ultrazohm/uz_d_voltage/Project Outputs for UZ_D_Voltage/Rev04/BOM/BOM_JLC-UZ_D_Voltage(3V3_to_RS422_output).xlsx

Quantity | Comment | Designator | Manufacturer | Value | Description | Footprint | Voltage | Dielectric | Manufacturer Part Number | LCSC Part Number
8 | 0.1 µF | C5A, C5B, C5C, C5D, C5E, C5F, C5G, C5H | KEMET | 0.1 µF | Capacitor 0603, 50 VDC, 0.1 µF, X7R | C_0603 |  |  | C0603X104K5RAC7411 | C14663
1 | #NAME? | D1 | Hubei KENTO Elec |  | LED RED 520~625NM 90~100MCD@20MA TOP VIEW 0603 ROHS | WL-SMCW_0603 |  |  | KT-0603R | C2286
61 | 0R | R1, R51, R52, R53, R54, R55, R56, R57, R58, R59, R60, R61, R62, R63, R64, R65, R66, R67, R68, R69, R70, R71, R72, R73, R74, R75, R76, R77, R78, R79, R80, R144, R145, R146, R147, R148, R149, R150, R151, R152, R153, R154, R155, R156, R157, R158, R159, R160, R161, R162, R163, R164, R165, R166, R167, R168, R169, R170, R171, R172, R173 | YAGEO | 0R | SMD resistor E24 series | RES 0603_1608 |  |  | RC0603JR-070RL | C21189
1 | 470R | R9 | KOA Speer | 470R | SMD resistor E24 series | RES 0603_1608 |  |  | RK73B1JTTD471J | C23179
60 | 47R | R81, R82, R83, R84, R85, R86, R87, R88, R89, R90, R91, R92, R93, R94, R95, R96, R97, R98, R99, R100, R101, R102, R103, R104, R105, R106, R107, R108, R109, R110, R111, R112, R113, R114, R115, R116, R117, R118, R119, R120, R121, R122, R123, R124, R125, R126, R127, R128, R129, R130, R131, R132, R133, R134, R135, R136, R137, R138, R139, R140 | KOA Speer | 47R | SMD resistor E24 series | RES 0603_1608 |  |  | RK73B1JTTDD470J | C23182
8 | DS26C31TMX/NOPB | U3A, U3B, U3C, U3D, U3E, U3F, U3G, U3H | Texas Instruments |  | CMOS Quad Tri-State Differential Line Drivers, 16-pin Narrow SOIC, Pb-Free | TI_D-R-PDSO-G16_N |  |  | DS26C31TMX/NOPB | C132085
1 | IPL1-115-01-L-D-RA-K | X2 | SAMTEC |  | Terminal Assembly, Double Row, Right Angle, Thru-Hole, 2.54 mm x 2.54 mm Pitch, 30 Pins | IPL1-115-01-XX-D-RA |  |  | IPL1-115-01-L-D-RA-K
1 | IPL1-120-01-L-D-RA-K | X3 | SAMTEC |  | Terminal Assembly, Double Row, Right Angle, Thru-Hole, 2.54 mm x 2.54 mm Pitch, 40 Pins | IPL1-120-01-XX-D-RA |  |  | IPL1-120-01-L-D-RA-K
