ultrazohm/uz_d_voltage/Project Outputs for UZ_D_Voltage/2v01/BOM/BOM_UltraZohm_DigitalVoltage_3V3_to_3V3_IO.xls

Sheet: Part List Report
 | Bill of Material |  |  | BOM_UltraZohm_Digital_Voltage_3V3_IO for Variant [3V3_to_3V3_IO] of BOM Document [UltraZohm_DigitalVoltage_ActiveBom.BomDoc]
 | Source Data From: |  | UltraZohm_DigitalVoltage_ActiveBom.BomDoc
 | Project: |  | ultrazohm_digital_voltage_3U_1vxx.PrjPCB
 | Variant: |  | 3V3_to_3V3_IO
 | Report Date: |  |  |  | 18.08.2020 | 18:56
 | Print Date: |  |  |  | 2020-08-18 | 18:56:55
# | Quantity | Name | Designator | MF | MPN | Value | Description | Footprint | Package | #Column Name Error:' Voltage | #Column Name Error:' Dielectric | Supplier 1 | Supplier Part Number 1 | #Column Name Error:' Supplier 2 | #Column Name Error:' Supplier Part Number 2 | Supplier 3 | #Column Name Error:' Supplier Part Number 3 | Fabrication Notes
1 | 1 | LED_Amber | D1 | Wuerth Elektronik | 150060AS75000 | 150060AS75000 | WL-SMCW SMD Mono-color Chip LED Waterclear, size 0603, Red, 2 V, 140° | WL-SMCW_0603 | 0603 |  |  | Digi-Key | 732-150060AS75000CT-ND |  |  | Farnell
2 | 90 | R_TF | R3A, R3B, R3C, R3D, R3E, R4A, R4B, R4C, R4D, R4E, R5A, R5B, R5C, R5D, R5E, R6A, R6B, R6C, R6D, R6E, R7A, R7B, R7C, R7D, R7E, R8A, R8B, R8C, R8D, R8E, R21, R22, R23, R24, R25, R26, R27, R28, R29, R30, R31, R32, R33, R34, R35, R36, R37, R38, R39, R40, R41, R42, R43, R44, R45, R46, R47, R48, R49, R50, R51, R52, R53, R54, R55, R56, R57, R58, R59, R60, R61, R62, R63, R64, R65, R66, R67, R68, R69, R70, R71, R72, R73, R74, R75, R76, R77, R78, R79, R80 | Panasonic | ERJU030R00V | 0 | Standard thick film resistor | RESC_0603 | CurrentFootprint |  |  | Mouser | 667-ERJ-U030R00V
3 | 2 | R_TF | R9, R10 | Panasonic | ERJU03F5601V | 5k6 | Standard thick film resistor | RESC_0603 | RESC_0603 |  |  | Mouser | 667-ERJ-U03F5601V
4 | 30 | R_TF | R82, R84, R85, R87, R90, R92, R93, R95, R98, R100, R101, R103, R106, R108, R109, R111, R114, R116, R117, R119, R122, R124, R125, R127, R130, R132, R133, R135, R138, R139 | Panasonic | ERJU03F91R0V | 91 | Standard thick film resistor | RESC_0603 | CurrentFootprint |  |  | RSComponents | 8739618
Total: | 123 |  |  |  |  | Notes

Sheet: Project Information
Project Full Path | C:\Users\Thilo Wendt\Documents\altium\ultrazohm_digital_voltage_3U_1vxx\ultrazohm_digital_voltage_3U_1vxx.PrjPCB
Project Filename | ultrazohm_digital_voltage_3U_1vxx.PrjPCB
Variant Name | 3V3_to_3V3_IO
Data-Source Filename | UltraZohm_DigitalVoltage_ActiveBom.BomDoc
Data-Source Full Path | C:\Users\Thilo Wendt\Documents\altium\ultrazohm_digital_voltage_3U_1vxx\UltraZohm_DigitalVoltage_ActiveBom.BomDoc
Title | BOM_UltraZohm_Digital_Voltage_3V3_IO for Variant [3V3_to_3V3_IO] of BOM Document [UltraZohm_DigitalVoltage_ActiveBom.BomDoc]
Total Quantity | 123
Report Time | 18:56
Report Date | 18.08.2020
Report Date & Tine | 18.08.2020 18:56
Output Name | BOM_UltraZohm_Digital_Voltage_3V3_IO
Output Type | BOM_PartType
Output Generator Name | BOM
Output Generator Description | Bill of Materials
