ultrazohm/uz_d_voltage/Project Outputs for UZ_D_Voltage/2v01/BOM/BOM_UltraZohm_DigitalVoltage_3V3_to_5V_IO.xls

Sheet: Part List Report
 | Bill of Material |  |  | BOM_UltraZohm_Digital_Voltage_5V_IO for Variant [3V3_to_5V_IO] of BOM Document [UltraZohm_DigitalVoltage_ActiveBom.BomDoc]
 | Source Data From: |  | UltraZohm_DigitalVoltage_ActiveBom.BomDoc
 | Project: |  | ultrazohm_digital_voltage_3U_1vxx.PrjPCB
 | Variant: |  | 3V3_to_5V_IO
 | Report Date: |  |  |  | 18.08.2020 | 18:56
 | Print Date: |  |  |  | 2020-08-18 | 18:57:01
# | Quantity | Name | Designator | MF | MPN | Value | Description | Footprint | Package | #Column Name Error:' Voltage | #Column Name Error:' Dielectric | Supplier 1 | Supplier Part Number 1 | Supplier 2 | Supplier Part Number 2 | #Column Name Error:' Supplier 3 | #Column Name Error:' Supplier Part Number 3 | Fabrication Notes
1 | 8 | C_X7R | C1A, C1B, C2A, C2B, C3A, C3B, C4A, C4B | KEMET | C0603C104J3REC7411 | 100n | Standard X7R SMD capacitor. This kind of dielectricum should be used for decoupling applications. Bigger capacity is available but not for the given voltage rating. | CAPC_0603 | CurrentFootprint |  |  | Mouser | 80-C0603C104J3RE7411 | Mouser | 80-C0603C104J3RE7411
2 | 1 | LED_Blue | D1 | Wuerth Elektronik | 150060BS75000 | 150060BS75000 | WL-SMCW SMD Mono-color Chip LED Waterclear, size 0603, Blue, 3.2 V, 140° | WL-SMCW_0603 | 0603 |  |  | Digi-Key | 732-4966-1-ND
3 | 2 | R_TF | R1, R20 | Panasonic | ERJU030R00V | 0 | Solder resistor/jumper between pads 1 and 2 for standard function. Solder resistor between pads 2 and 3 for alternative function | RESC_0603_CONFIG | CurrentFootprint, RESC_0603_CONFIG |  |  | Mouser | 667-ERJ-U030R00V
4 | 60 | R_TF | R3A, R3B, R3C, R3D, R3E, R4A, R4B, R4C, R4D, R4E, R5A, R5B, R5C, R5D, R5E, R6A, R6B, R6C, R6D, R6E, R7A, R7B, R7C, R7D, R7E, R8A, R8B, R8C, R8D, R8E, R21, R22, R23, R24, R25, R26, R27, R28, R29, R30, R31, R32, R33, R34, R35, R36, R37, R38, R39, R40, R41, R42, R43, R44, R45, R46, R47, R48, R49, R50 | Panasonic | ERJU030R00V | 0 | Standard thick film resistor | RESC_0603 | CurrentFootprint |  |  | Mouser | 667-ERJ-U030R00V
5 | 11 | R_TF | R9, R10, R11, R16A, R16B, R17A, R17B, R18A, R18B, R19A, R19B | Panasonic | ERJU03F5601V | 5k6 | Standard thick film resistor | RESC_0603 | RESC_0603, CurrentFootprint |  |  | Mouser | 667-ERJ-U03F5601V
6 | 30 | R_TF | R82, R84, R85, R87, R90, R92, R93, R95, R98, R100, R101, R103, R106, R108, R109, R111, R114, R116, R117, R119, R122, R124, R125, R127, R130, R132, R133, R135, R138, R139 | Panasonic | ERJU03F91R0V | 91 | Standard thick film resistor | RESC_0603 | CurrentFootprint |  |  | RSComponents | 8739618
7 | 1 | 74AHC1G14GW,125 | U1 |  |  | 74AHC1G14GW,125 | Inverting Schmitt trigger for 2 V to 5.5 V | NXP-SOT353-1_N |  |  |  | Mouser | 771-74AHC1G14GW-G
8 | 2 | SN74LVCH16T245DLR | U6A, U6B | Texas Instruments | SN74LVCH16T245DLR | SN74LVCH16T245DLR | Direction controlled 16 channel level shifter with active driver. Voltage range 1.8V to 5V. | TI_DL-R-PDSO-G48_N | CurrentFootprint |  |  | Mouser | 595-SN74LVCH16T245LR
Total: | 115 |  |  |  |  | Notes

Sheet: Project Information
Project Full Path | C:\Users\Thilo Wendt\Documents\altium\ultrazohm_digital_voltage_3U_1vxx\ultrazohm_digital_voltage_3U_1vxx.PrjPCB
Project Filename | ultrazohm_digital_voltage_3U_1vxx.PrjPCB
Variant Name | 3V3_to_5V_IO
Data-Source Filename | UltraZohm_DigitalVoltage_ActiveBom.BomDoc
Data-Source Full Path | C:\Users\Thilo Wendt\Documents\altium\ultrazohm_digital_voltage_3U_1vxx\UltraZohm_DigitalVoltage_ActiveBom.BomDoc
Title | BOM_UltraZohm_Digital_Voltage_5V_IO for Variant [3V3_to_5V_IO] of BOM Document [UltraZohm_DigitalVoltage_ActiveBom.BomDoc]
Total Quantity | 115
Report Time | 18:56
Report Date | 18.08.2020
Report Date & Tine | 18.08.2020 18:56
Output Name | BOM_UltraZohm_Digital_Voltage_5V_IO
Output Type | BOM_PartType
Output Generator Name | BOM
Output Generator Description | Bill of Materials
