ultrazohm/uz_d_voltage/Project Outputs for UZ_D_Voltage/2v01/BOM/BOM_UltraZohm_DigitalVoltage_3V3_to_RS422_output.xls

Sheet: Part List Report
 | Bill of Material |  |  | BOM_UltraZohm_Digital_Voltage_RS422_output for Variant [3V3_to_RS422_output] of BOM Document [UltraZohm_DigitalVoltage_ActiveBom.BomDoc]
 | Source Data From: |  | UltraZohm_DigitalVoltage_ActiveBom.BomDoc
 | Project: |  | ultrazohm_digital_voltage_3U_1vxx.PrjPCB
 | Variant: |  | 3V3_to_RS422_output
 | Report Date: |  |  |  | 18.08.2020 | 18:55
 | Print Date: |  |  |  | 2020-08-18 | 18:55:41
# | Quantity | Name | Designator | MF | MPN | Value | Description | Footprint | Package | #Column Name Error:' Voltage | #Column Name Error:' Dielectric | Supplier 1 | Supplier Part Number 1 | Supplier 2 | Supplier Part Number 2 | #Column Name Error:' Supplier 3 | #Column Name Error:' Supplier Part Number 3 | Fabrication Notes
1 | 8 | C_X7R | C5A, C5B, C5C, C5D, C5E, C5F, C5G, C5H | KEMET | C0603C104J3REC7411 | 100n | Standard X7R SMD capacitor. This kind of dielectricum should be used for decoupling applications. Bigger capacity is available but not for the given voltage rating. | CAPC_0603 | CurrentFootprint |  |  | Mouser | 80-C0603C104J3RE7411 | Mouser | 80-C0603C104J3RE7411
2 | 1 | LED_red | D1 | Wuerth Elektronik | 150060RS75000 | 150060RS75000 | WL-SMCW SMD Mono-color Chip LED Waterclear, size 0603, Red, 2 V, 140° | WL-SMCW_0603 | 0603 |  |  | Digi-Key | 732-4978-1-ND
3 | 2 | R_TF | R9, R10 | Panasonic | ERJU03F5601V | 5k6 | Standard thick film resistor | RESC_0603 | RESC_0603 |  |  | Mouser | 667-ERJ-U03F5601V
4 | 1 | R_TF | R20 | Panasonic | ERJU030R00V | 0 | Solder resistor/jumper between pads 1 and 2 for standard function. Solder resistor between pads 2 and 3 for alternative function | RESC_0603_CONFIG | RESC_0603_CONFIG |  |  | Mouser | 667-ERJ-U030R00V
5 | 30 | R_TF | R51, R52, R53, R54, R55, R56, R57, R58, R59, R60, R61, R62, R63, R64, R65, R66, R67, R68, R69, R70, R71, R72, R73, R74, R75, R76, R77, R78, R79, R80 | Panasonic | ERJU030R00V | 0 | Standard thick film resistor | RESC_0603 | CurrentFootprint |  |  | Mouser | 667-ERJ-U030R00V
6 | 60 | R_TF | R81, R82, R83, R84, R85, R86, R87, R88, R89, R90, R91, R92, R93, R94, R95, R96, R97, R98, R99, R100, R101, R102, R103, R104, R105, R106, R107, R108, R109, R110, R111, R112, R113, R114, R115, R116, R117, R118, R119, R120, R121, R122, R123, R124, R125, R126, R127, R128, R129, R130, R131, R132, R133, R134, R135, R136, R137, R138, R139, R140 | Panasonic | ERJU03F47R0V | 47 | Standard thick film resistor | RESC_0603 | CurrentFootprint |  |  | Mouser | 667-ERJ-U03F47R0V
7 | 8 | DS26C31T | U3A, U3B, U3C, U3D, U3E, U3F, U3G, U3H | Texas Instruments | DS26C31TMX/NOPB | DS26C31T | CMOS Quad Tri-State Differential Line Drivers, 16-pin Narrow SOIC, Pb-Free | TI_D-R-PDSO-G16_N | CurrentFootprint |  |  | Farnell | 3119096
Total: | 110 |  |  |  |  | Notes

Sheet: Project Information
Project Full Path | C:\Users\Thilo Wendt\Documents\altium\ultrazohm_digital_voltage_3U_1vxx\ultrazohm_digital_voltage_3U_1vxx.PrjPCB
Project Filename | ultrazohm_digital_voltage_3U_1vxx.PrjPCB
Variant Name | 3V3_to_RS422_output
Data-Source Filename | UltraZohm_DigitalVoltage_ActiveBom.BomDoc
Data-Source Full Path | C:\Users\Thilo Wendt\Documents\altium\ultrazohm_digital_voltage_3U_1vxx\UltraZohm_DigitalVoltage_ActiveBom.BomDoc
Title | BOM_UltraZohm_Digital_Voltage_RS422_output for Variant [3V3_to_RS422_output] of BOM Document [UltraZohm_DigitalVoltage_ActiveBom.BomDoc]
Total Quantity | 110
Report Time | 18:55
Report Date | 18.08.2020
Report Date & Tine | 18.08.2020 18:55
Output Name | BOM_UltraZohm_Digital_Voltage_RS422_output
Output Type | BOM_PartType
Output Generator Name | BOM
Output Generator Description | Bill of Materials
