ultrazohm/uz_d_voltage/Project Outputs for UZ_D_Voltage/1v00/BOM/3V3_to_15V.xls

Sheet: BOM Report
Bill of Materials |  |  | Bill of Materials for Variant [3V3_to_15V] of BOM Document [ultrazohm_digital_voltage_3U_1vxx.BomDoc]
Source Data From: |  | ultrazohm_digital_voltage_3U_1vxx.BomDoc
Project: |  | ultrazohm_digital_voltage_3U_1vxx.PrjPCB
Variant: |  | 3V3_to_15V
Creation Date: | 03.02.2020 | 12:07
Print Date: | 2020-02-03 | 12:08:52
Production Quantity: | 1
Currency | USD
Footprint | Name | LibRef | Designator | Description | Quantity | Supplier 1 | Supplier Part Number 1 | Supplier Unit Price 1 | Supplier Order Qty 1 | Supplier Subtotal 1 | Manufacturer 1 | Manufacturer Part Number 1 | Manufacturer Lifecycle 1
CAPC3216X180X50NL20T25 | C_X7R | C_X7R_MEDIUM | C1, C2, C3, C4, C5, C6, C7, C8, C9, C10, C11, C12, C13, C14, C15, C16 | Standard X7R SMD capacitor. This kind of dielectricum should be used for decoupling applications. Bigger capacity is available but not for the given voltage rating. | 16 | Mouser | 80-C1206C104J5R | 0.071 | 16 | 1.14 | KEMET | C1206C104J5RACTU | Volume Production
CAPAE9583X66L | C_ALEL | C_ALEL_47u | C17, C22 | Standard Aluminium electrolyt capacitor. | 2 | Mouser | 667-EEE-1VA470P | 0.48 | 2 | 0.96 | Panasonic | EEE-1VA470P | Volume Production
CAPC3216X180X50NL20T25 | C_X7R | C_X7R_SMALL | C18, C19, C20, C21 | Standard X7R SMD capacitor. This kind of dielectricum should be used for decoupling applications. Bigger capacity is available but not for the given voltage rating. | 4 | Mouser | 80-C1206C104J5R | 0.17 | 4 | 0.68 | KEMET | C1206C104J5RACTU | Volume Production
WL-SMCW_0603 | LED_Green | LED_Green | D3 | WL-SMCW SMD Mono-color Chip LED Waterclear, size 0603, Green, 3.2 V, 140° | 1 | Mouser | 710-150060GS75000 | 0.15 | 1 | 0.15 | Wurth Electronics | 150060GS75000 | Volume Production
IPL1-115-01-XX-D-RA | IPL1-115-01-XX-D-RA | IPL1-115-01-XX-D-RA | J1 | Terminal Assembly, Double Row, Right Angle, Thru-Hole, 0.100" x 0.100" Pitch, 30 Pins. | 1 | RSComponents | 1586159 | 2.51 | 1 | 2.51 | Samtec | IPL1-115-01-L-D-RA-K | Volume Production
IPL1-120-01-XX-D-RA | IPL1-120-01-XX-D-RA | IPL1-120-01-XX-D-RA | J2 | Terminal Assembly, Double Row, Right Angle, Thru-Hole, 0.100" x 0.100" Pitch, 40 Pins. | 1 | RSComponents | 1803537 | 5.74 | 1 | 5.74 | Samtec | IPL1-120-01-L-D-RA-K | Volume Production
RESC3216X70X50LL20T25_CONFIG | R_TF | R_0.5W_SMD_config | R2 | Solder resistor/jumper between pads 1 and 2 for standard function. Solder resistor between pads 2 and 3 for alternative function | 1 | Mouser | 667-ERJ-U080R00V | 0.16 | 1 | 0.16 | Panasonic | ERJU080R00V | Volume Production
RESC1608X55X30NL15T15 | R_TF | R_0.1W_SMD | R11 | Standard thick film resistor | 1 | Mouser | 667-ERJ-U03F2701V | 0.13 | 1 | 0.13 | Panasonic | ERJU03F2701V | Volume Production
RESCAXE-50P380X160X45-16N | R_ARRAY | 8xR-Array_1_part | R15, R16, R17, R18 | Standard thick film resistor array with 8 resistors | 4 | Mouser | 667-EXB-2HVR000V | 0.29 | 4 | 1.16 | Panasonic | EXB-2HVR000V | Volume Production
RESCAXE-50P380X160X45-16N | R_ARRAY | 8xR-Array | R22 | Standard thick film resistor array with 8 resistors | 1 | Mouser | 667-EXB-2HVR000V | 0.29 | 1 | 0.29 | Panasonic | EXB-2HVR000V | Volume Production
RESCAXE-50P380X160X45-16N | R_ARRAY | 8xR-Array_1_part | R23, R24, R25, R26, R27, R28, R29 | Standard thick film resistor array with 8 resistors | 7 | Mouser | 667-EXB-2HV750JV | 0.18 | 10 | 1.80 | Panasonic | EXB-2HV750JV | Volume Production
RESCAXE-50P380X160X45-16N | R_ARRAY | 8xR-Array | R30 | Standard thick film resistor array with 8 resistors | 1 | Mouser | 667-EXB-2HV750JV | 0.45 | 1 | 0.45 | Panasonic | EXB-2HV750JV | Volume Production
RESC1608X55X30NL15T15 | R_TF | R_0.1W_SMD | R31, R32 | Standard thick film resistor | 2 | Mouser | 667-ERJ-U030R00V | 0.1 | 2 | 0.20 | Panasonic | ERJ-U030R00V | Volume Production
RESC1608X55X30NL15T15 | R_TF | R_0.1W_SMD | R33A, R33B, R34A, R34B, R35A, R35B, R36A, R36B | Standard thick film resistor | 8 | Mouser | 667-ERJ-U03F1002V | 0.087 | 10 | 0.87 | Panasonic | ERJU03F1002V | Volume Production
RESC3216X70X50LL20T25_CONFIG | ENABLE | R_0.5W_SMD_config | R37 | Solder resistor/jumper between pads 1 and 2 for standard function. Solder resistor between pads 2 and 3 for alternative function | 1 | Mouser | 667-ERJ-U080R00V | 0.16 | 1 | 0.16 | Panasonic | ERJU080R00V | Volume Production
NXP-SOT353-1_N | 74AHC1G14GW,125 | 74AHCX1G14-5 | U1 | Inverting Schmitt trigger for 2 V to 5.5 V | 1 | Mouser | 771-74AHC1G14GW-G | 0.22 | 1 | 0.22 | Nexperia | 74AHC1G14GW,125 | Unknown
SOIC127P600X175-16N | MC14504BDR2G | MC14504BDR2G | U2A, U2B, U2C, U2D, U2E | 6 Channel 5V to 15V level shifter | 5 | Mouser | 863-MC14504BDR2G | 0.87 | 5 | 4.35 | ON Semiconductor | MC14504BDR2G | Volume Production
R78C1510 | R-78C15-1.0 | R-78C15-1.0 | U5 | Swichting Regulator Power Supply with integrated inductor. | 1 | Mouser | 919-R-78C15-1.0 | 10.56 | 1 | 10.56 | Recom | R-78C15-1.0 | Volume Production
TI_DL-R-PDSO-G48_N | SN74LVCH16T245DLR | SN74LVCH16T245DLR | U6A, U6B | Direction controlled 16 channel level shifter with active driver. Voltage range 1.8V to 5V. | 2 | Mouser | 595-SN74LVCH16T245LR | 2.53 | 2 | 5.06 | Texas Instruments | SN74LVCH16T245DLR | Volume Production
 |  |  |  |  | 60 |  |  |  |  | $36.59
Approved |  | Notes

Sheet: Project Information
Project Full Path | D:\altium\ultrazohm_digital_voltage_3U_1vxx\ultrazohm_digital_voltage_3U_1vxx.PrjPCB
Project Filename | ultrazohm_digital_voltage_3U_1vxx.PrjPCB
Variant Name | 3V3_to_15V
Data-Source Filename | ultrazohm_digital_voltage_3U_1vxx.BomDoc
Data-Source Full Path | D:\altium\ultrazohm_digital_voltage_3U_1vxx\ultrazohm_digital_voltage_3U_1vxx.BomDoc
Title | Bill of Materials for Variant [3V3_to_15V] of BOM Document [ultrazohm_digital_voltage_3U_1vxx.BomDoc]
Total Quantity | 60
Report Time | 12:07
Report Date | 03.02.2020
Report Date & Tine | 03.02.2020 12:07
Output Name | Bill of Materials
Output Type | BOM_PartType
Output Generator Name | BOM
Output Generator Description | Bill of Materials
