ultrazohm/uz_d_voltage/Project Outputs for UZ_D_Voltage/1v00/BOM/3V3_to_diff.xls

Sheet: BOM Report
Bill of Materials |  |  | Bill of Materials for Variant [3V3_to_RS422] of BOM Document [ultrazohm_digital_voltage_3U_1vxx.BomDoc]
Source Data From: |  | ultrazohm_digital_voltage_3U_1vxx.BomDoc
Project: |  | ultrazohm_digital_voltage_3U_1vxx.PrjPCB
Variant: |  | 3V3_to_RS422
Creation Date: | 03.02.2020 | 12:21
Print Date: | 2020-02-03 | 12:22:31
Production Quantity: | 2
Currency | USD
Footprint | Name | LibRef | Designator | Description | Quantity | Supplier 1 | Supplier Part Number 1 | Supplier Unit Price 1 | Supplier Order Qty 1 | Supplier Subtotal 1 | Manufacturer 1 | Manufacturer Part Number 1 | Manufacturer Lifecycle 1
CAPC3216X180X50NL20T25 | C_X7R | C_X7R_MEDIUM | C1, C2, C3, C4, C5, C6, C7, C8, C9, C10, C11, C12, C13, C14, C15, C16 | Standard X7R SMD capacitor. This kind of dielectricum should be used for decoupling applications. Bigger capacity is available but not for the given voltage rating. | 16 | Mouser | 80-C1206C104J5R | 0.071 | 32 | 2.27 | KEMET | C1206C104J5RACTU | Volume Production
WL-SMCW_0603 | LED_red | LED_Red | D4 | WL-SMCW SMD Mono-color Chip LED Waterclear, size 0603, Red, 2 V, 140° | 1 | Mouser | 710-150060RS75000 | 0.14 | 2 | 0.28 | Wurth Electronics | 150060RS75000 | Volume Production
IPL1-115-01-XX-D-RA | IPL1-115-01-XX-D-RA | IPL1-115-01-XX-D-RA | J1 | Terminal Assembly, Double Row, Right Angle, Thru-Hole, 0.100" x 0.100" Pitch, 30 Pins. | 1 | RSComponents | 1586159 | 2.51 | 2 | 5.02 | Samtec | IPL1-115-01-L-D-RA-K | Volume Production
IPL1-120-01-XX-D-RA | IPL1-120-01-XX-D-RA | IPL1-120-01-XX-D-RA | J2 | Terminal Assembly, Double Row, Right Angle, Thru-Hole, 0.100" x 0.100" Pitch, 40 Pins. | 1 | RSComponents | 1803537 | 5.74 | 2 | 11.48 | Samtec | IPL1-120-01-L-D-RA-K | Volume Production
RESC1608X55X30NL15T15 | R_TF | R_0.1W_SMD | R12 | Standard thick film resistor | 1 | Mouser | 667-ERJ-U03F1501V | 0.13 | 2 | 0.26 | Panasonic | ERJU03F1501V | Volume Production
RESCAXE-50P380X160X45-16N | R_ARRAY | 8xR-Array_1_part | R14, R15, R16, R17, R18 | Standard thick film resistor array with 8 resistors | 5 | Mouser | 667-EXB-2HVR000V | 0.13 | 10 | 1.30 | Panasonic | EXB-2HVR000V | Volume Production
RESCAXE-50P380X160X45-16N | R_ARRAY | 8xR-Array | R19, R20, R21, R22 | Standard thick film resistor array with 8 resistors | 4 | Mouser | 667-EXB-2HVR000V | 0.13 | 10 | 1.30 | Panasonic | EXB-2HVR000V | Volume Production
RESCAXE-50P380X160X45-16N | R_ARRAY | 8xR-Array_1_part | R23, R24, R25, R26, R27, R28, R29 | Standard thick film resistor array with 8 resistors | 7 | Mouser | 667-EXB-2HV750JV | 0.18 | 14 | 2.52 | Panasonic | EXB-2HV750JV | Volume Production
RESCAXE-50P380X160X45-16N | R_ARRAY | 8xR-Array | R30 | Standard thick film resistor array with 8 resistors | 1 | Mouser | 667-EXB-2HV750JV | 0.45 | 2 | 0.90 | Panasonic | EXB-2HV750JV | Volume Production
RESC1608X55X30NL15T15 | R_TF | R_0.1W_SMD | R31, R32 | Standard thick film resistor | 2 | Mouser | 667-ERJ-U030R00V | 0.1 | 4 | 0.40 | Panasonic | ERJ-U030R00V | Volume Production
RESC3216X70X50LL20T25_CONFIG | ENABLE | R_0.5W_SMD_config | R37 | Solder resistor/jumper between pads 1 and 2 for standard function. Solder resistor between pads 2 and 3 for alternative function | 1 | Mouser | 667-ERJ-U080R00V | 0.16 | 2 | 0.32 | Panasonic | ERJU080R00V | Volume Production
TI_D-R-PDSO-G16_L | DS26C31T | DS26C31TMX | U3A, U3B, U3C, U3D, U3E, U3F, U3G, U3H | CMOS Quad Tri-State Differential Line Drivers, 16-pin Narrow SOIC, Pb-Free | 8 | Mouser | 926-DS26C31TMX/NOPB | 1.39 | 16 | 22.24 | TI National Semiconductor | DS26C31TMX/NOPB | Volume Production
 |  |  |  |  | 48 |  |  |  |  | $48.29
Approved |  | Notes

Sheet: Project Information
Project Full Path | D:\altium\ultrazohm_digital_voltage_3U_1vxx\ultrazohm_digital_voltage_3U_1vxx.PrjPCB
Project Filename | ultrazohm_digital_voltage_3U_1vxx.PrjPCB
Variant Name | 3V3_to_RS422
Data-Source Filename | ultrazohm_digital_voltage_3U_1vxx.BomDoc
Data-Source Full Path | D:\altium\ultrazohm_digital_voltage_3U_1vxx\ultrazohm_digital_voltage_3U_1vxx.BomDoc
Title | Bill of Materials for Variant [3V3_to_RS422] of BOM Document [ultrazohm_digital_voltage_3U_1vxx.BomDoc]
Total Quantity | 48
Report Time | 12:21
Report Date | 03.02.2020
Report Date & Tine | 03.02.2020 12:21
Output Name | Bill of Materials
Output Type | BOM_PartType
Output Generator Name | BOM
Output Generator Description | Bill of Materials
