ultrazohm/uz_d_voltage/Project Outputs for UZ_D_Voltage/1v00/Order/invoice_jlc.pdf

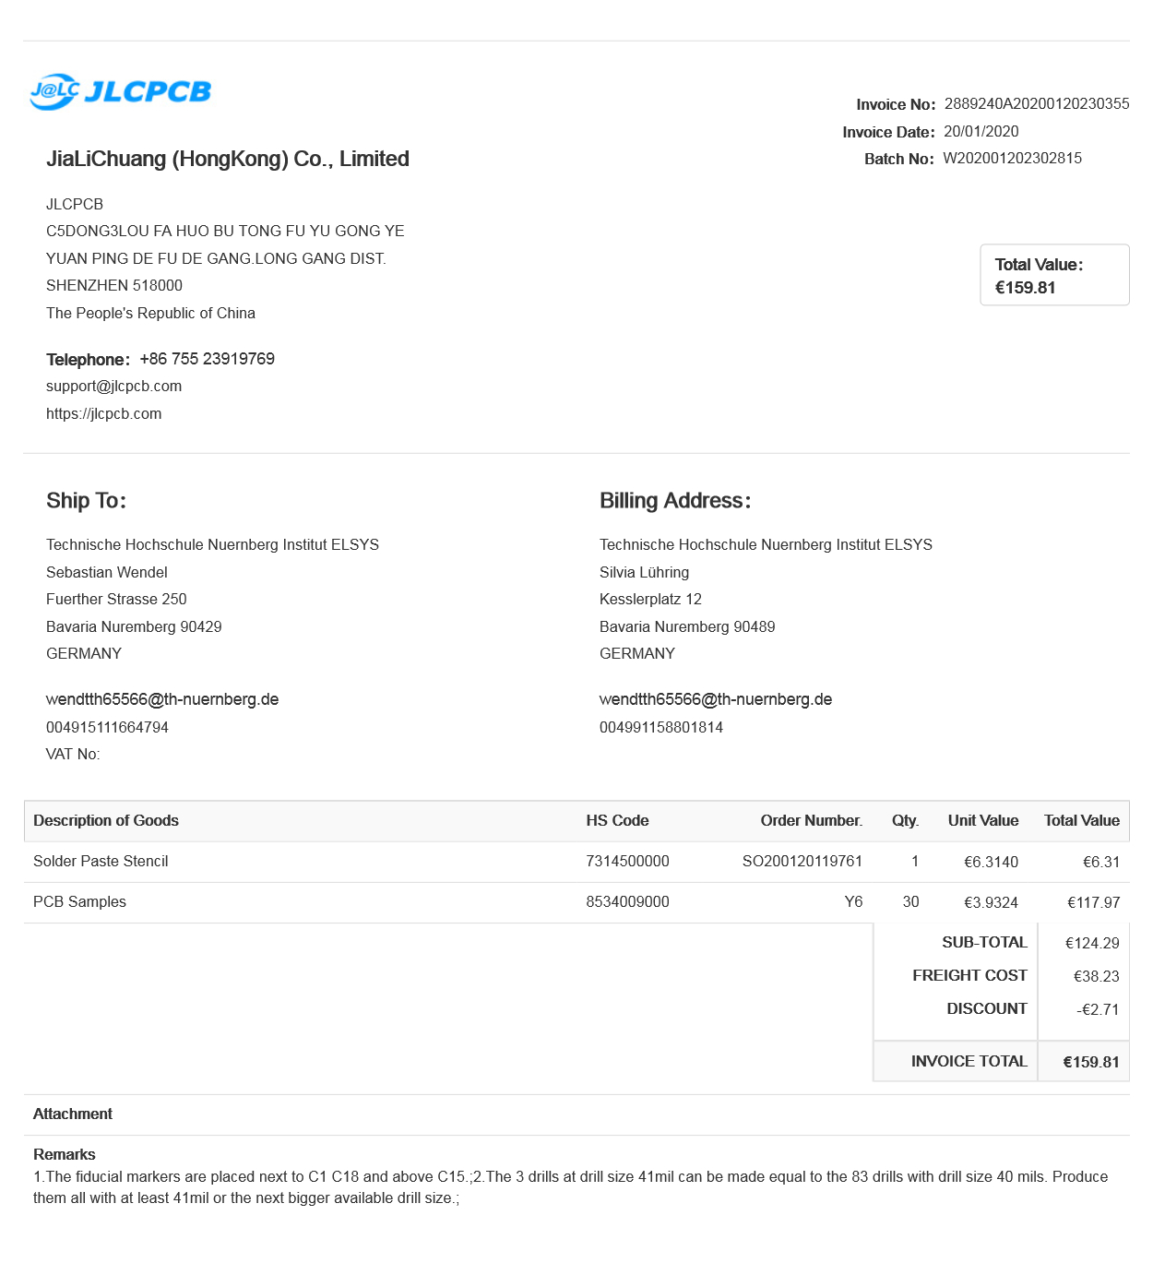
[picture p1: page 1]
