ultrazohm/uz_d_voltage/Project Outputs for UZ_D_Voltage/Rev04/BOM/BOM_UZ_D_Voltage_3V3_to_15V_output.xlsx

Comment | Designator | Footprint | LCSC Part #
0.1 µF | C1A, C1B, C2A, C2B, C3A, C3B, C4A, C4B, C18, C19, C20, C21, C23A, C23B, C23C, C23D, C23E, C24A, C24B, C24C, C24D, C24E | C_0603 | C14663
47 µF | C17, C22 | CAPAE830X650N | C336247
#NAME? | D1 | WL-SMCW_0603 | C72043
0R | R1, R12, R21, R22, R23, R24, R25, R26, R27, R28, R29, R30, R31, R32, R33, R34, R35, R36, R37, R38, R39, R40, R41, R42, R43, R44, R45, R46, R47, R48, R49, R50 | RES 0603_1608 | C21189
470R | R9, R10 | RES 0603_1608 | C23179
5k6 | R16A, R16B, R17A, R17B, R18A, R18B, R19A, R19B | RES 0603_1608 | C23189
47R | R82, R84, R85, R87, R90, R92, R93, R95, R98, R100, R101, R103, R106, R108, R109, R111, R114, R116, R117, R119, R122, R124, R125, R127, R130, R132, R133, R135, R138, R139 | RES 0603_1608 | C23182
39R | R144, R145, R146, R147, R148, R149, R150, R151, R152, R153, R154, R155, R156, R157, R158, R159, R160, R161, R162, R163, R164, R165, R166, R167, R168, R169, R170, R171, R172, R173 | RES 0603_1608 | C23154
74AHC1G14GW,125 | U1 | SOT353-1_N | C282410
MC14504BDR2G | U2A, U2B, U2C, U2D, U2E | SOIC127P600X175-16N | C7291
R-78C15-1.0 | U5 | R78C1510
SN74LVCH16T245DGGR | U6A, U6B | TI_DGG-R-PDSO-G48N | C352975
IPL1-115-01-L-D-RA-K | X2 | IPL1-115-01-XX-D-RA
IPL1-120-01-L-D-RA-K | X3 | IPL1-120-01-XX-D-RA
