ultrazohm/uz_d_voltage/Project Outputs for UZ_D_Voltage/3v00/DOC/DFT_UltraZohm_Digital_Voltage_Draftsman.PDF

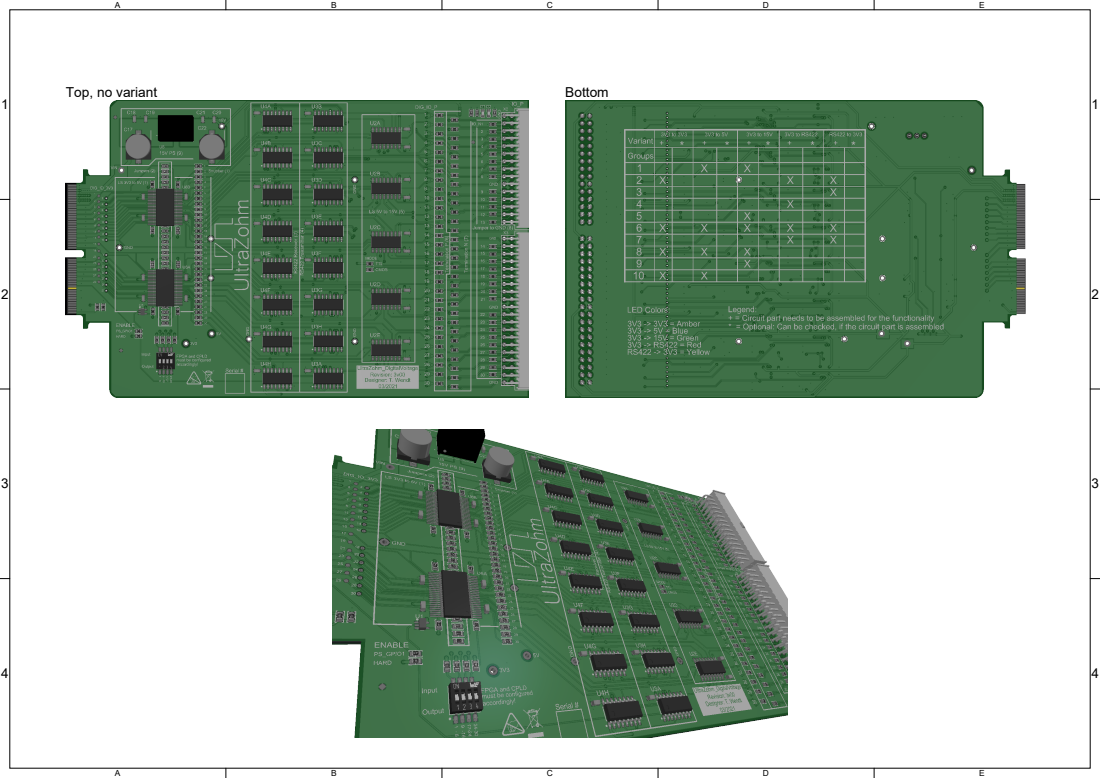
[picture p6: page 1]

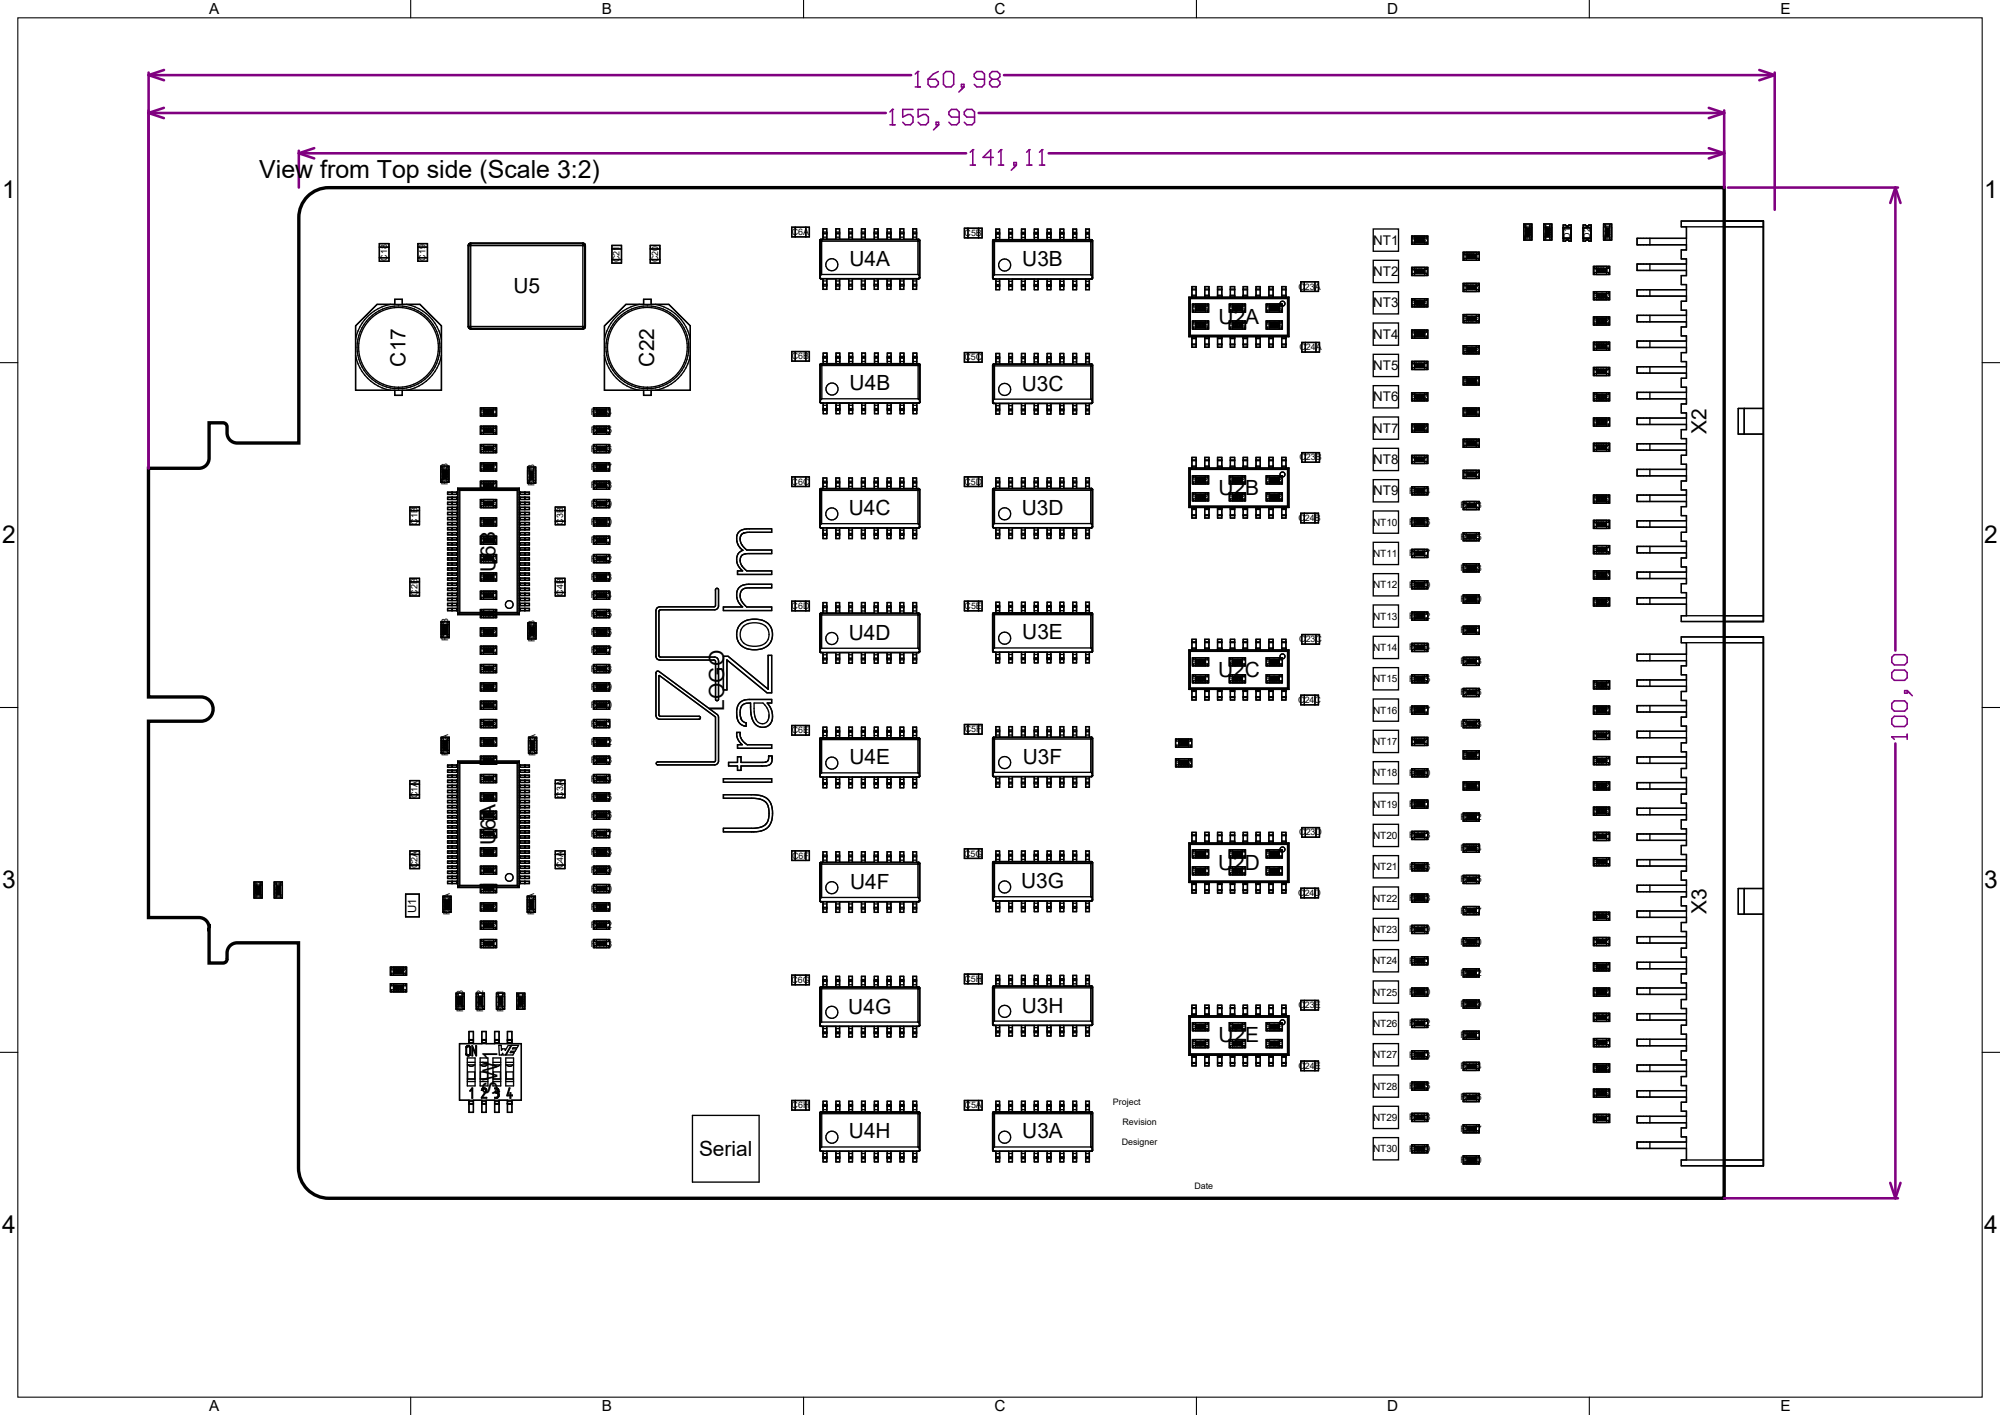
[picture p7: page 2]

View from Top side (Scale 3:2)

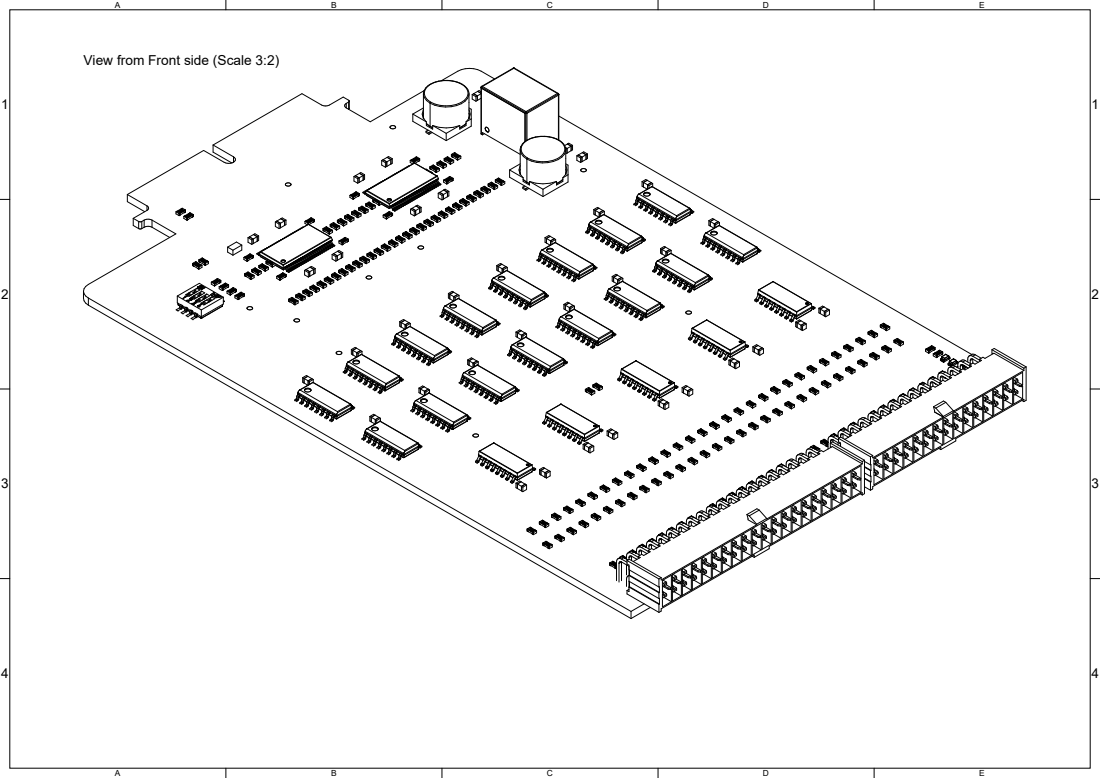
[picture p8: page 3]

View from Front side (Scale 3:2)


Symbol | Count | Hole Size | Plated | Hole Tolerance

618 | 0.30mm | Plated
80 | 1.02mm | Plated
3 | 1.05mm | Plated
701 Total
