ultrazohm/uz_d_voltage/Project Outputs for UZ_D_Voltage/2v01/DOC/DFT_UltraZohm_Digital_Voltage_Draftsman.PDF

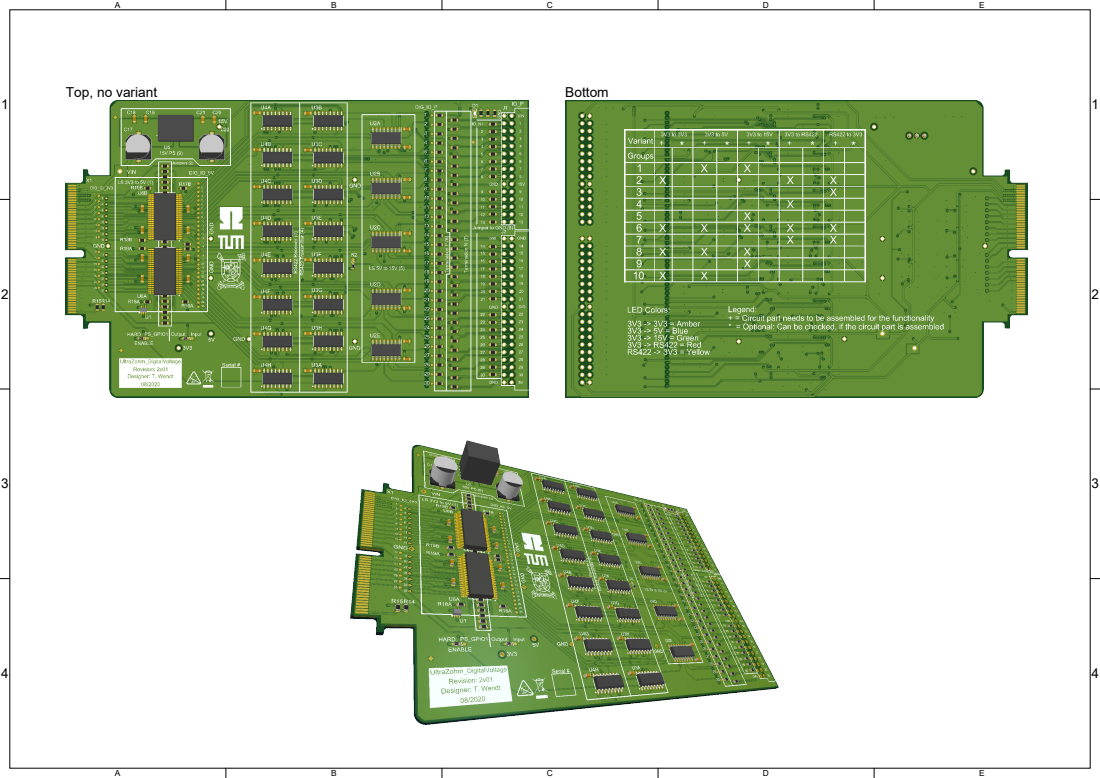
[picture p9: page 1]

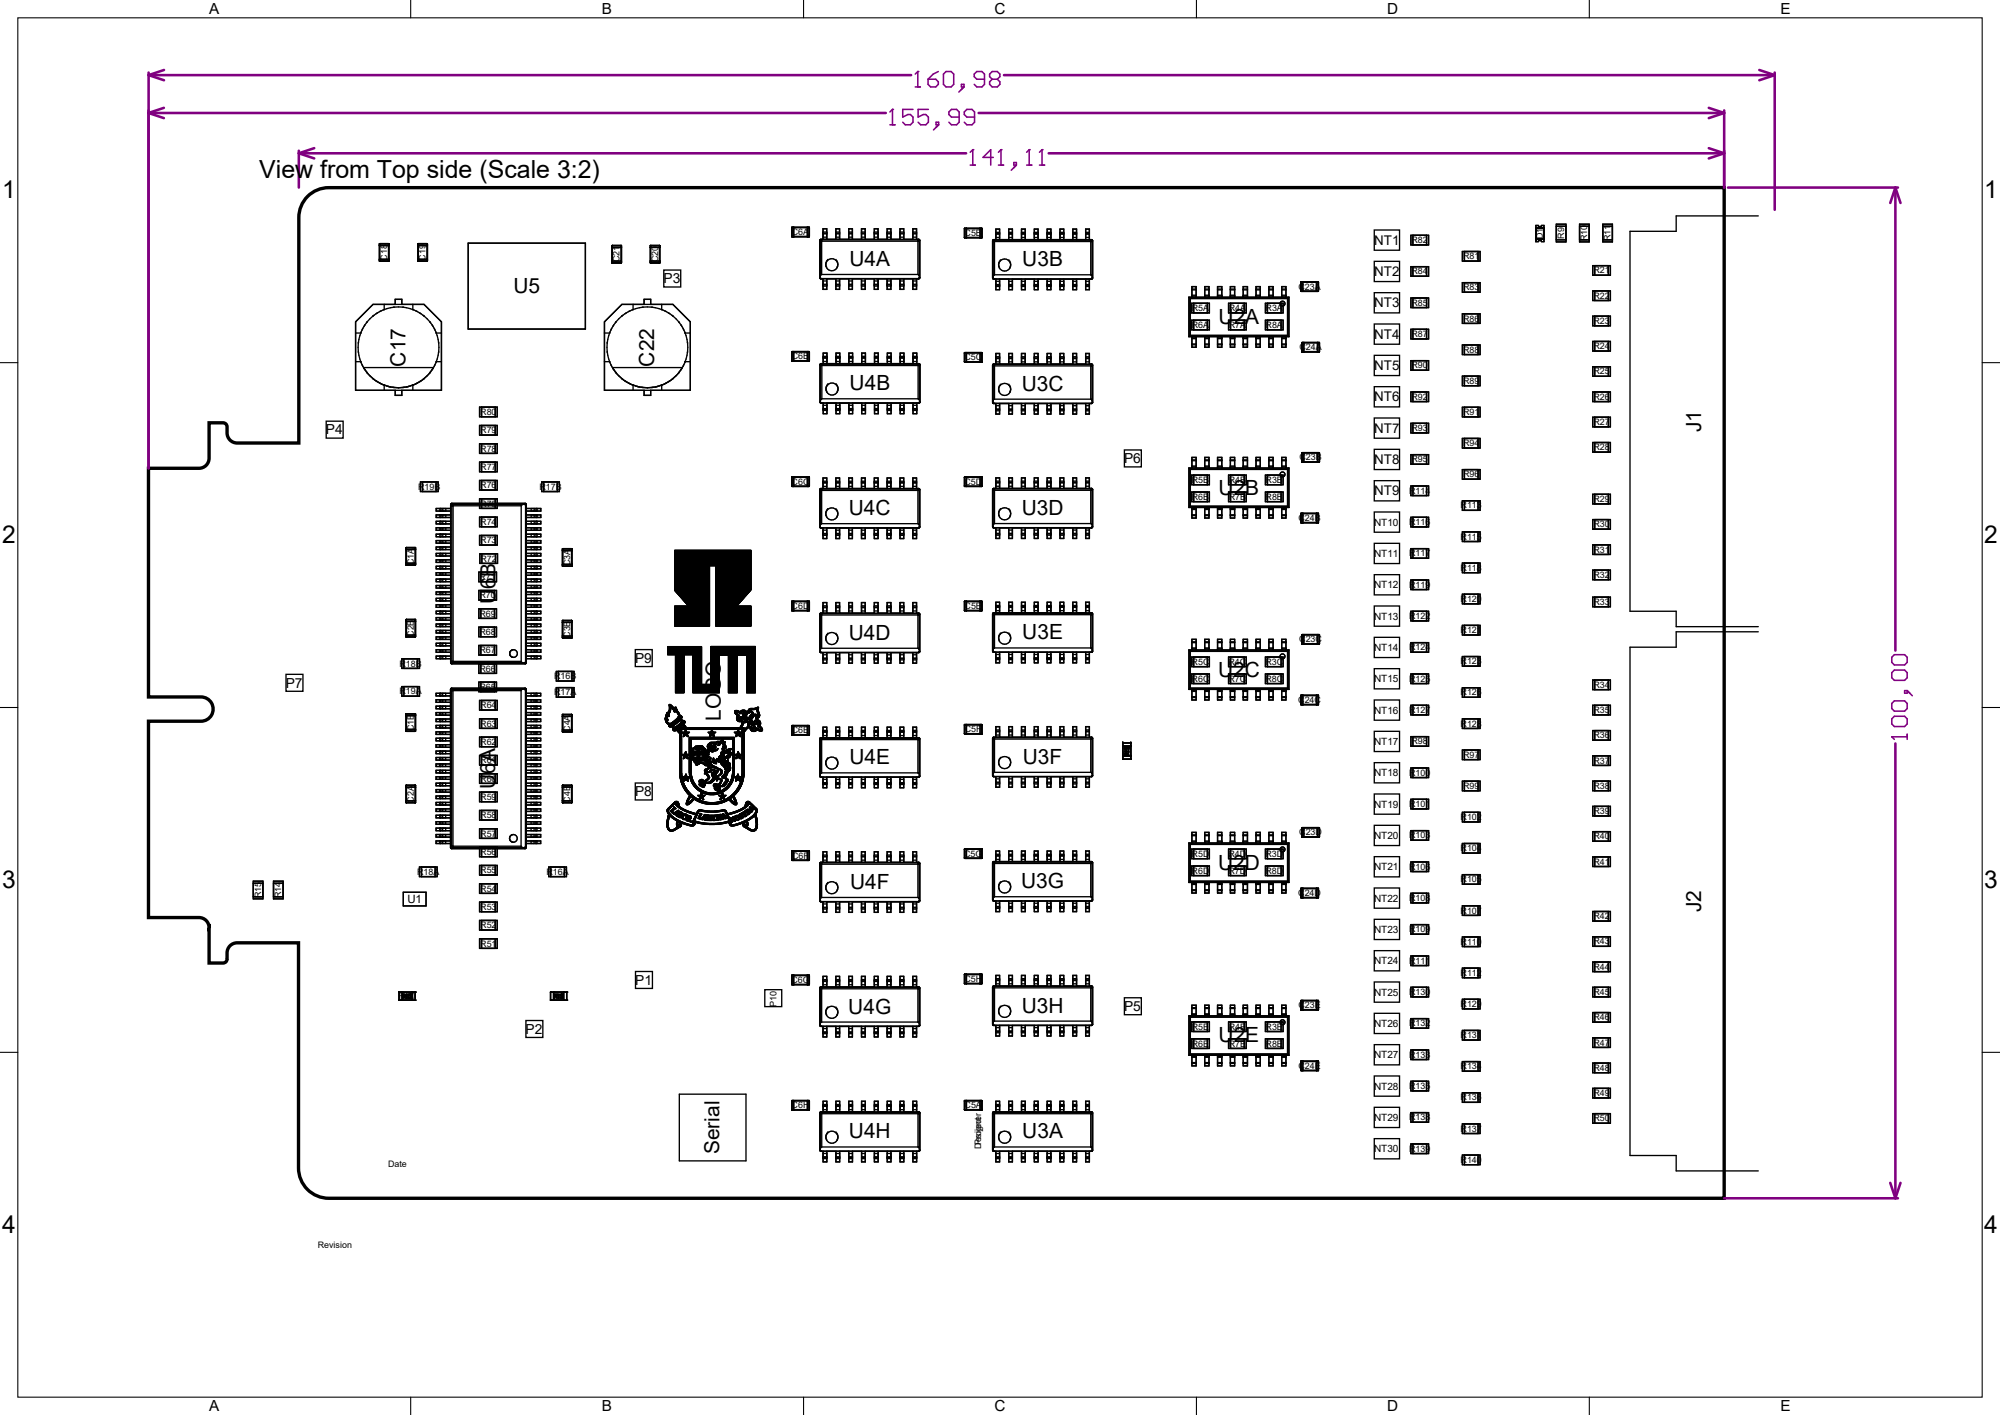
[picture p10: page 2]

View from Top side (Scale 3:2)

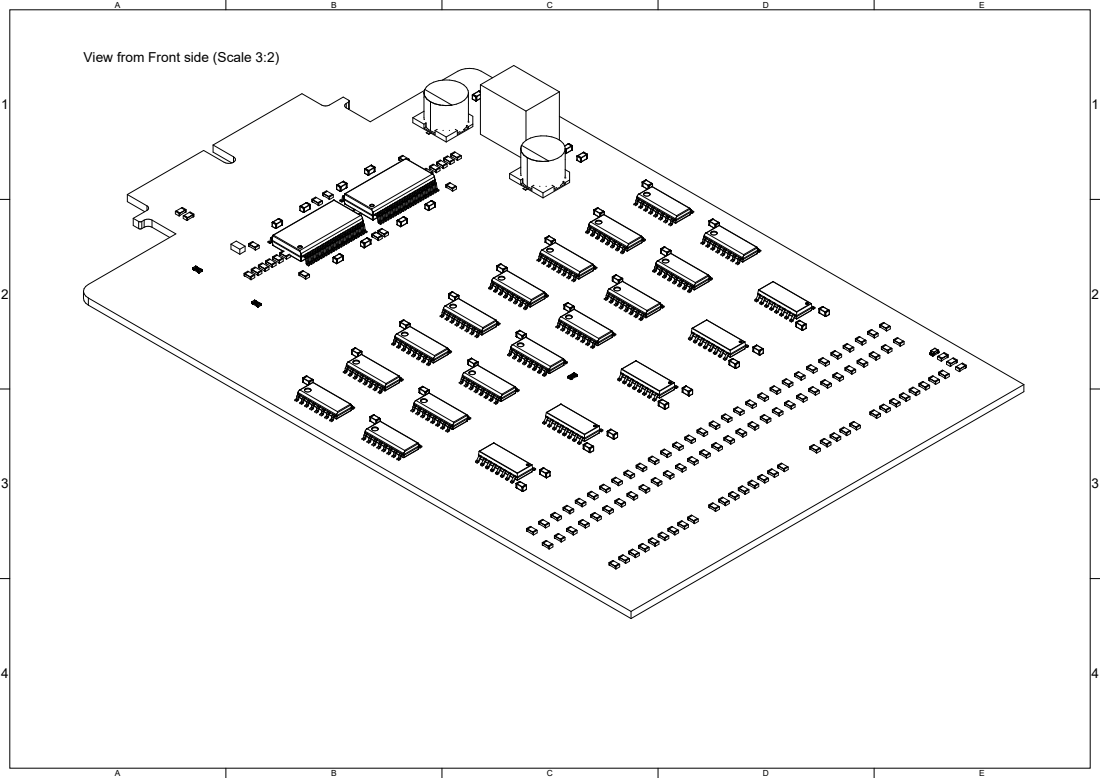
[picture p11: page 3]

View from Front side (Scale 3:2)

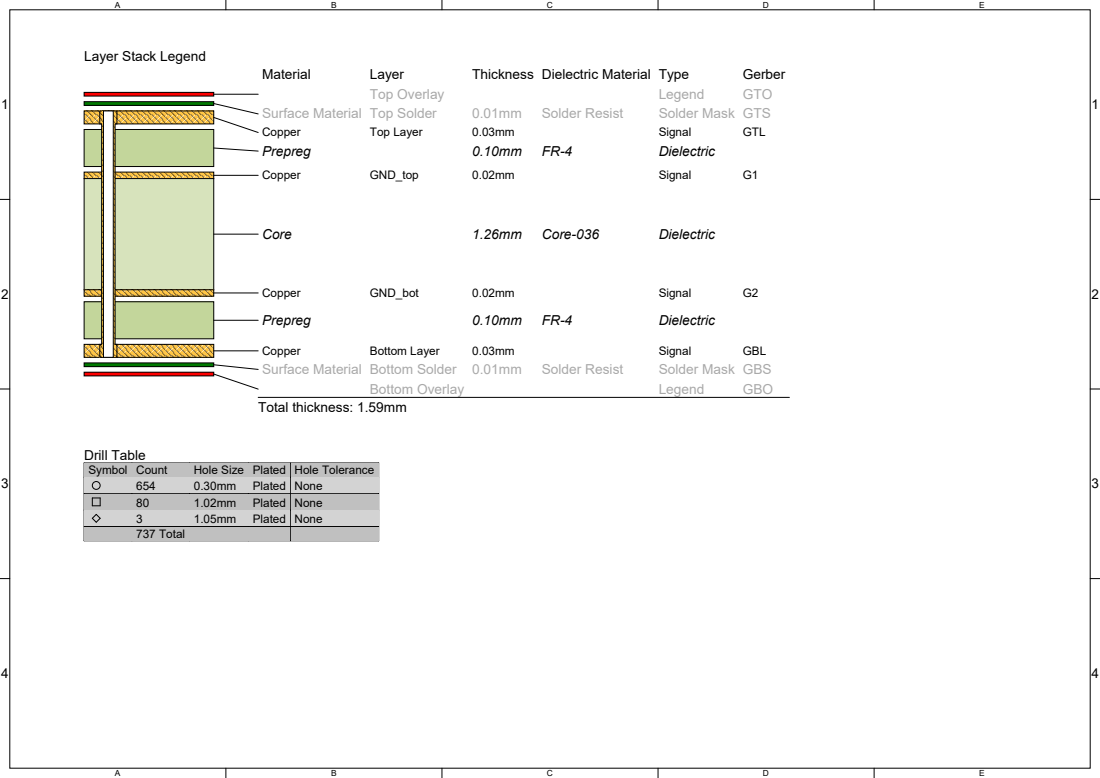
[picture p12: page 4]

Symbol | Count | Hole Size | Plated | Hole Tolerance

654 | 0.30mm | Plated | None
80 | 1.02mm | Plated | None
3 | 1.05mm | Plated | None
737 Total
