ultrazohm/uz_d_voltage/Project Outputs for ultrazohm_digital_voltage_3U_1vxx/2v01/DOC/SCH_UltraZohm_Digital_Voltage_complete.PDF

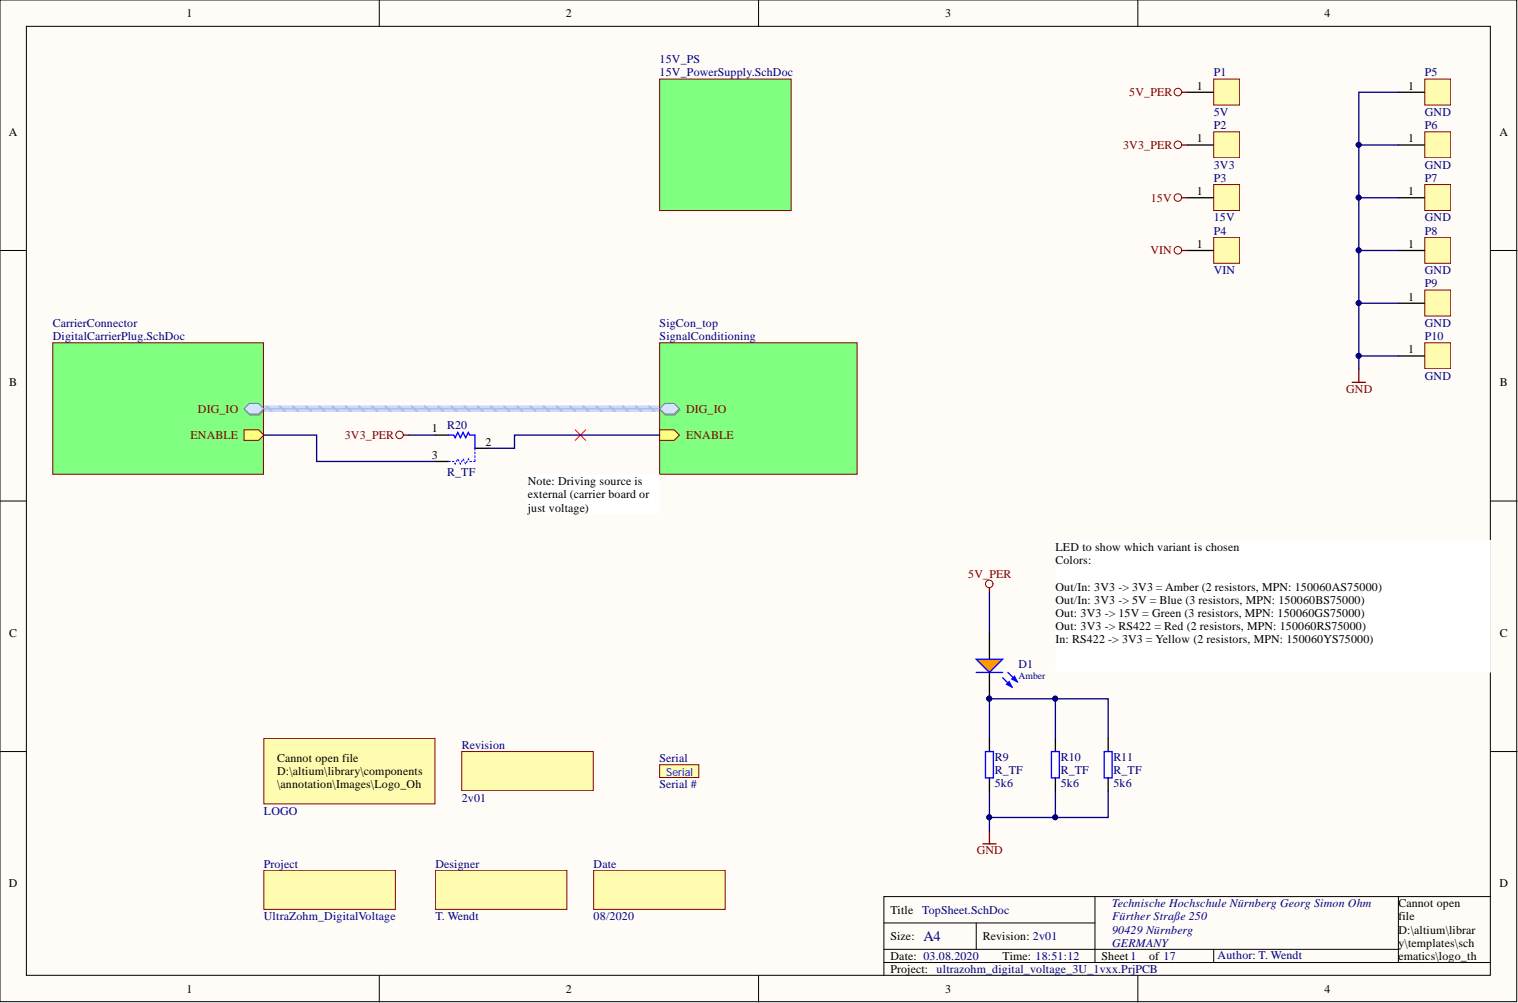
[picture p13: page 1]

Note: Driving source is
external (carrier board or
just voltage)

LED to show which variant is chosen
Colors:

Out/In: 3V3 -> 3V3 = Amber (2 resistors, MPN: 150060AS75000)
Out/In: 3V3 -> 5V = Blue (3 resistors, MPN: 150060BS75000)
Out: 3V3 -> 15V = Green (3 resistors, MPN: 150060GS75000)
Out: 3V3 -> RS422 = Red (2 resistors, MPN: 150060RS75000)
In: RS422 -> 3V3 = Yellow (2 resistors, MPN: 150060YS75000)

Title TopSheet.SchDoc | Technische Hochschule Nürnberg Georg Simon Ohm Fürther Straße 250 90429 Nürnberg GERMANY | Cannot open file D:\altium\librar y\templates\sch ematics\logo_th

Size: A4 | Revision: 2v01
Date: 03.08.2020 Time: 18:51:12 | Sheet of 17 | Author: T. Wendt

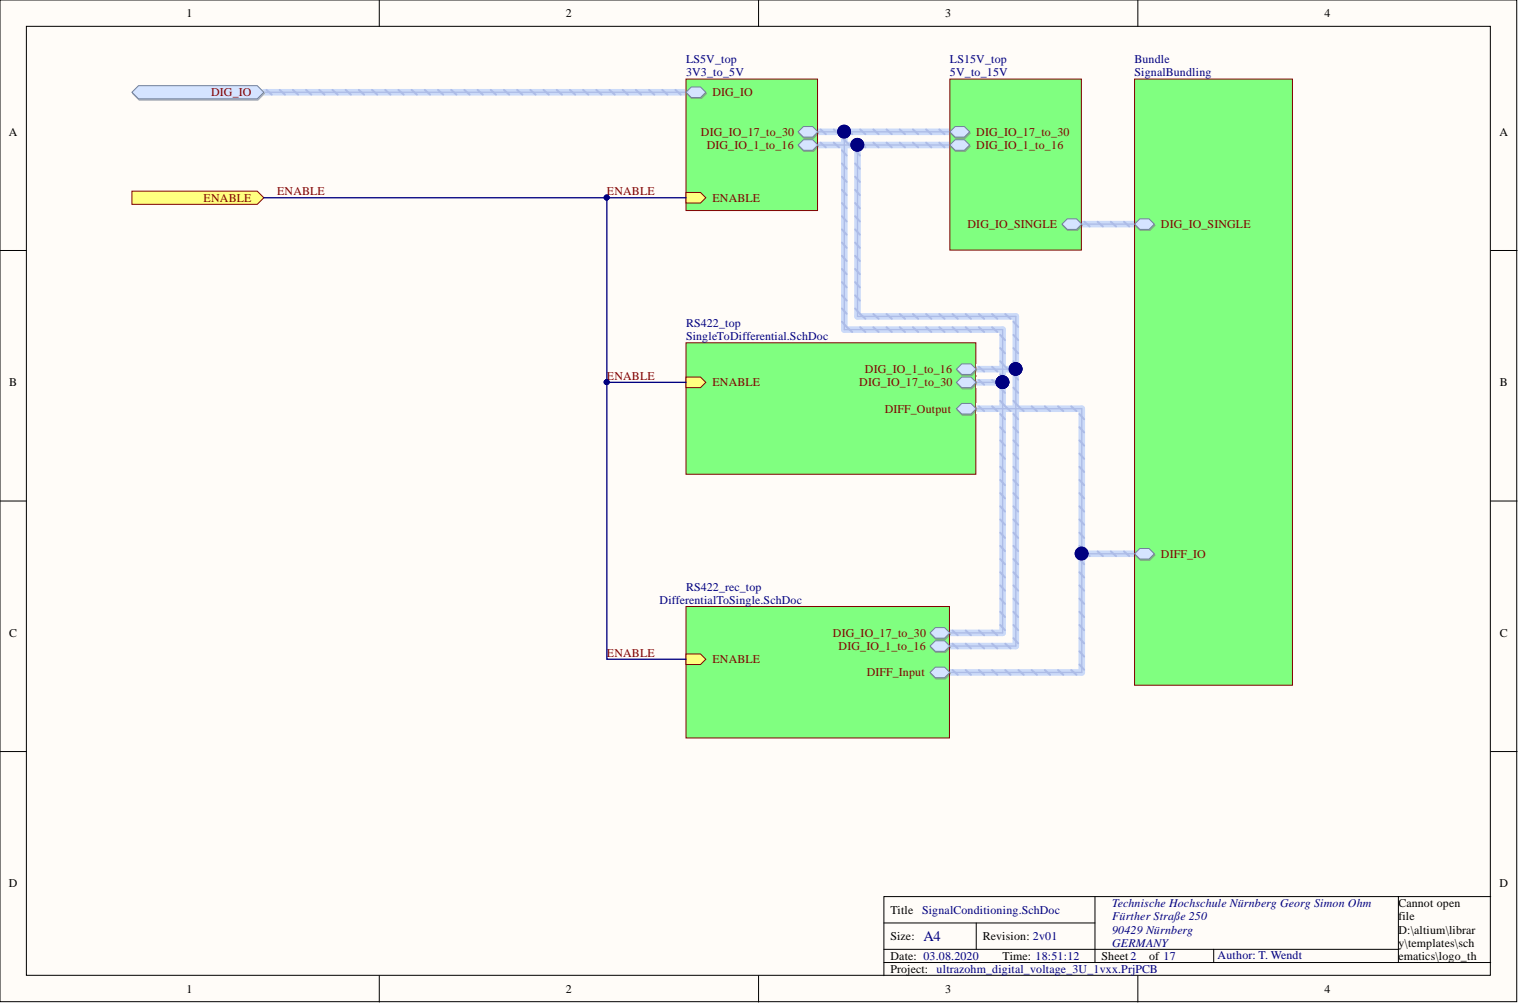
[picture p14: page 2]

Technische Hochschule Nürnberg Georg Simon Ohm
Fürther Straße 250

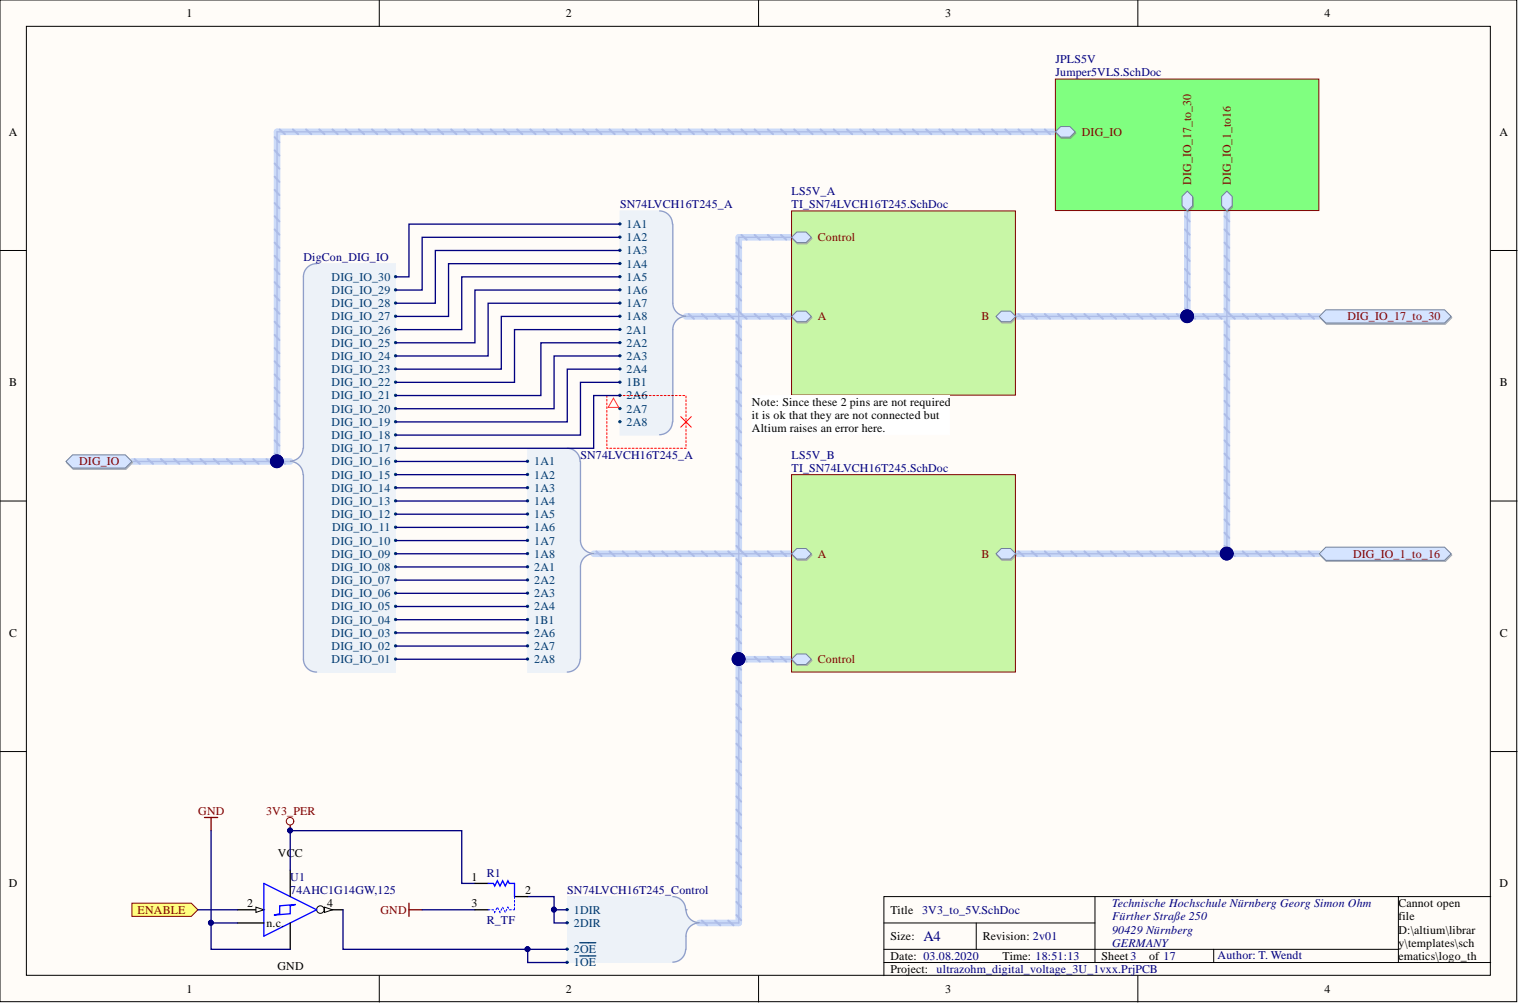
[picture p15: page 3]

Note: Since these 2 pins are not required
it is ok that they are not connected but
Altium raises an error here.

Technische Hochschule Nürnberg Georg Simon Ohm
Fürther Straße 250

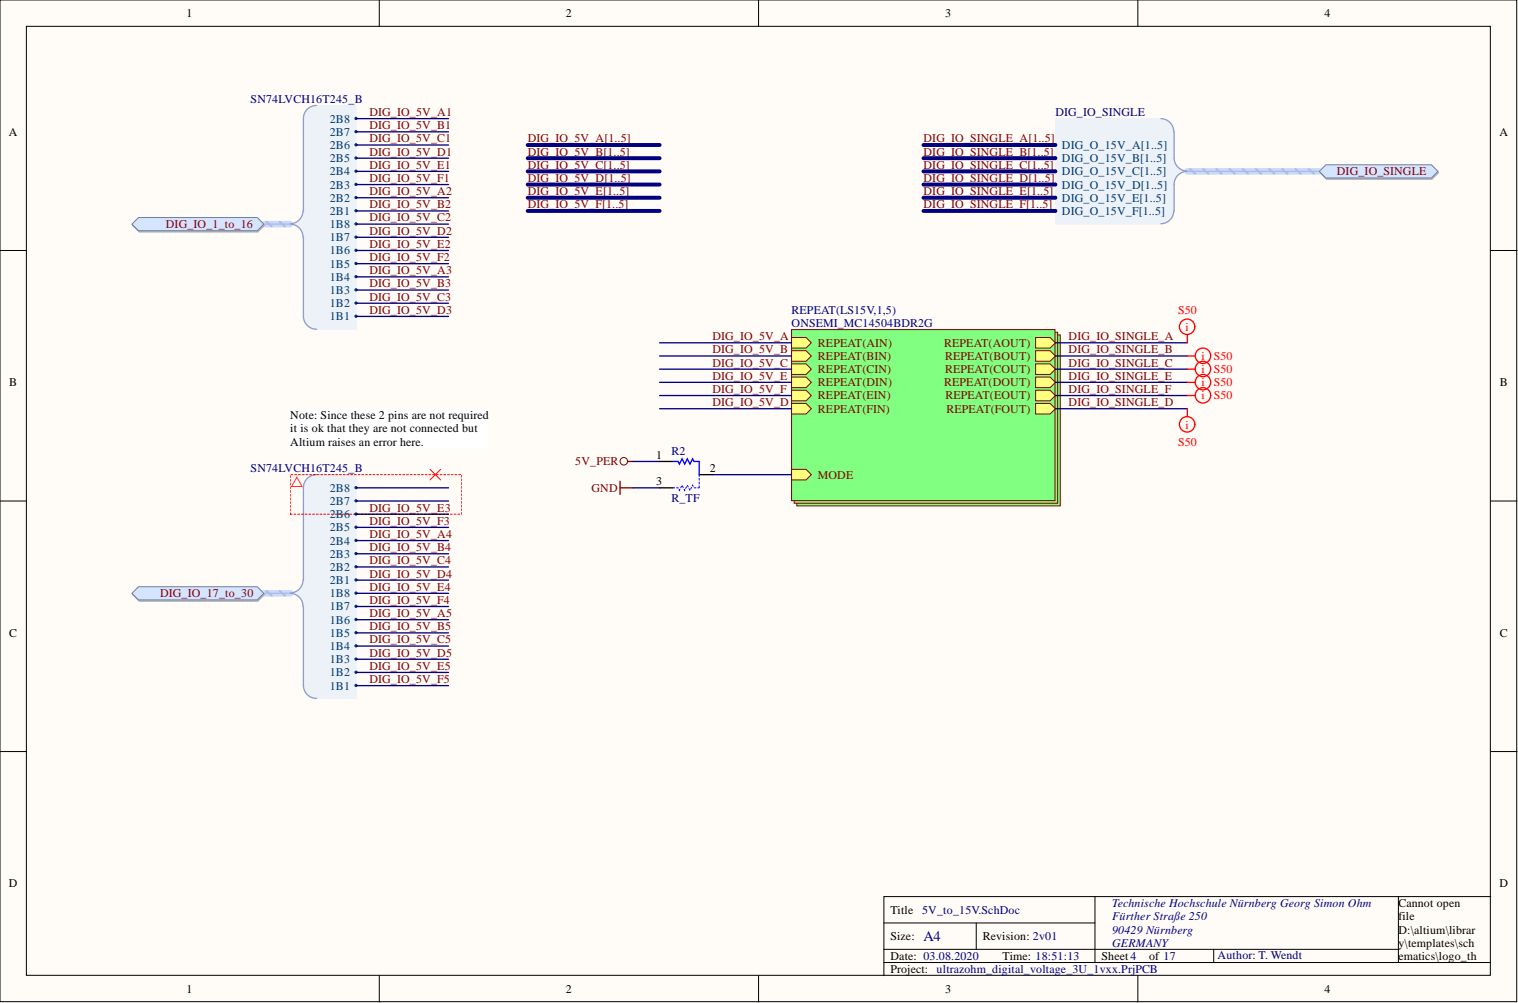
[picture p16: page 4]
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

Technische Hochschule Nürnberg Georg Simon Ohm
Fürther Straße 250

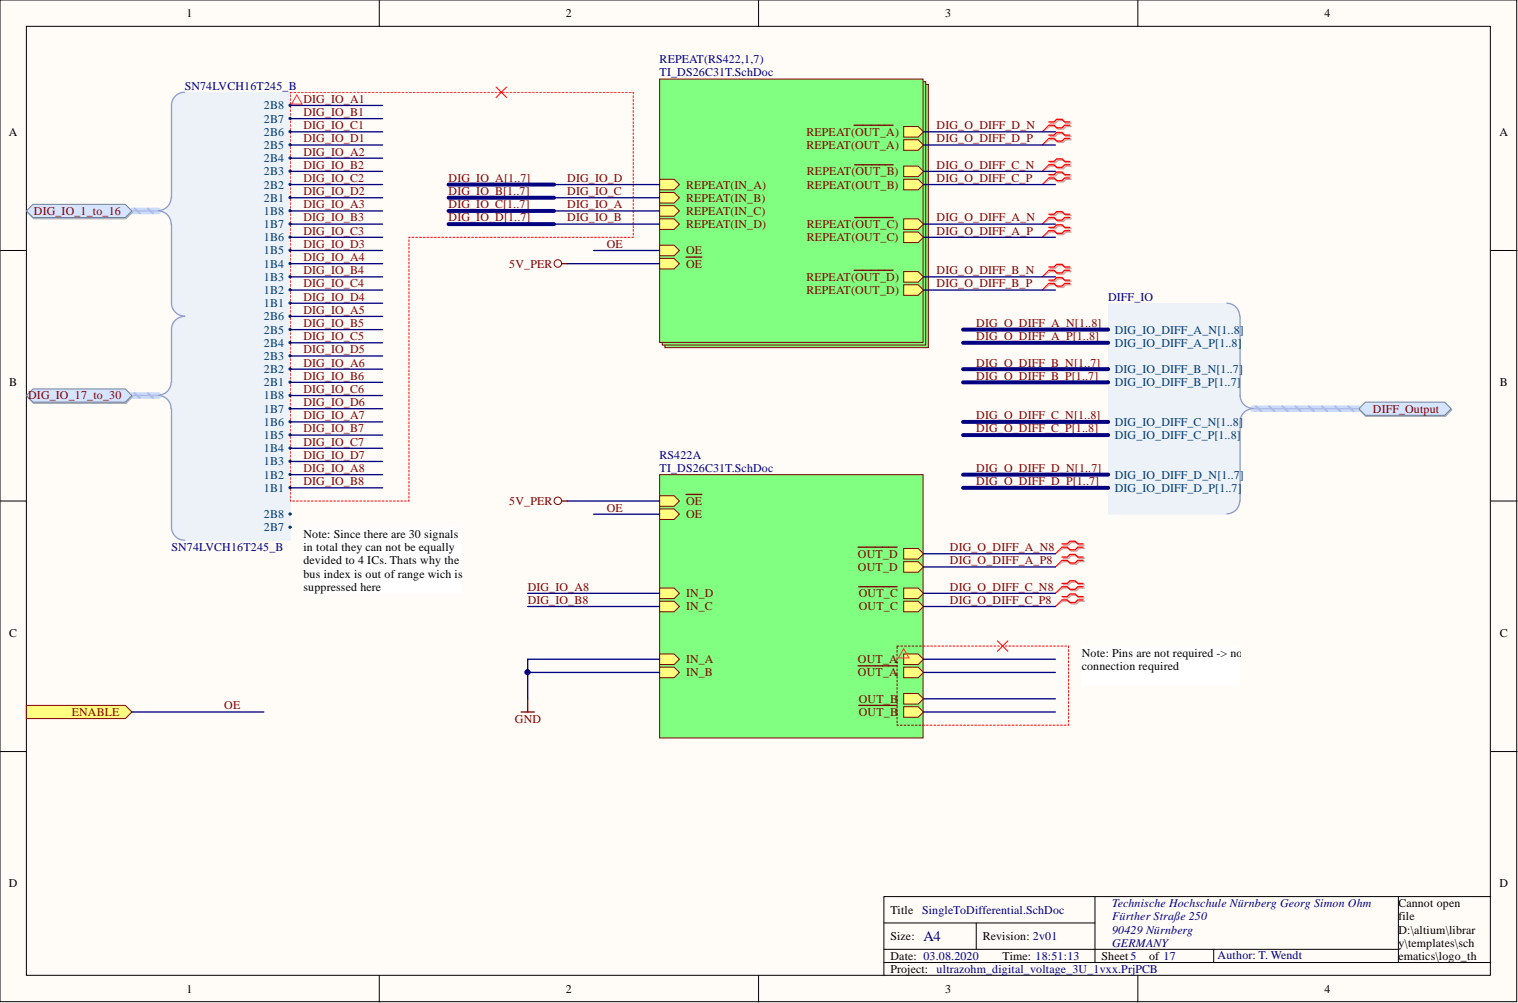
[picture p17: page 5]

T i t l e Si n g leT o D ifferen t ial.Sch D o c | Tech n i sche Hoch sch u le Nü r n berg Geo rg S i m o n O h m F ü r t her S t r aße 2 5 0 9 Nü r n berg G ER MANY | Can n o t o pen fi le D:\al t i um\ l i brar y \ temp lates \ sch emat ics \ l o g o _ t h

A | Rev i s i o n : v
3.0 8.2 T ime: : : | Sheet o f | A u t h or: T. Wen d t

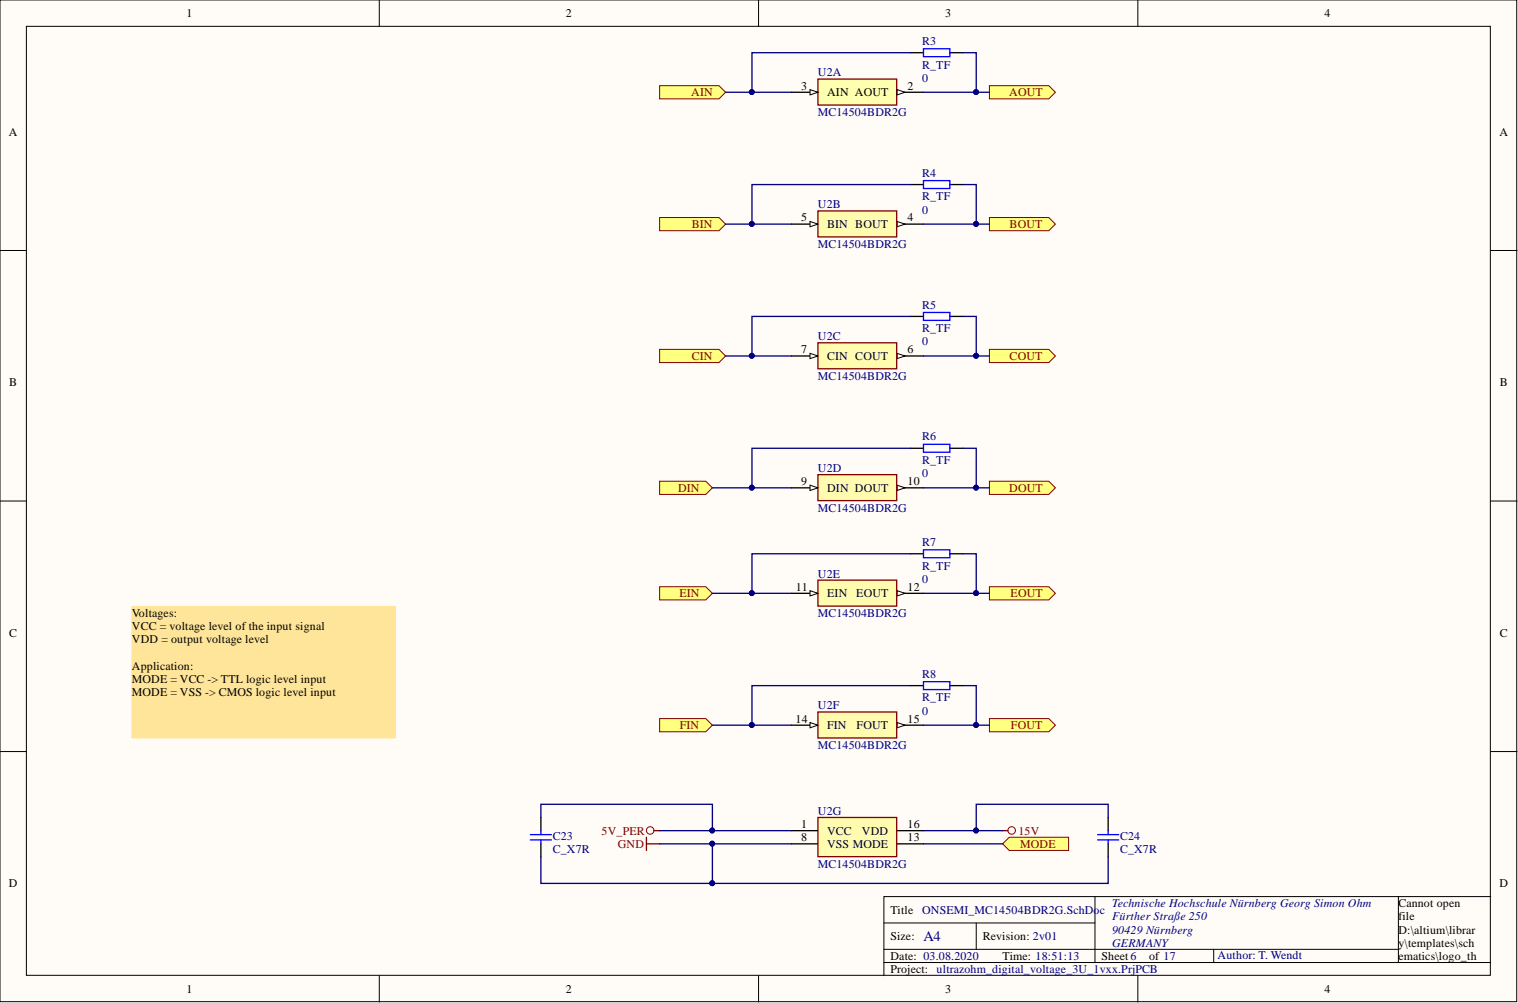
[picture p18: page 6]

Voltages:
VCC = voltage level of the input signal
VDD = output voltage level

Application:
MODE = VCC -> TTL logic level input
MODE = VSS -> CMOS logic level input

Technische Hochschule Nürnberg Georg Simon Ohm
Fürther Straße 250

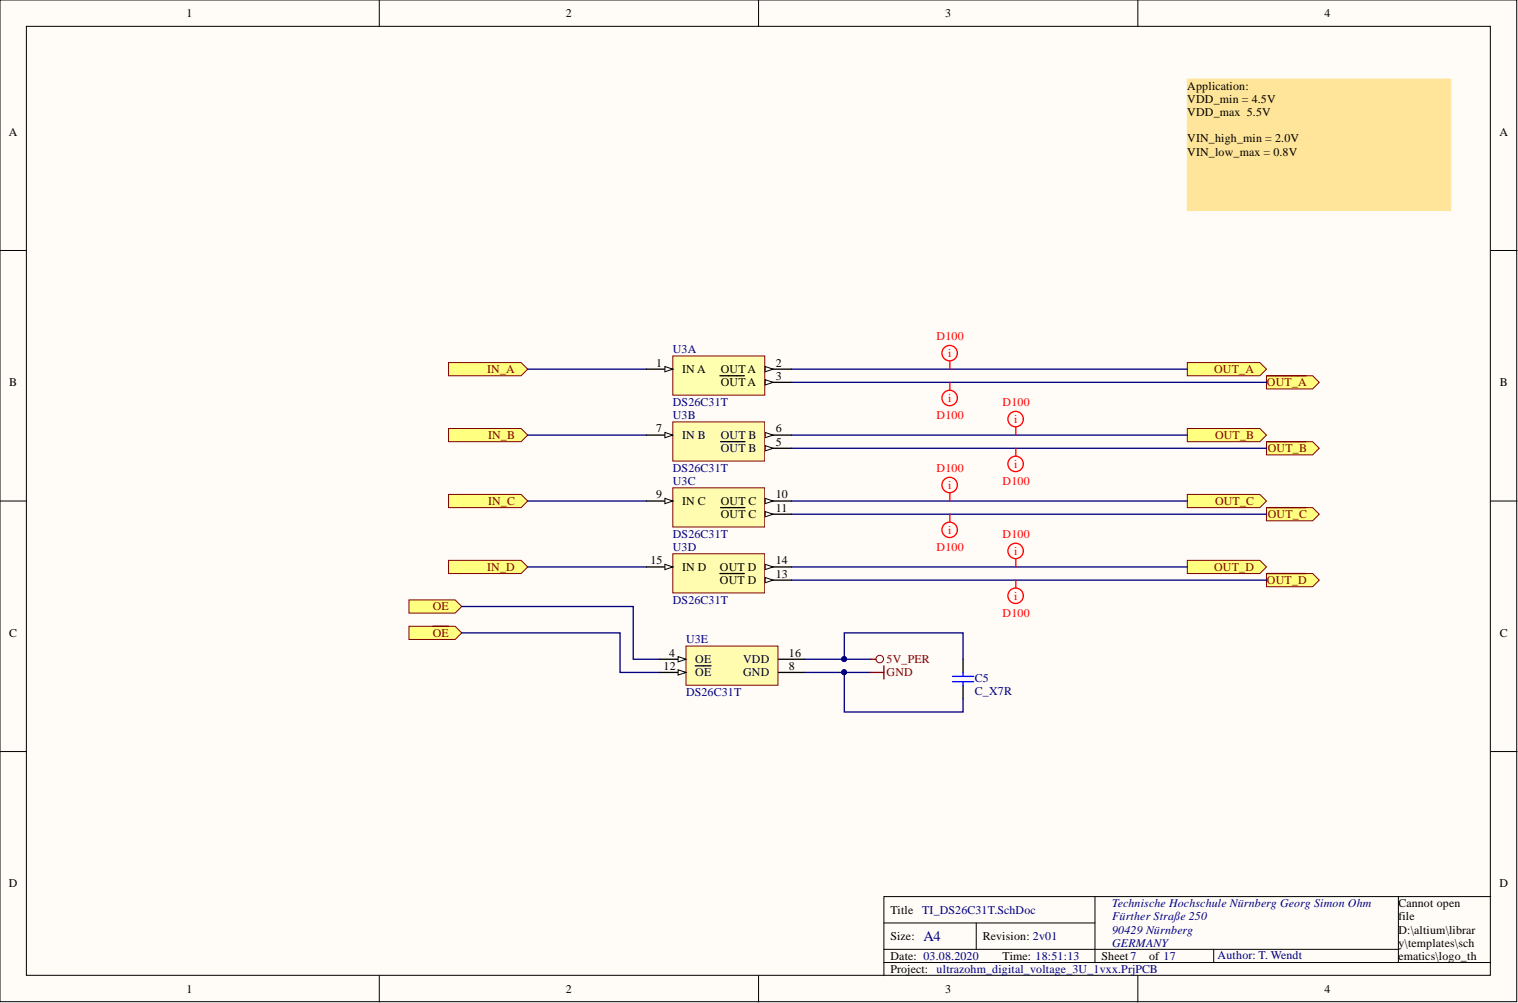
[picture p19: page 7]

Technische Hochschule Nürnberg Georg Simon Ohm
Fürther Straße 250

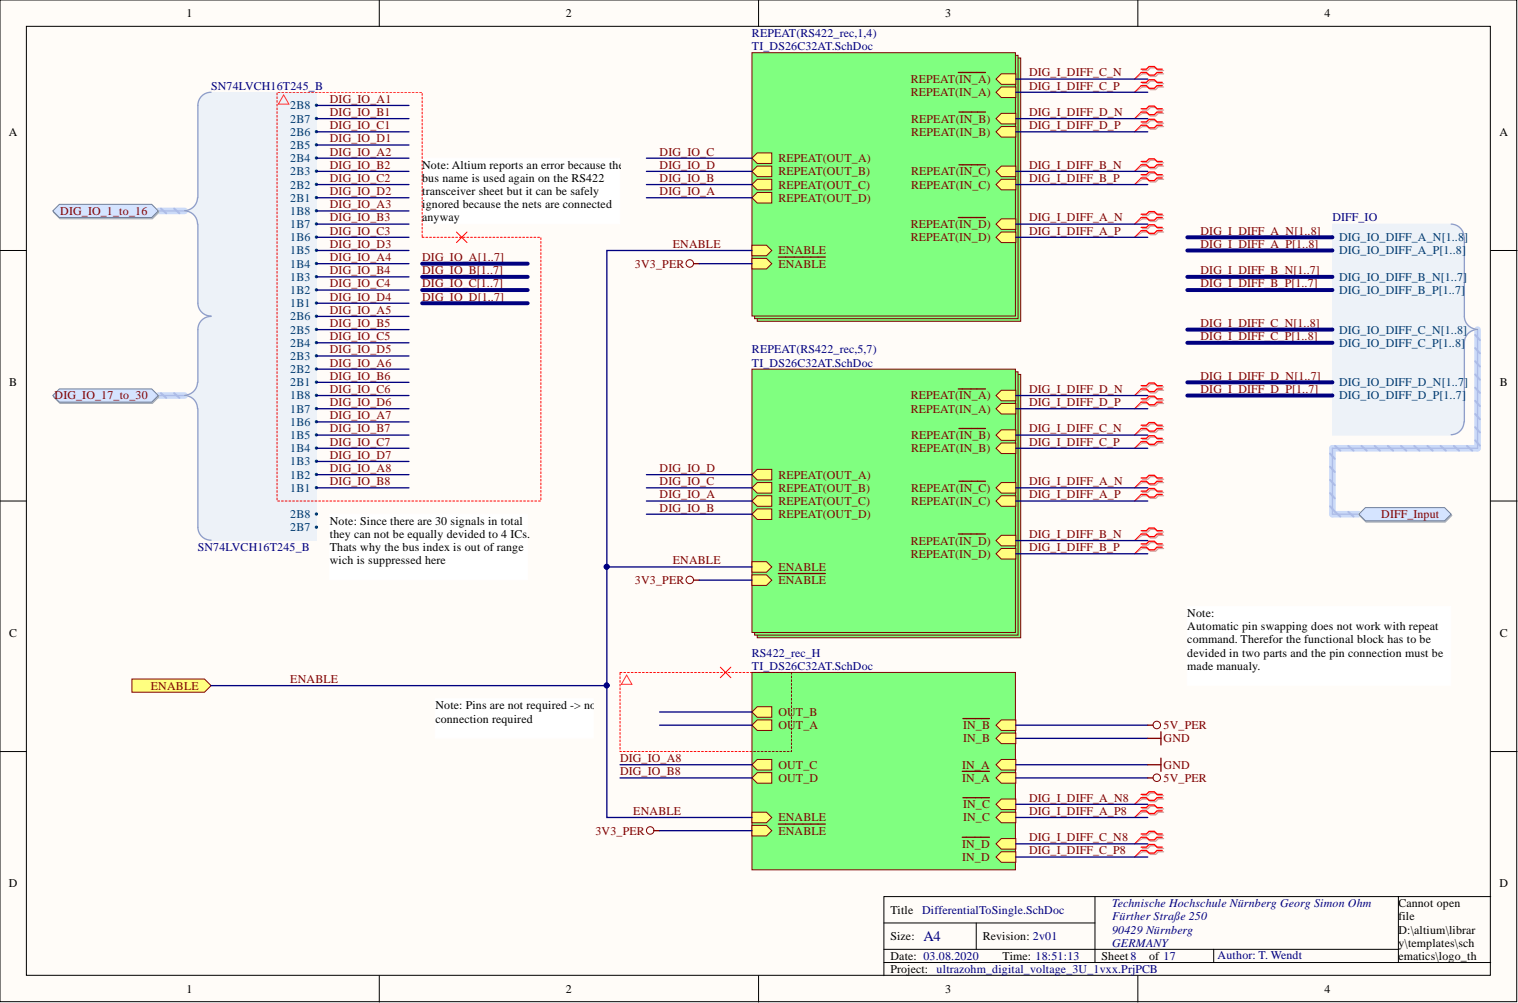
[picture p20: page 8]

Note: Altium reports an error because the
bus name is used again on the RS422
transceiver sheet but it can be safely
ignored because the nets are connected
anyway

Note: Since there are 30 signals in total
they can not be equally devided to 4 ICs.
Thats why the bus index is out of range
wich is suppressed here

Note:
Automatic pin swapping does not work with repeat
command. Therefor the functional block has to be
devided in two parts and the pin connection must be
made manualy.

Note: Pins are not required -> no
connection required

Technische Hochschule Nürnberg Georg Simon Ohm
Fürther Straße 250

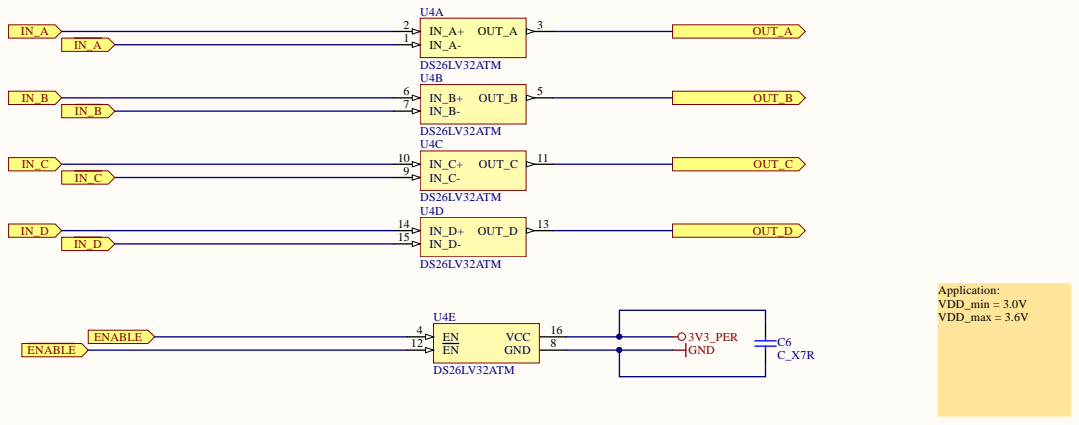
[picture p21: page 9]

Technische Hochschule Nürnberg Georg Simon Ohm
Fürther Straße 250

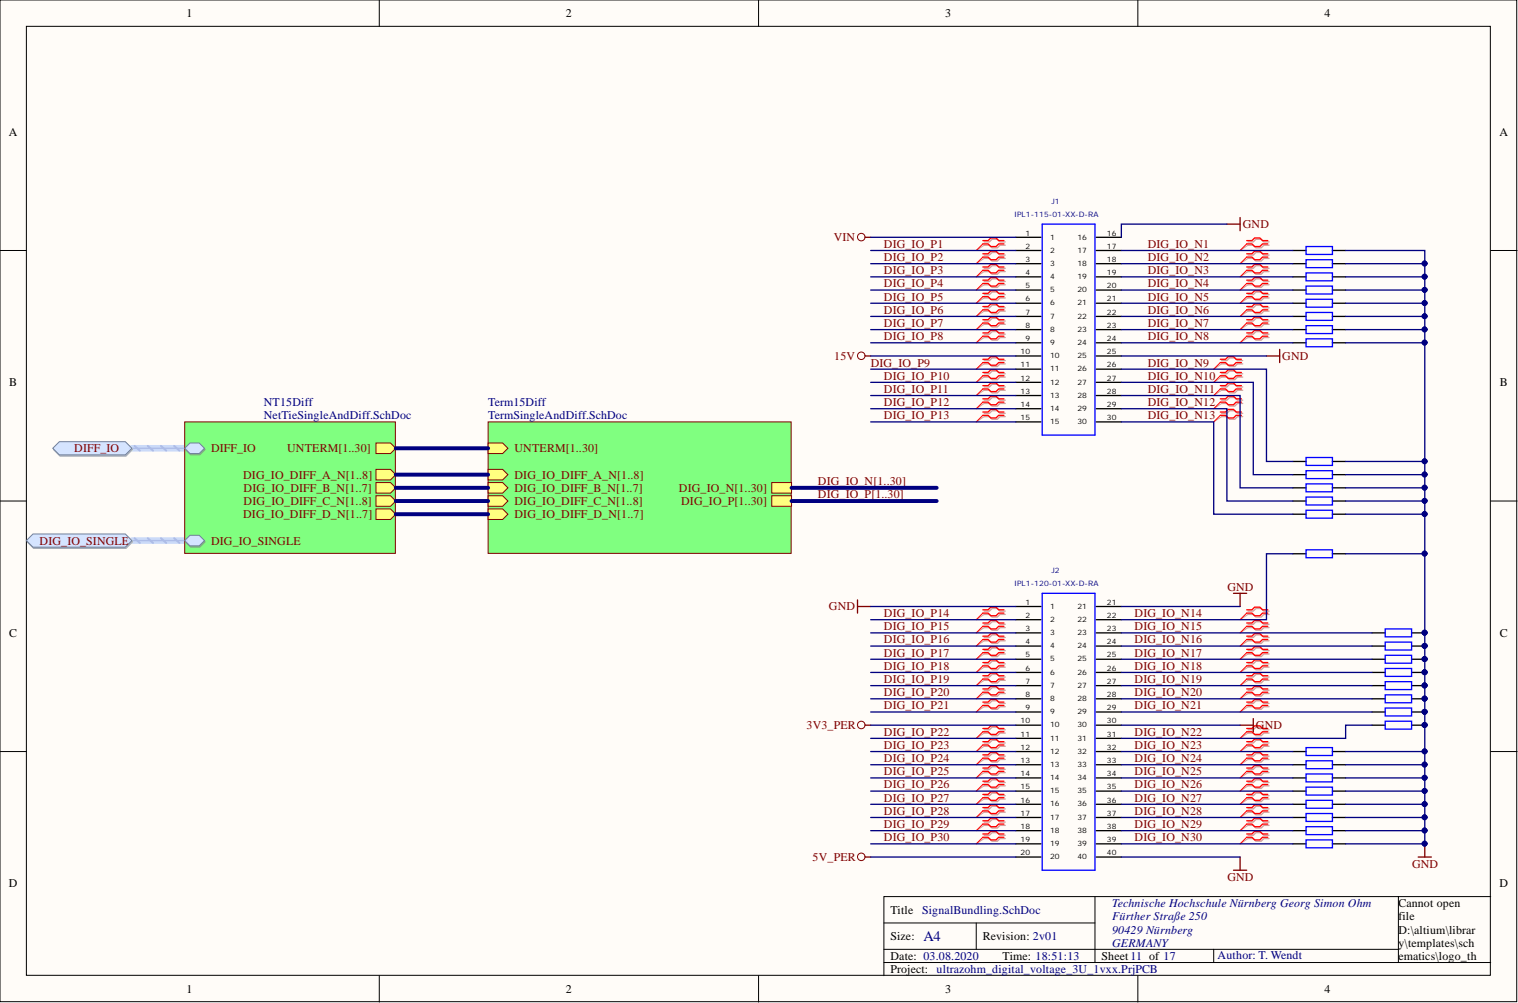
[picture p22: page 10]

2 7 | DIG _IO _ N 1 0
2 8 | DIG _IO _ N 1 1
2 9 | DIG _IO _ N 1 2

3 0 | DIG _IO _ N 1 3

T i t l e Si g nalBu n d l i n g.Sch D o c | Tech n i sche Hoch sch u le Nü r n berg Geo rg S i m o n O h m F ü r t her S t r aße 2 5 0 9 Nü r n berg G ER MANY | Can n o t o pen fi le D:\al t i um\ l i brar y \ temp lates \ sch emat ics \ l o g o _ t h

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

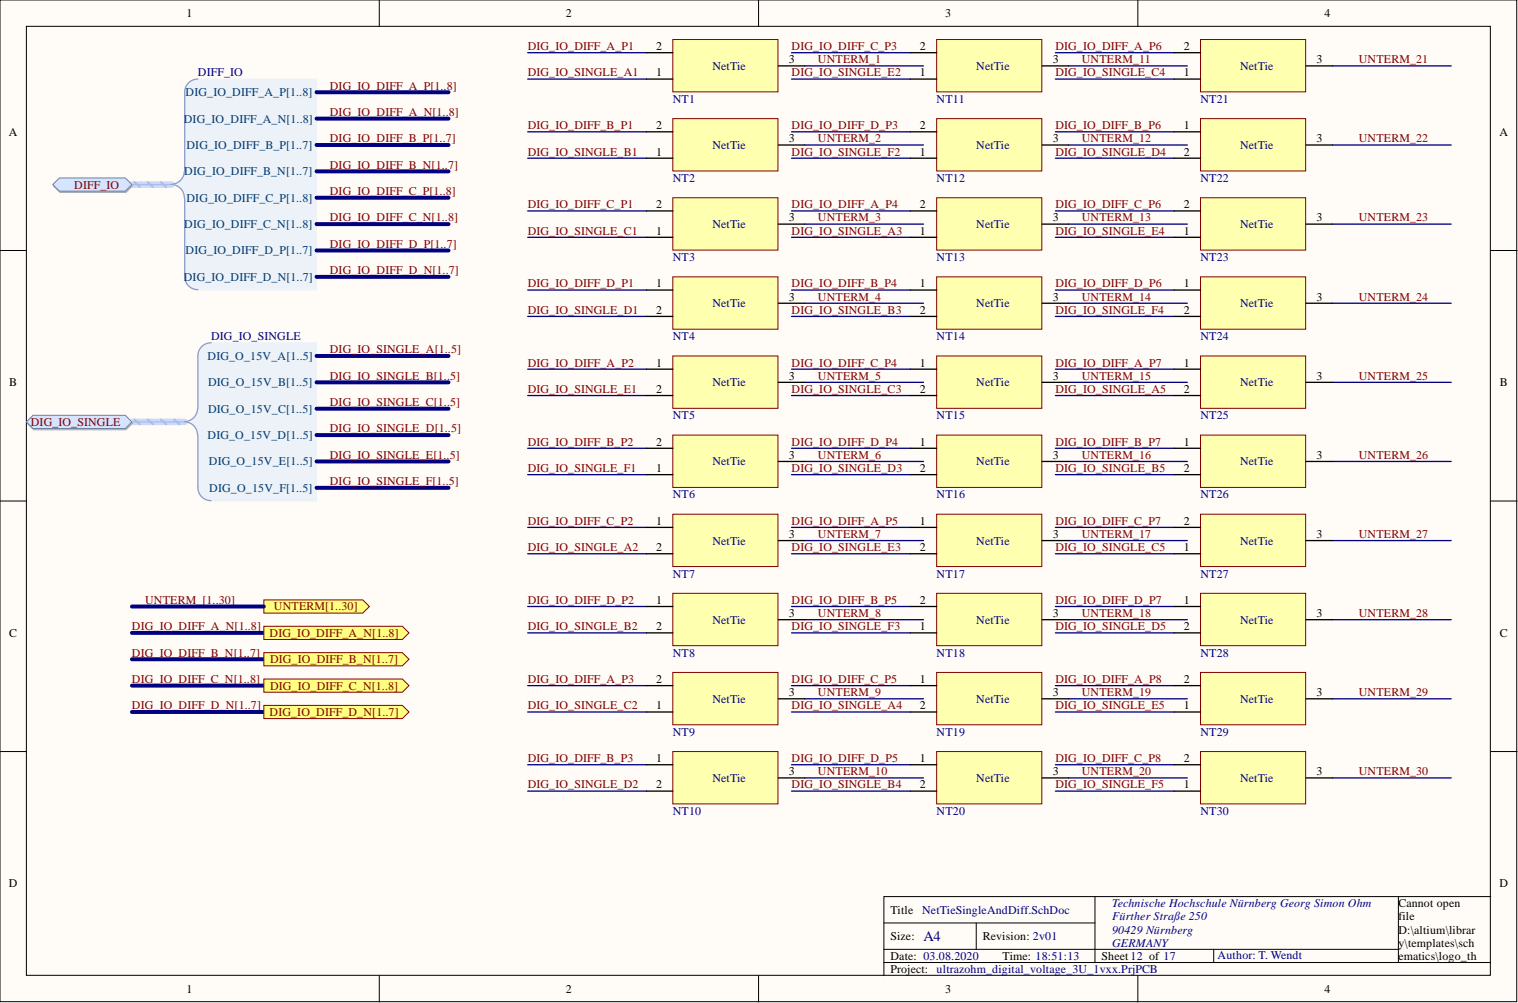
[picture p23: page 11]

Technische Hochschule Nürnberg Georg Simon Ohm
Fürther Straße 250

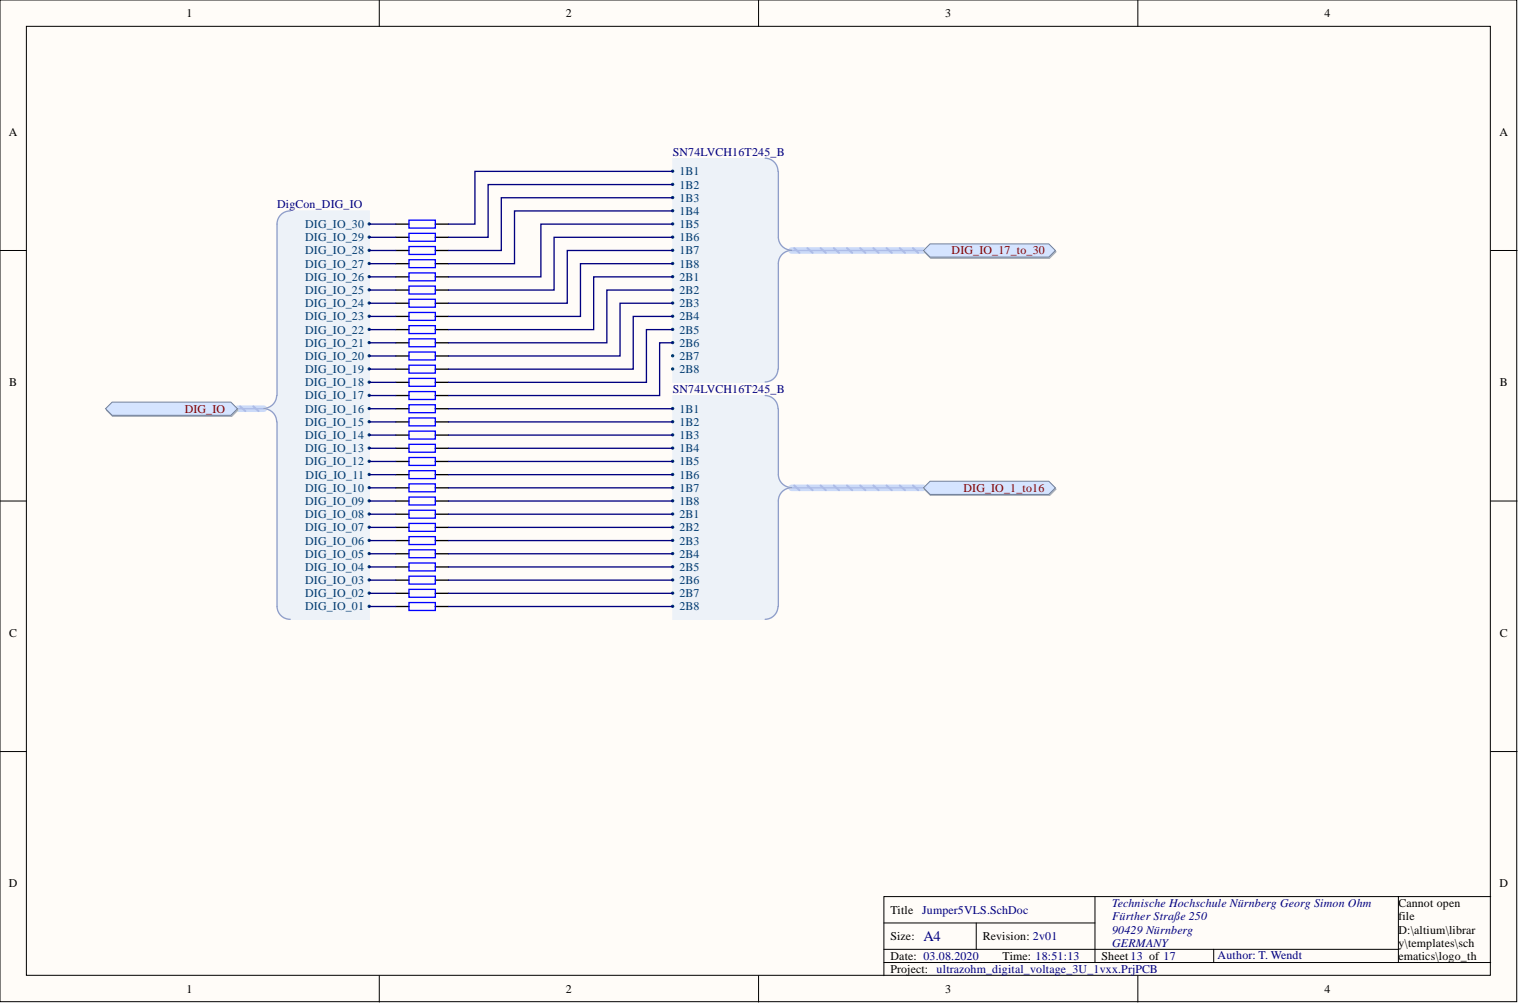
[picture p24: page 12]

T i t l e J umper5 V LS.Sch D o c | Tech n i sche Hoch sch u le Nü r n berg Geo rg S i m o n O h m F ü r t her S t r aße 2 5 0 9 Nü r n berg G ER MANY | Can n o t o pen fi le D:\al t i um\ l i brar y \ temp lates \ sch emat ics \ l o g o _ t h

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

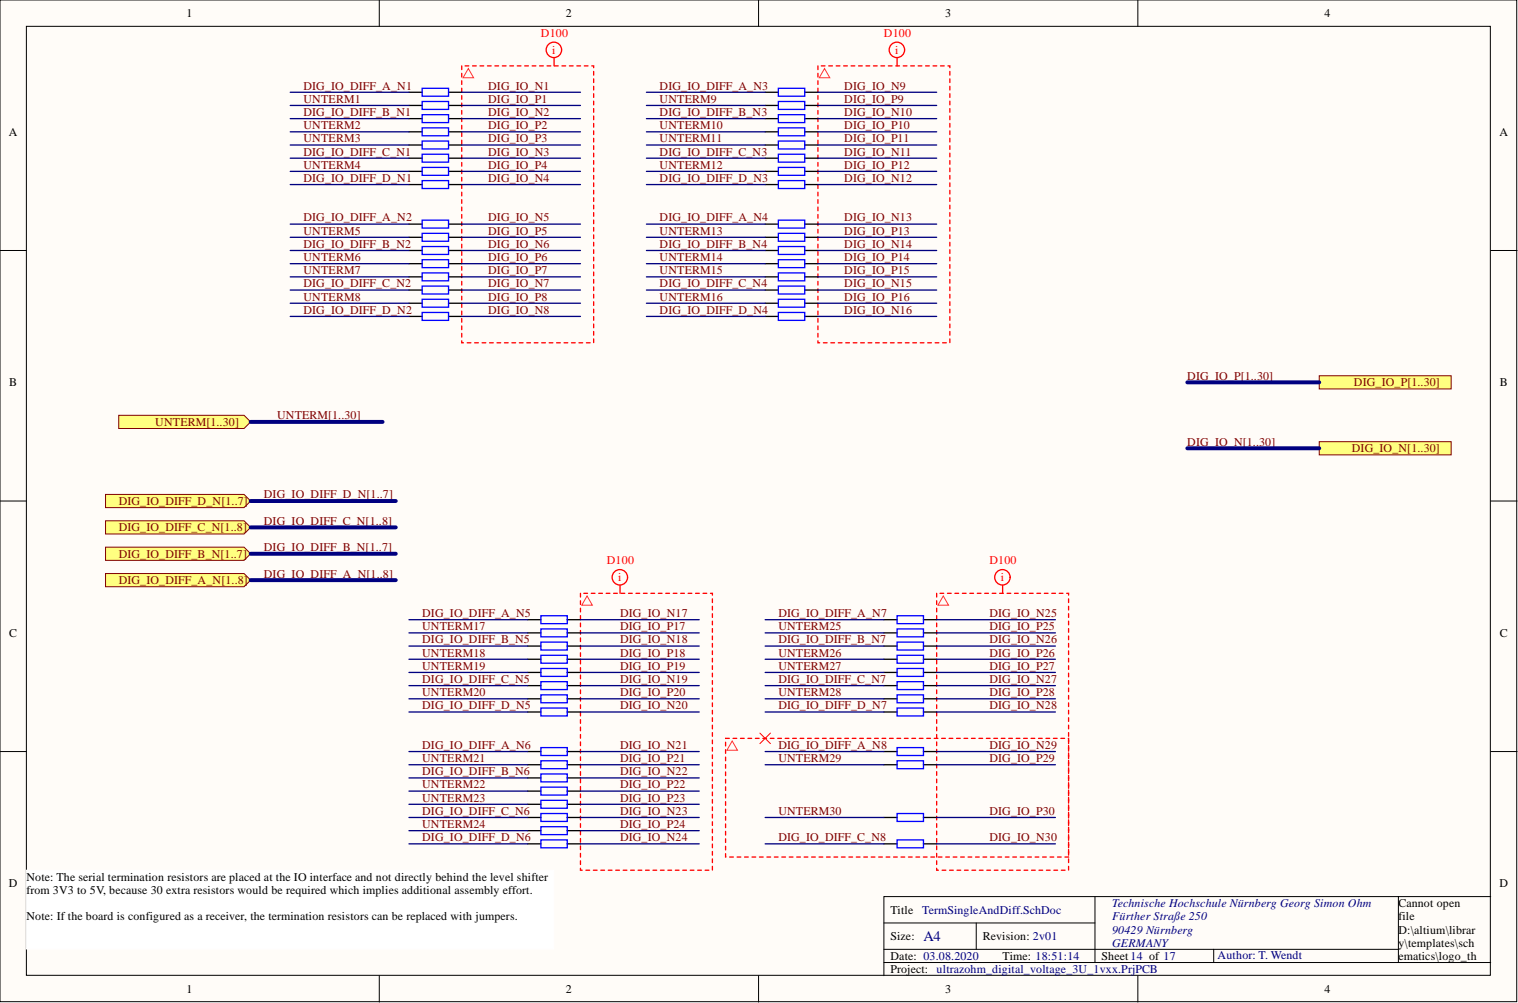
[picture p25: page 13]

Note: The serial termination resistors are placed at the IO interface and not directly behind the level shifter
from 3V3 to 5V, because 30 extra resistors would be required which implies additional assembly effort.

Technische Hochschule Nürnberg Georg Simon Ohm
Fürther Straße 250

Note: If the board is configured as a receiver, the termination resistors can be replaced with jumpers.

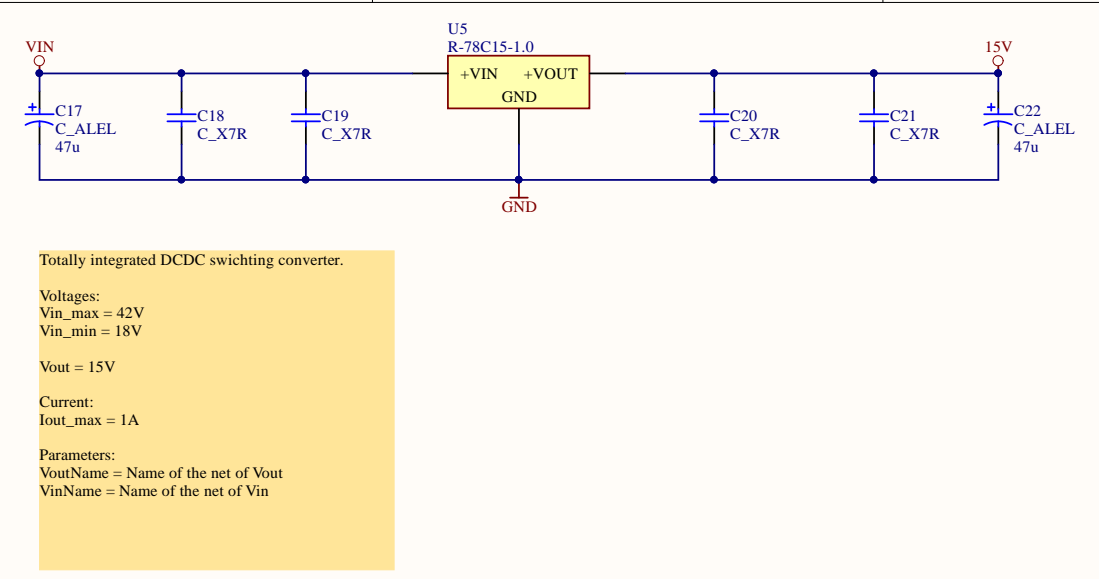
[picture p26: page 14]

T i t l e 1 5 V _Po werSu p p l y.Sch D o c | Tech n i sche Hoch sch u le Nü r n berg Geo rg S i m o n O h m F ü r t her S t r aße 2 5 0 9 Nü r n berg G ER MANY | Can n o t o pen fi le D:\al t i um\ l i brar y \ temp lates \ sch emat ics \ l o g o _ t h

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

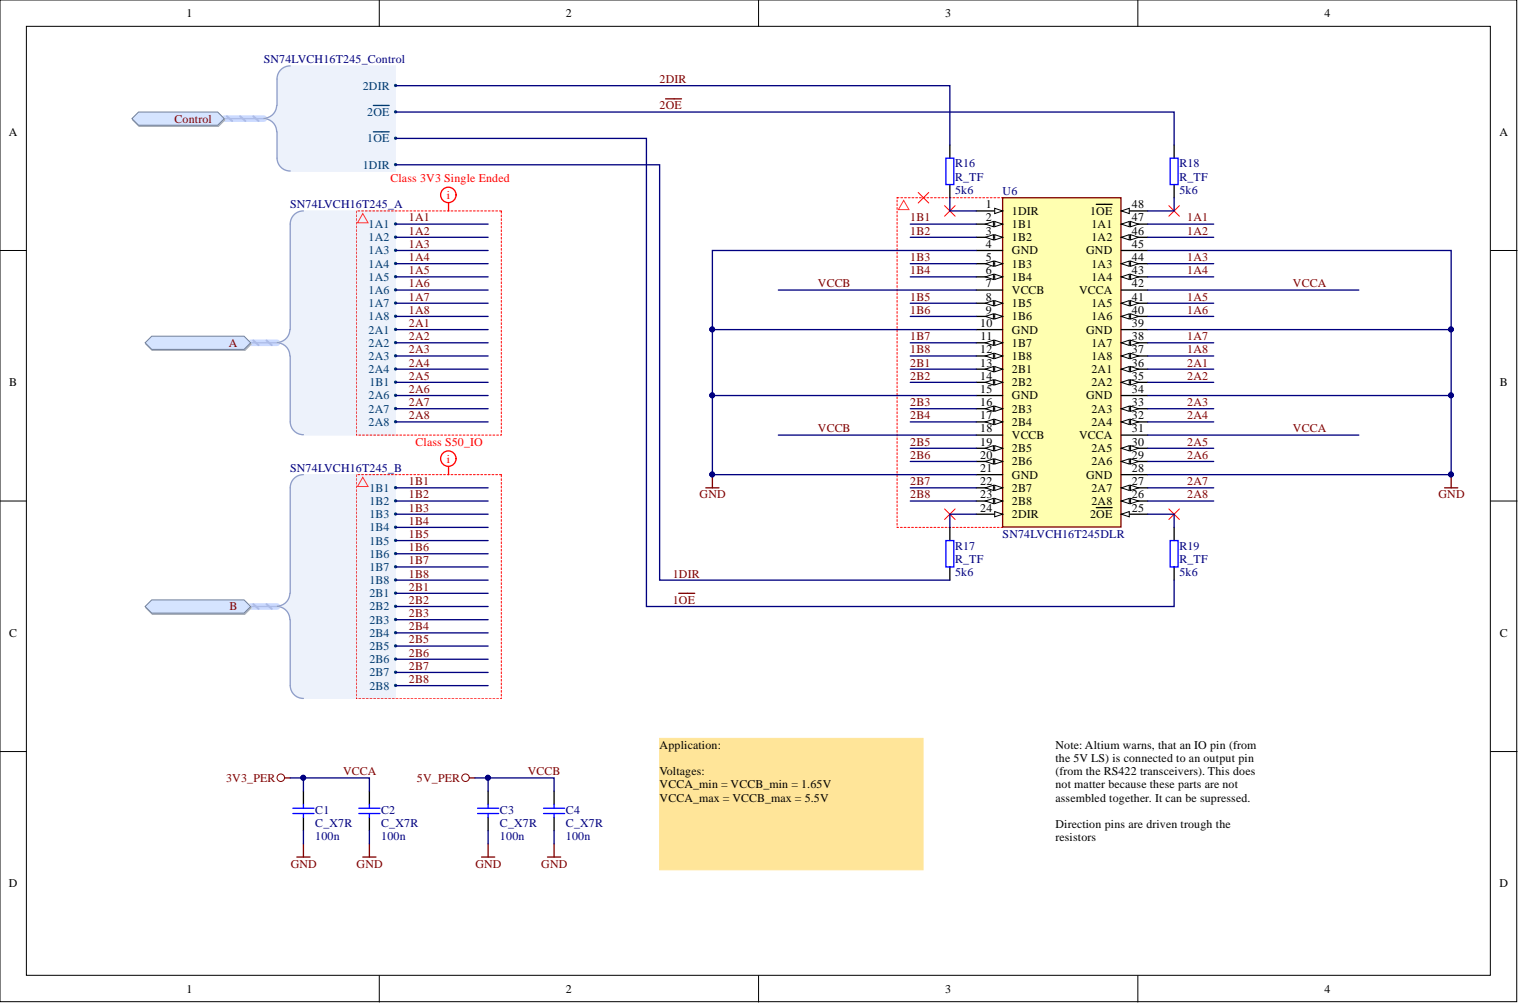
[picture p27: page 15]

hese part
her. It can be s

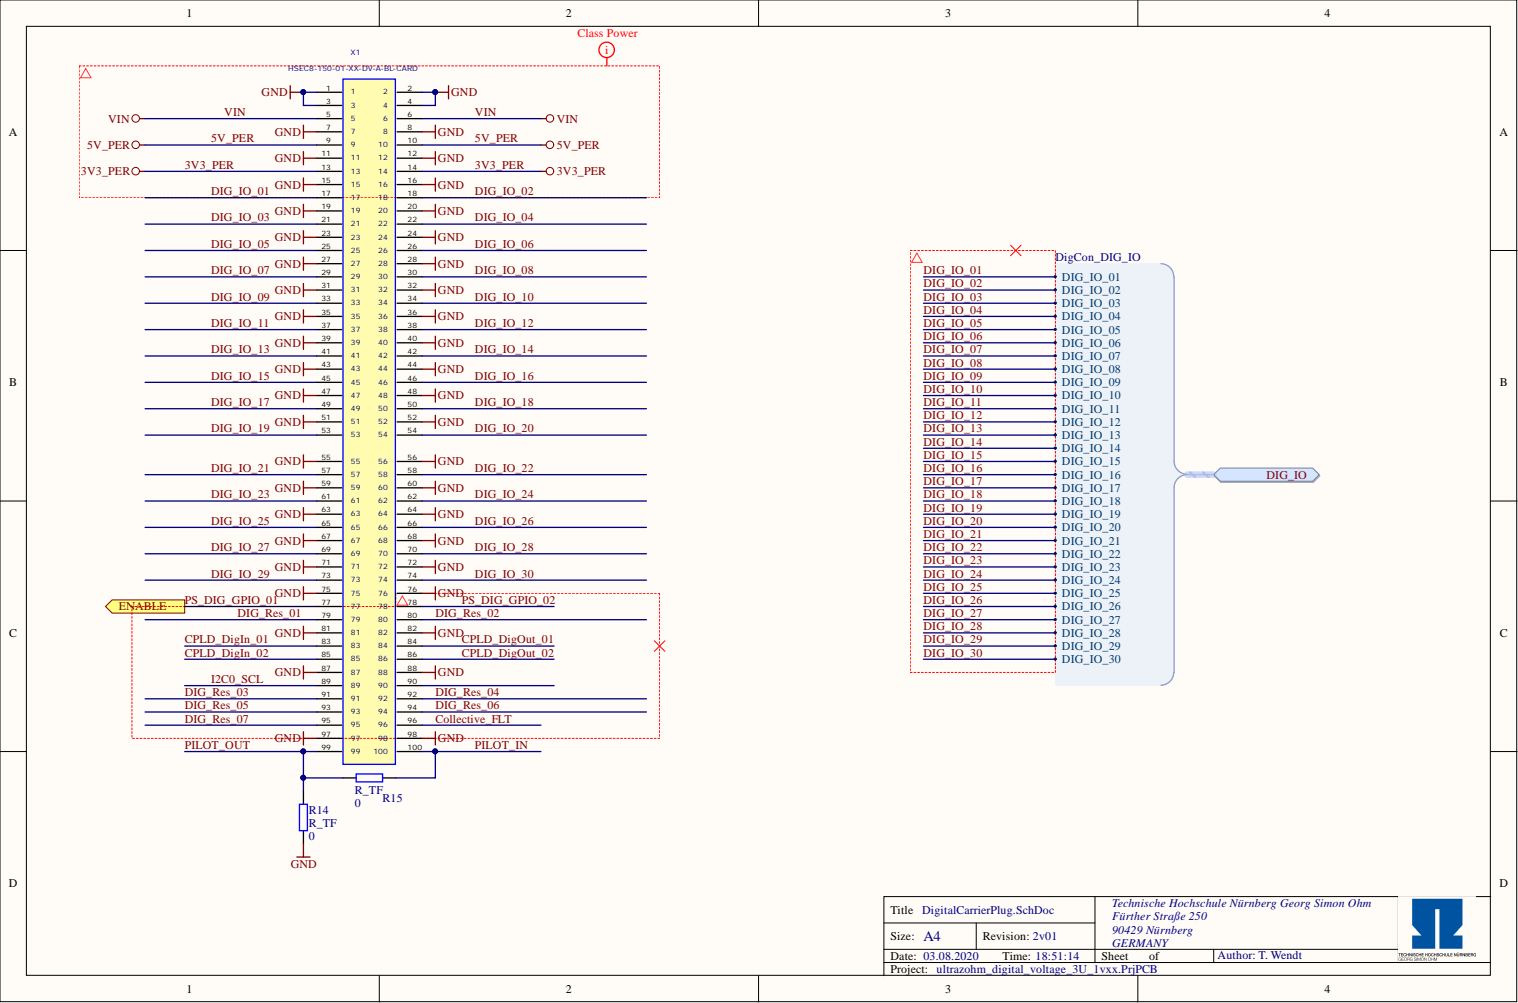
[picture p28: page 16]

T i t l e D i g i talCarrierPl u g.Sch D o c | Tech n i sche Hoch sch u le Nü r n berg Geo rg S i m o n O h m F ü r t her S t r aße 2 5 0 9 Nü r n berg G ER MANY

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
