ultrazohm/uz_d_voltage/Project Outputs for UZ_D_Voltage/Rev04/ASM/ASM_UZ_D_Voltage_3V3_to_15V_output.PDF

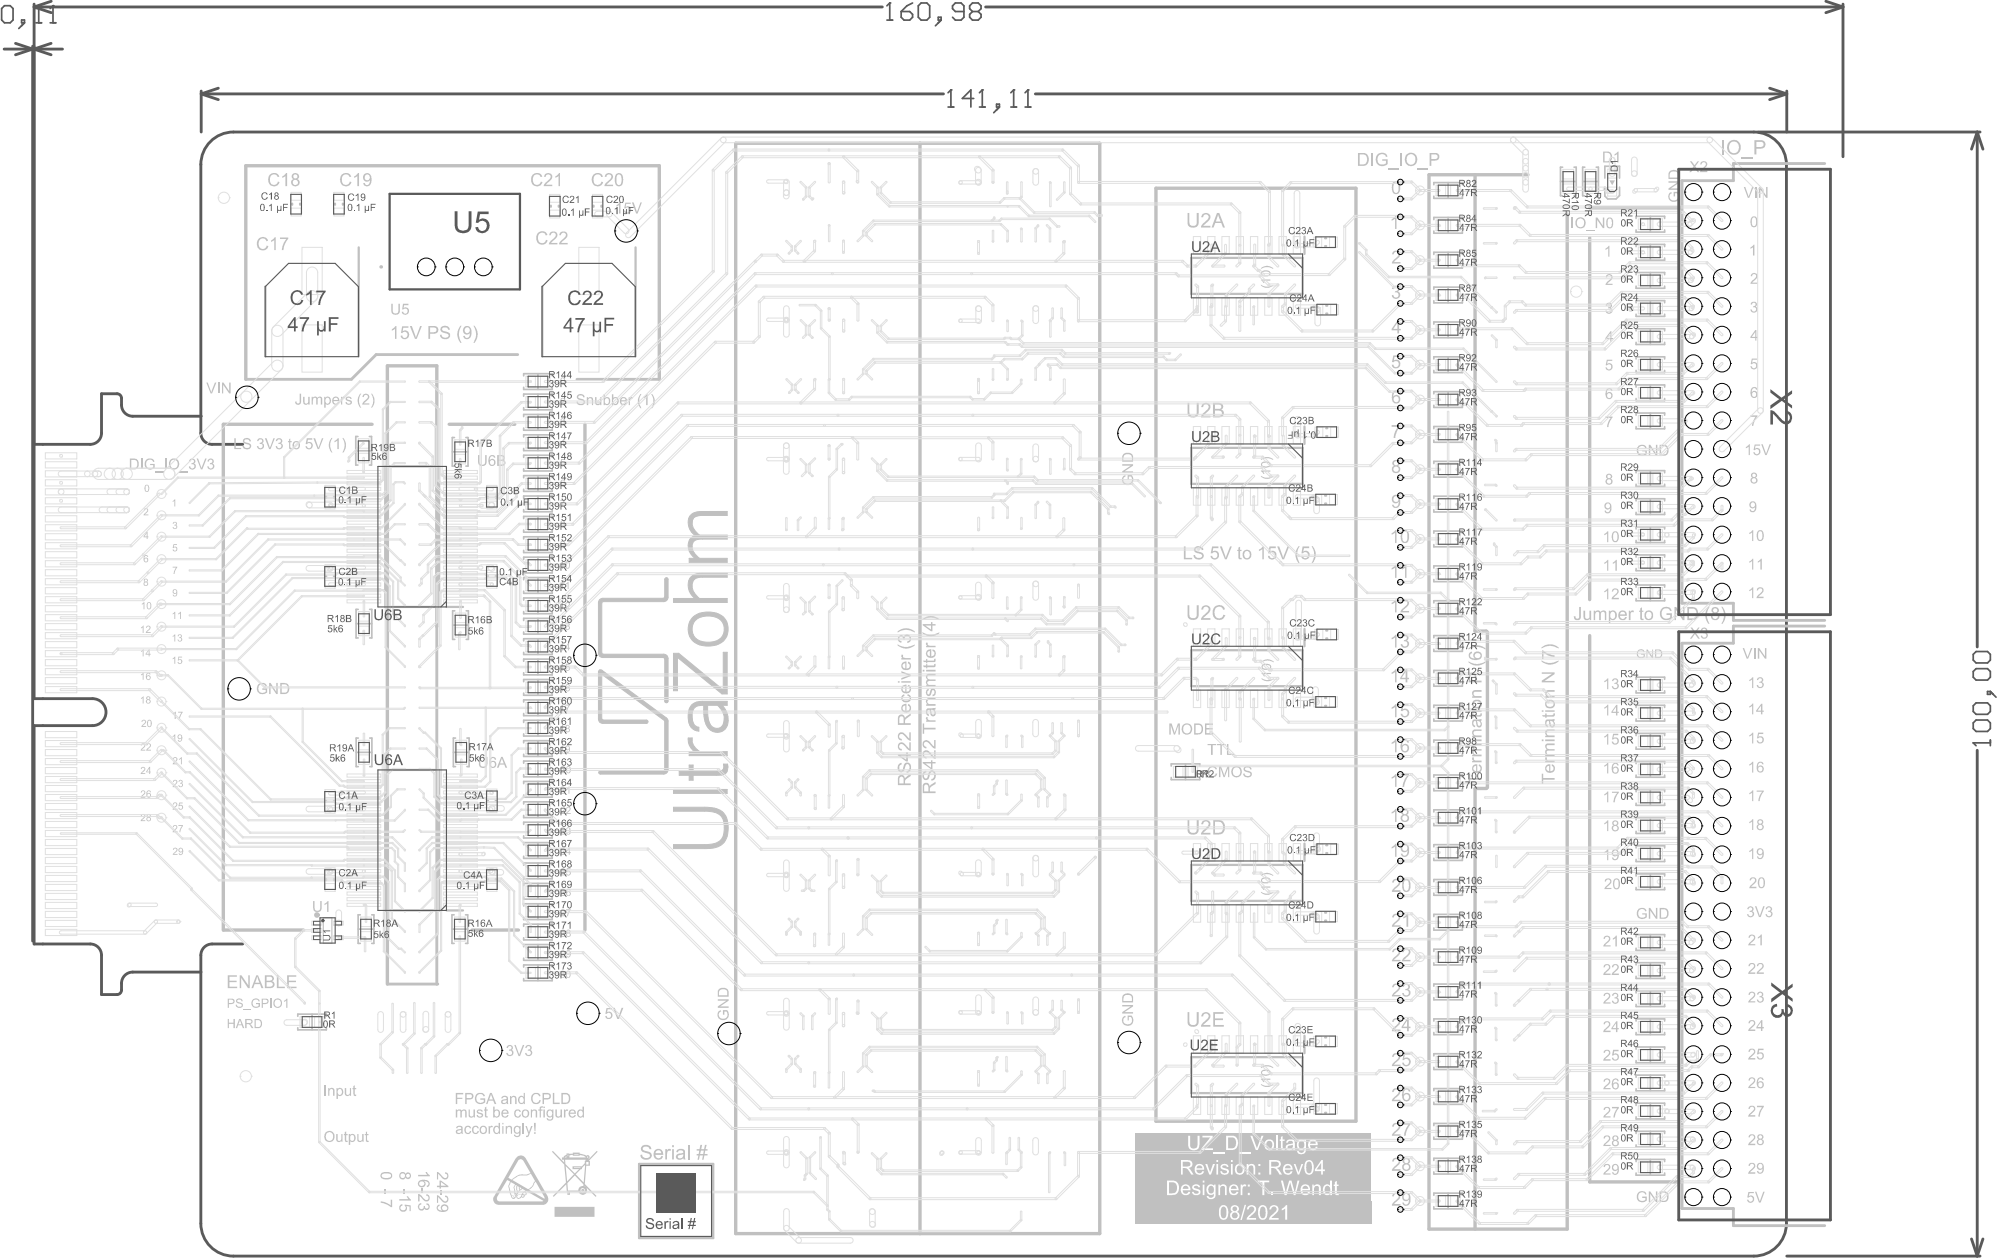
[picture p29: page 1]
