ultrazohm/uz_d_voltage/Project Outputs for UZ_D_Voltage/Rev04/ASM/ASM_UZ_D_Voltage_3V3_to_3V3_IO.PDF

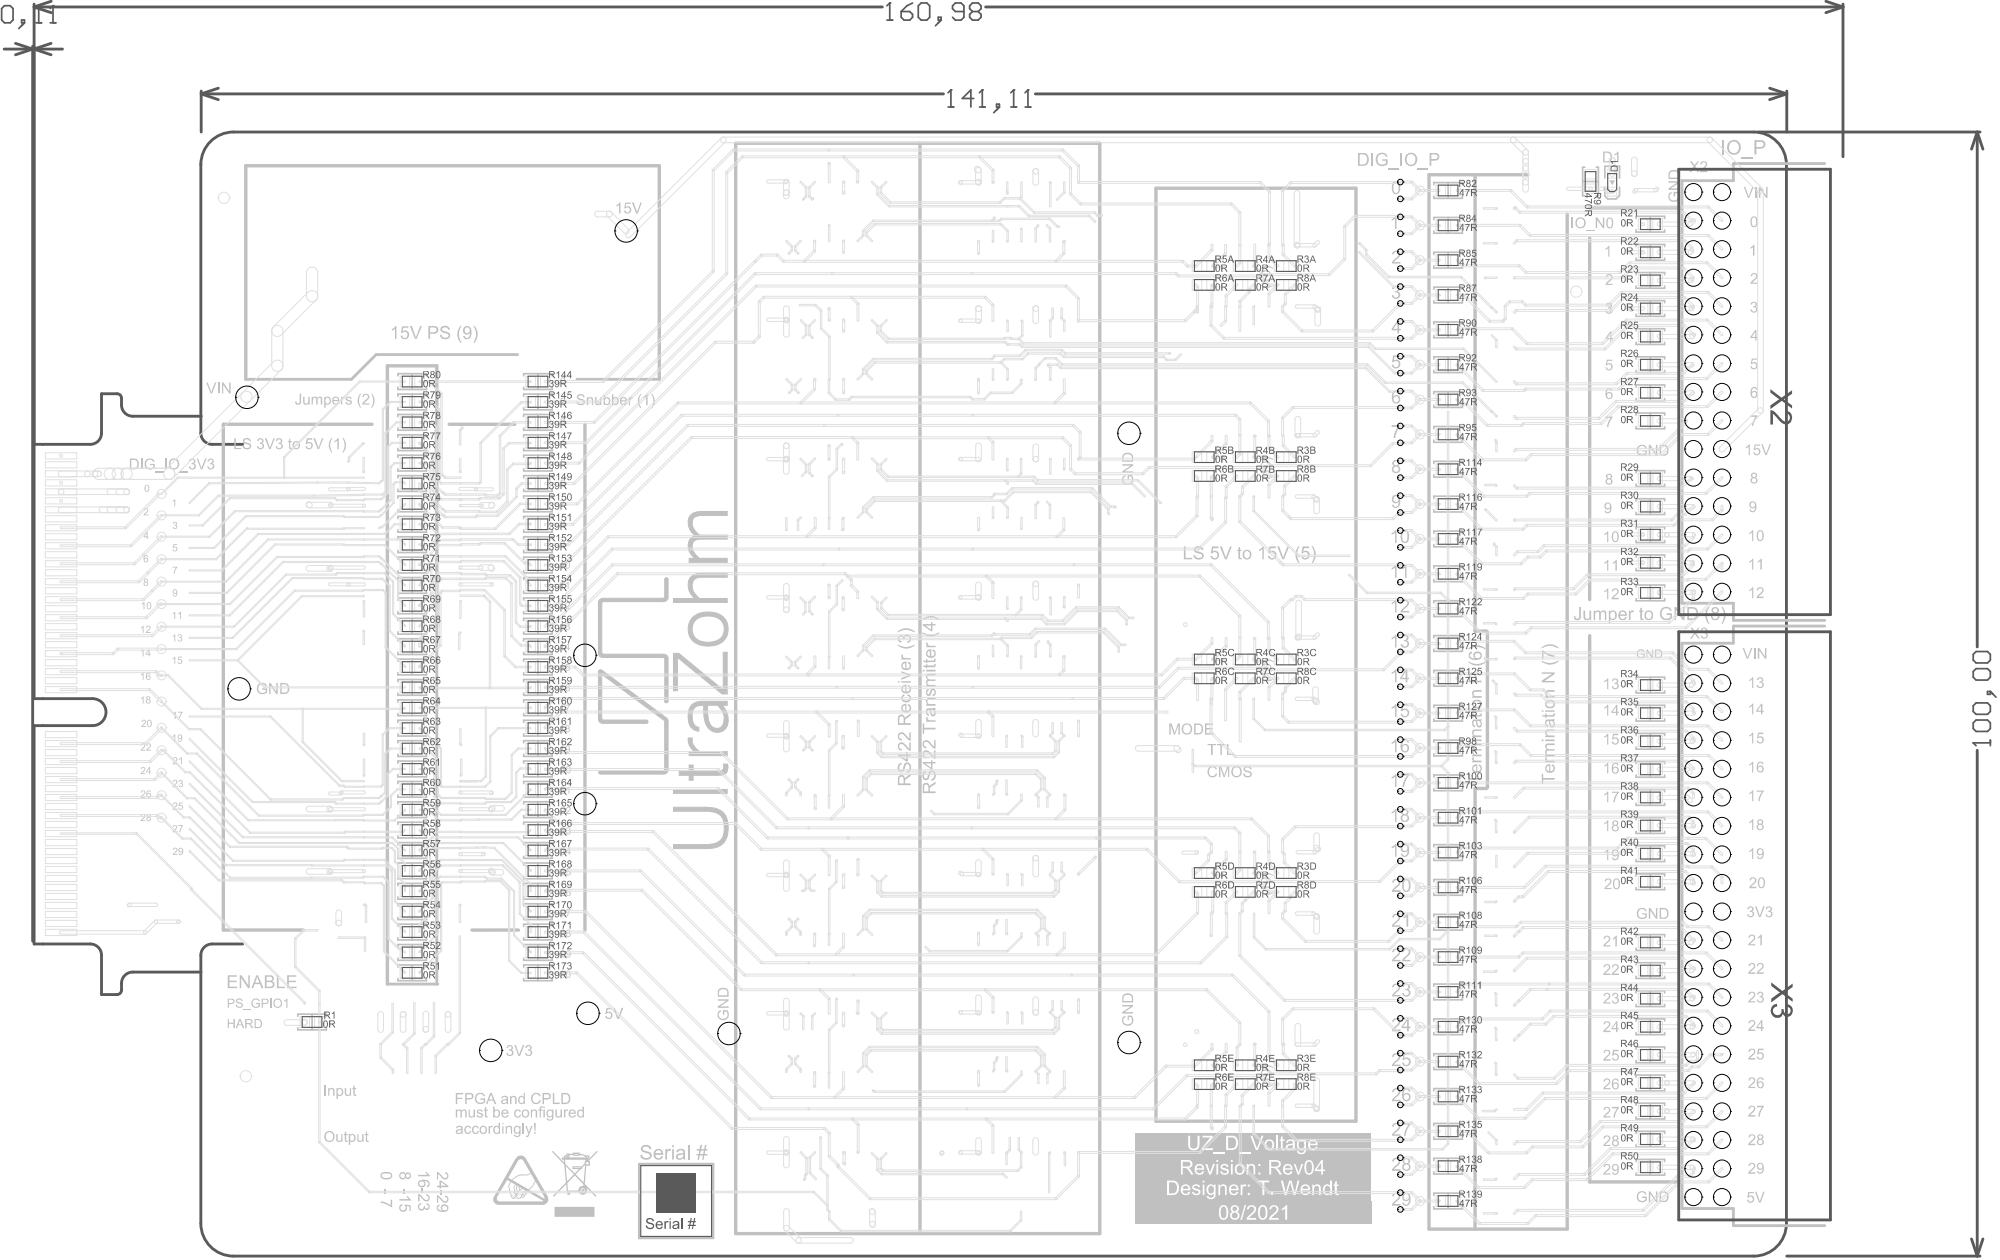
[picture p30: page 1]
