ultrazohm/uz_d_voltage/Project Outputs for UZ_D_Voltage/Rev04/ASM/ASM_UZ_D_Voltage_3V3_to_RS422_output.PDF

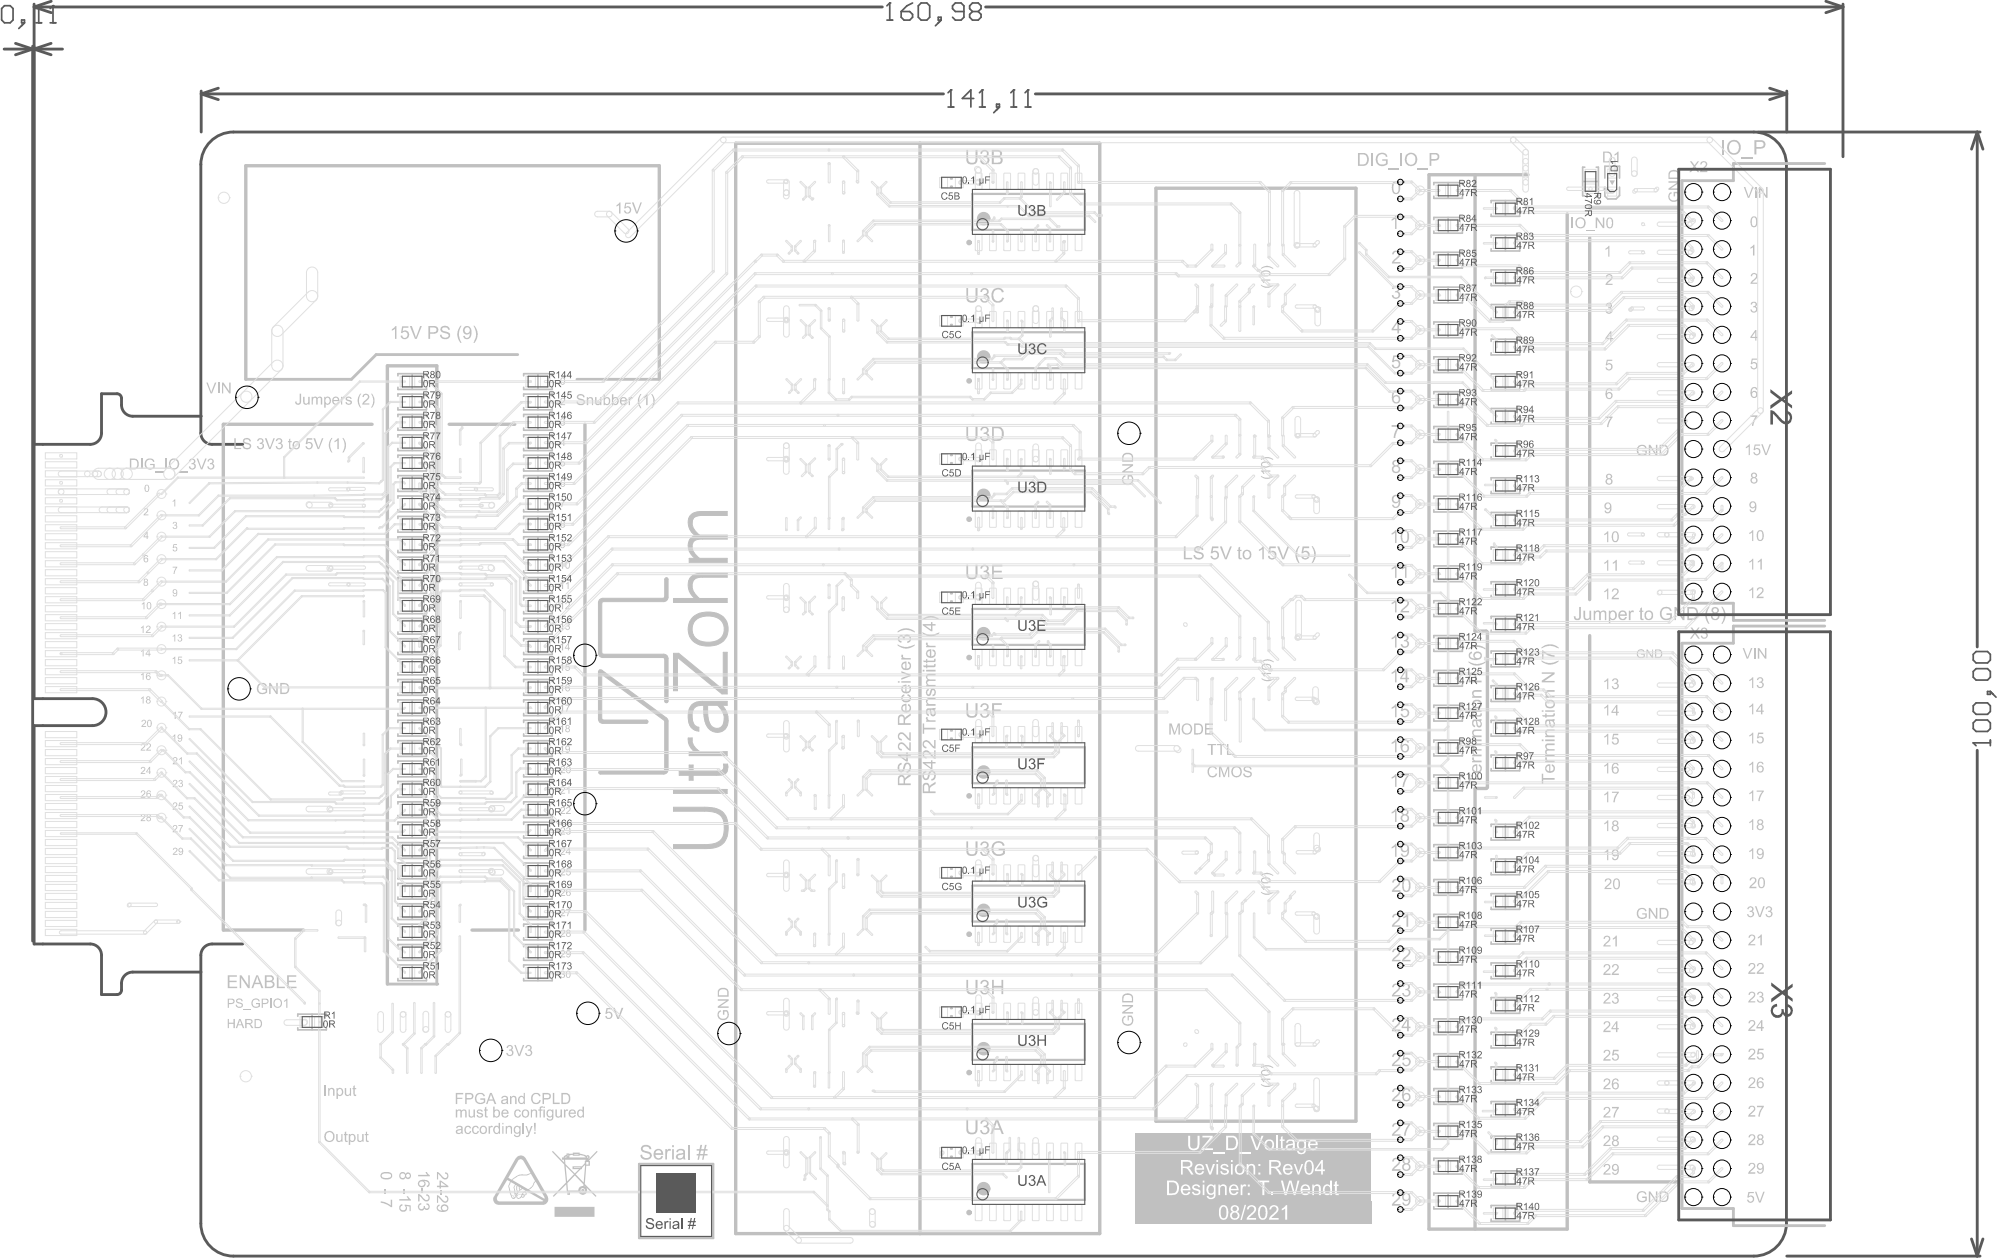
[picture p32: page 1]
