ultrazohm/uz_d_voltage/Project Outputs for UZ_D_Voltage/Rev04/ASM/ASM_UZ_D_Voltage_No Variations.PDF

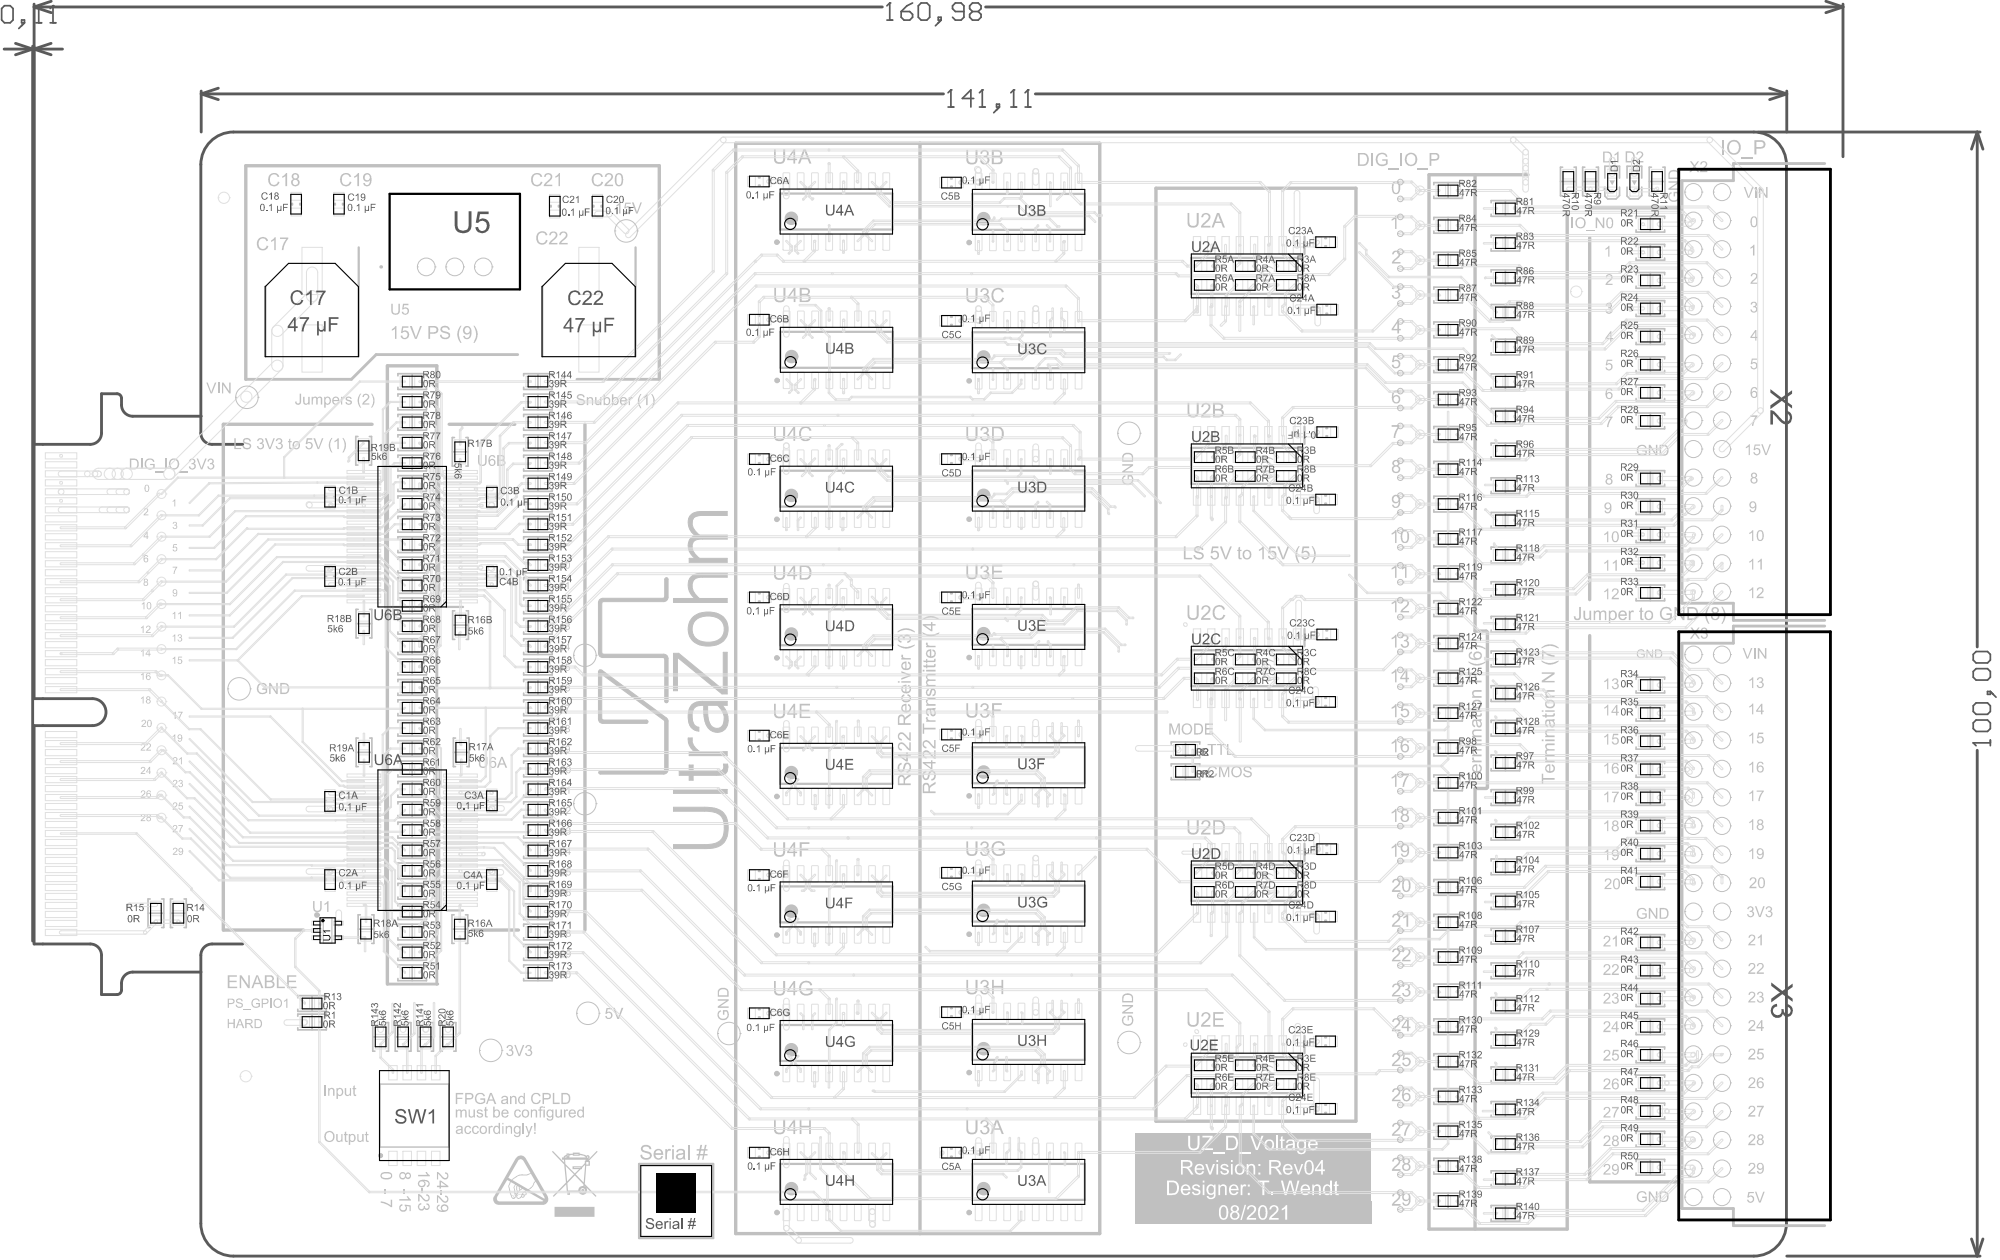
[picture p33: page 1]
