ultrazohm/uz_d_voltage/Project Outputs for UZ_D_Voltage/Rev04/ASM/ASM_UZ_D_Voltage_RS422_to_3V3_input.PDF

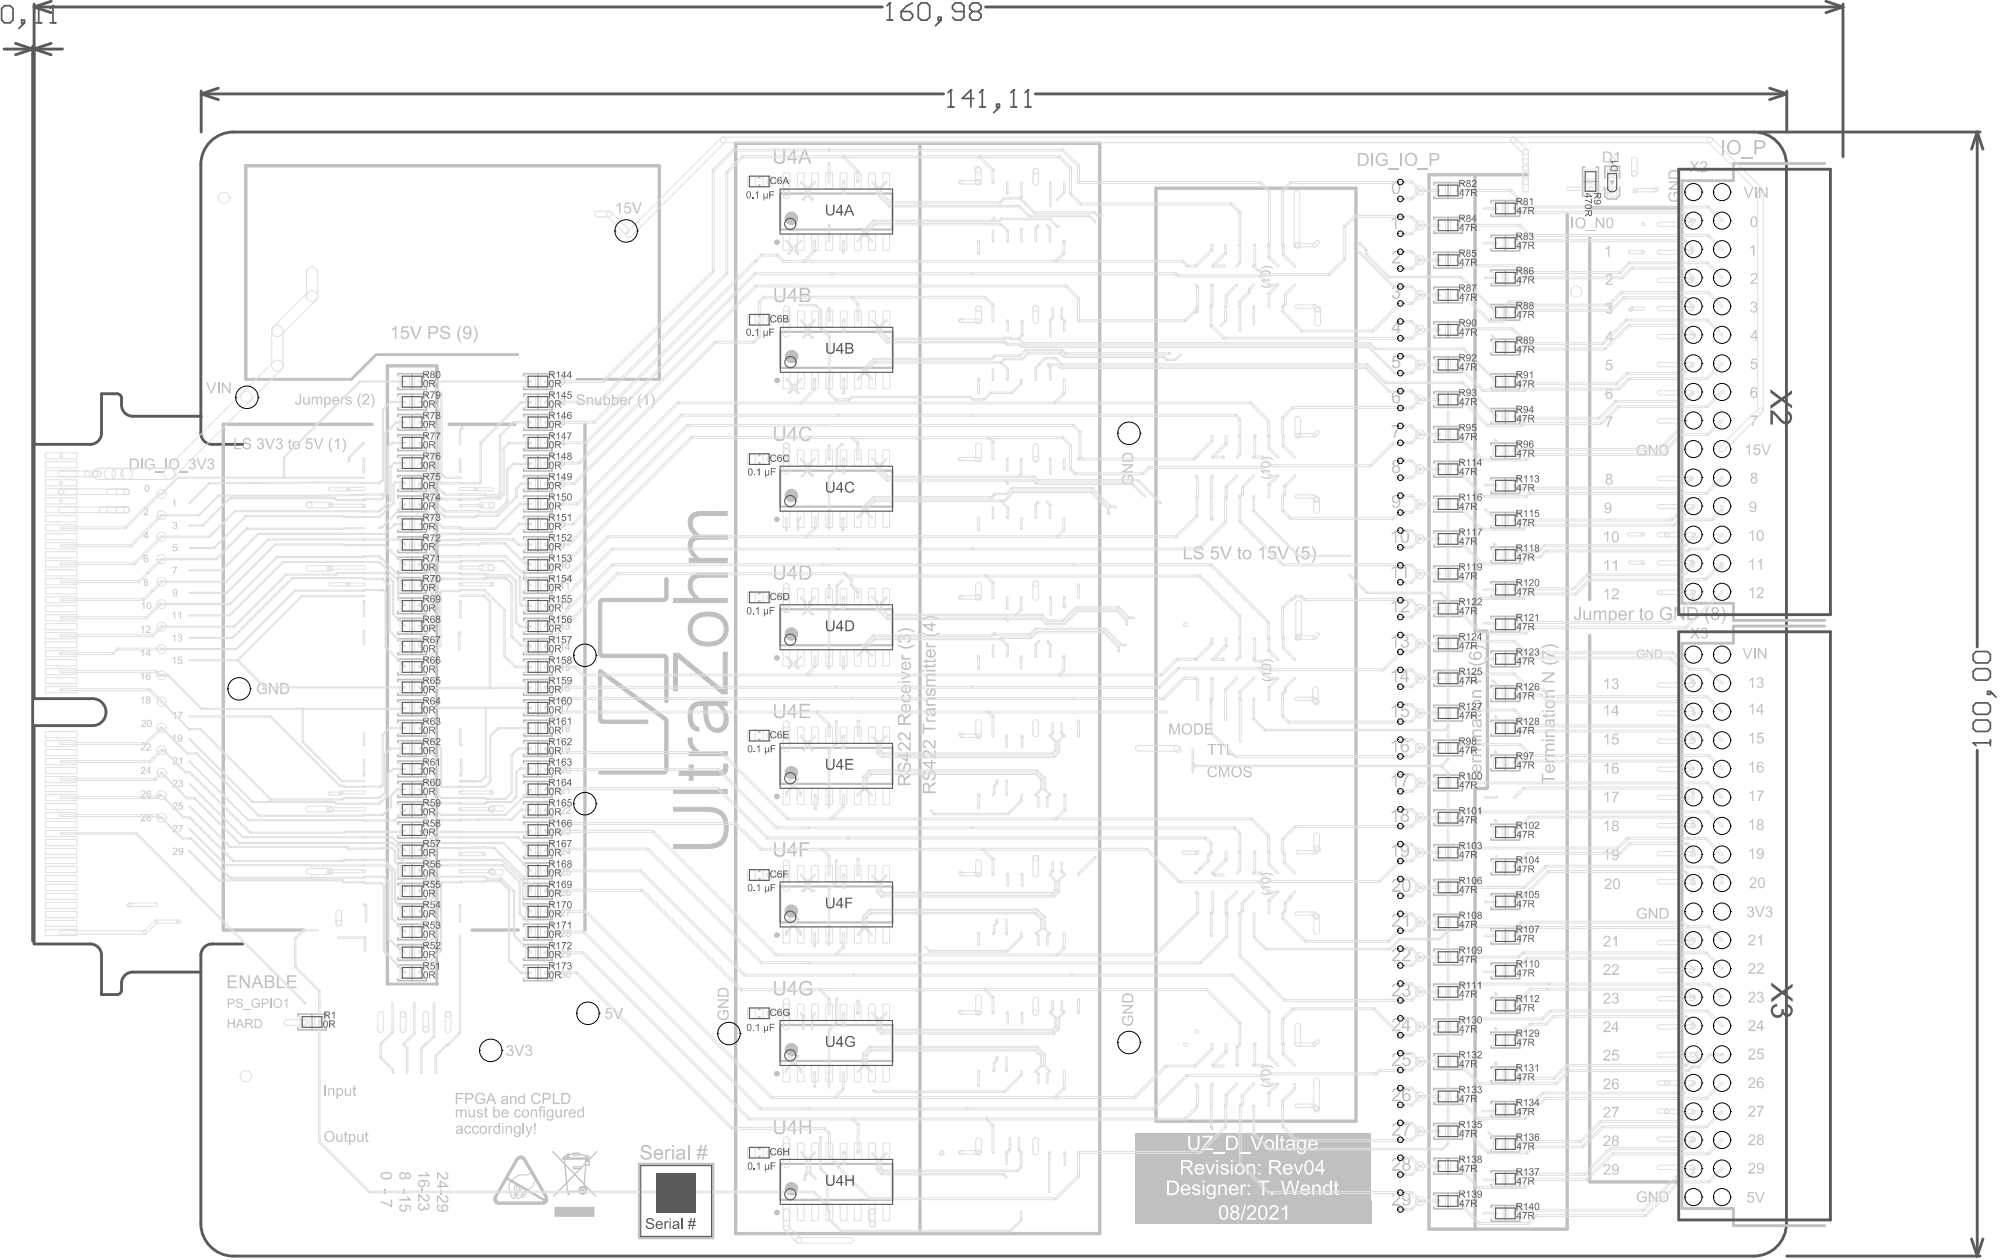
[picture p35: page 1]
