ultrazohm/uz_d_voltage/Project Outputs for UZ_D_Voltage/Rev04/DOC/3D_View_Top_UltraZohm_Digital_Voltage.PDF

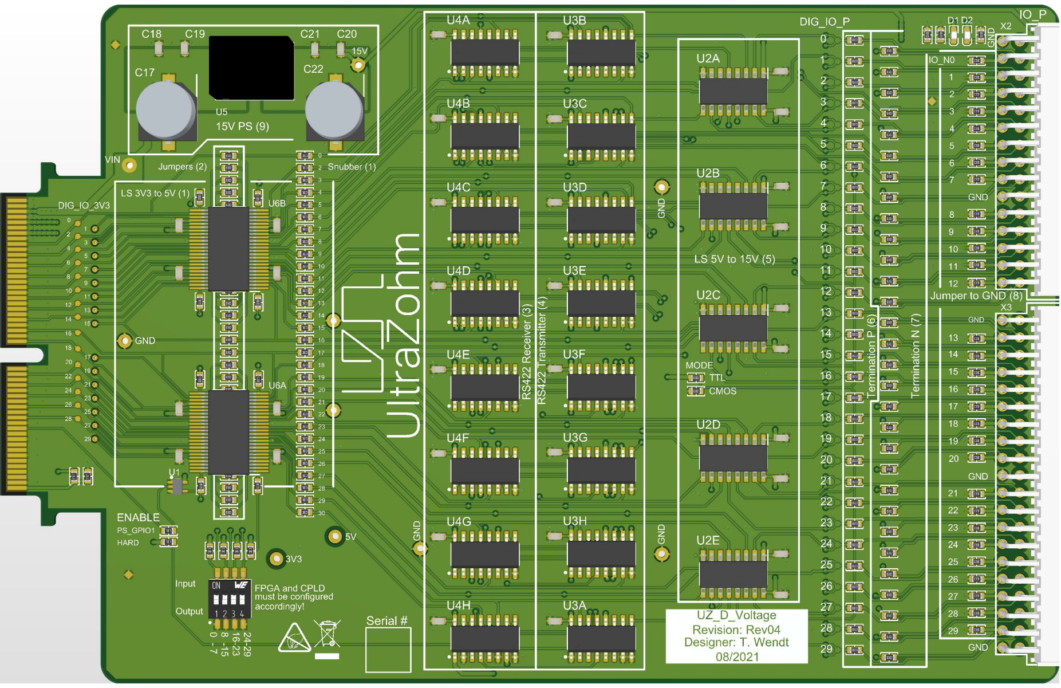
[picture p36: page 1]
