ultrazohm/uz_d_voltage/Project Outputs for UZ_D_Voltage/3v00/ASM/ASM_UltraZohm_DigitalVoltage_3V3_to_3V3_IO.PDF

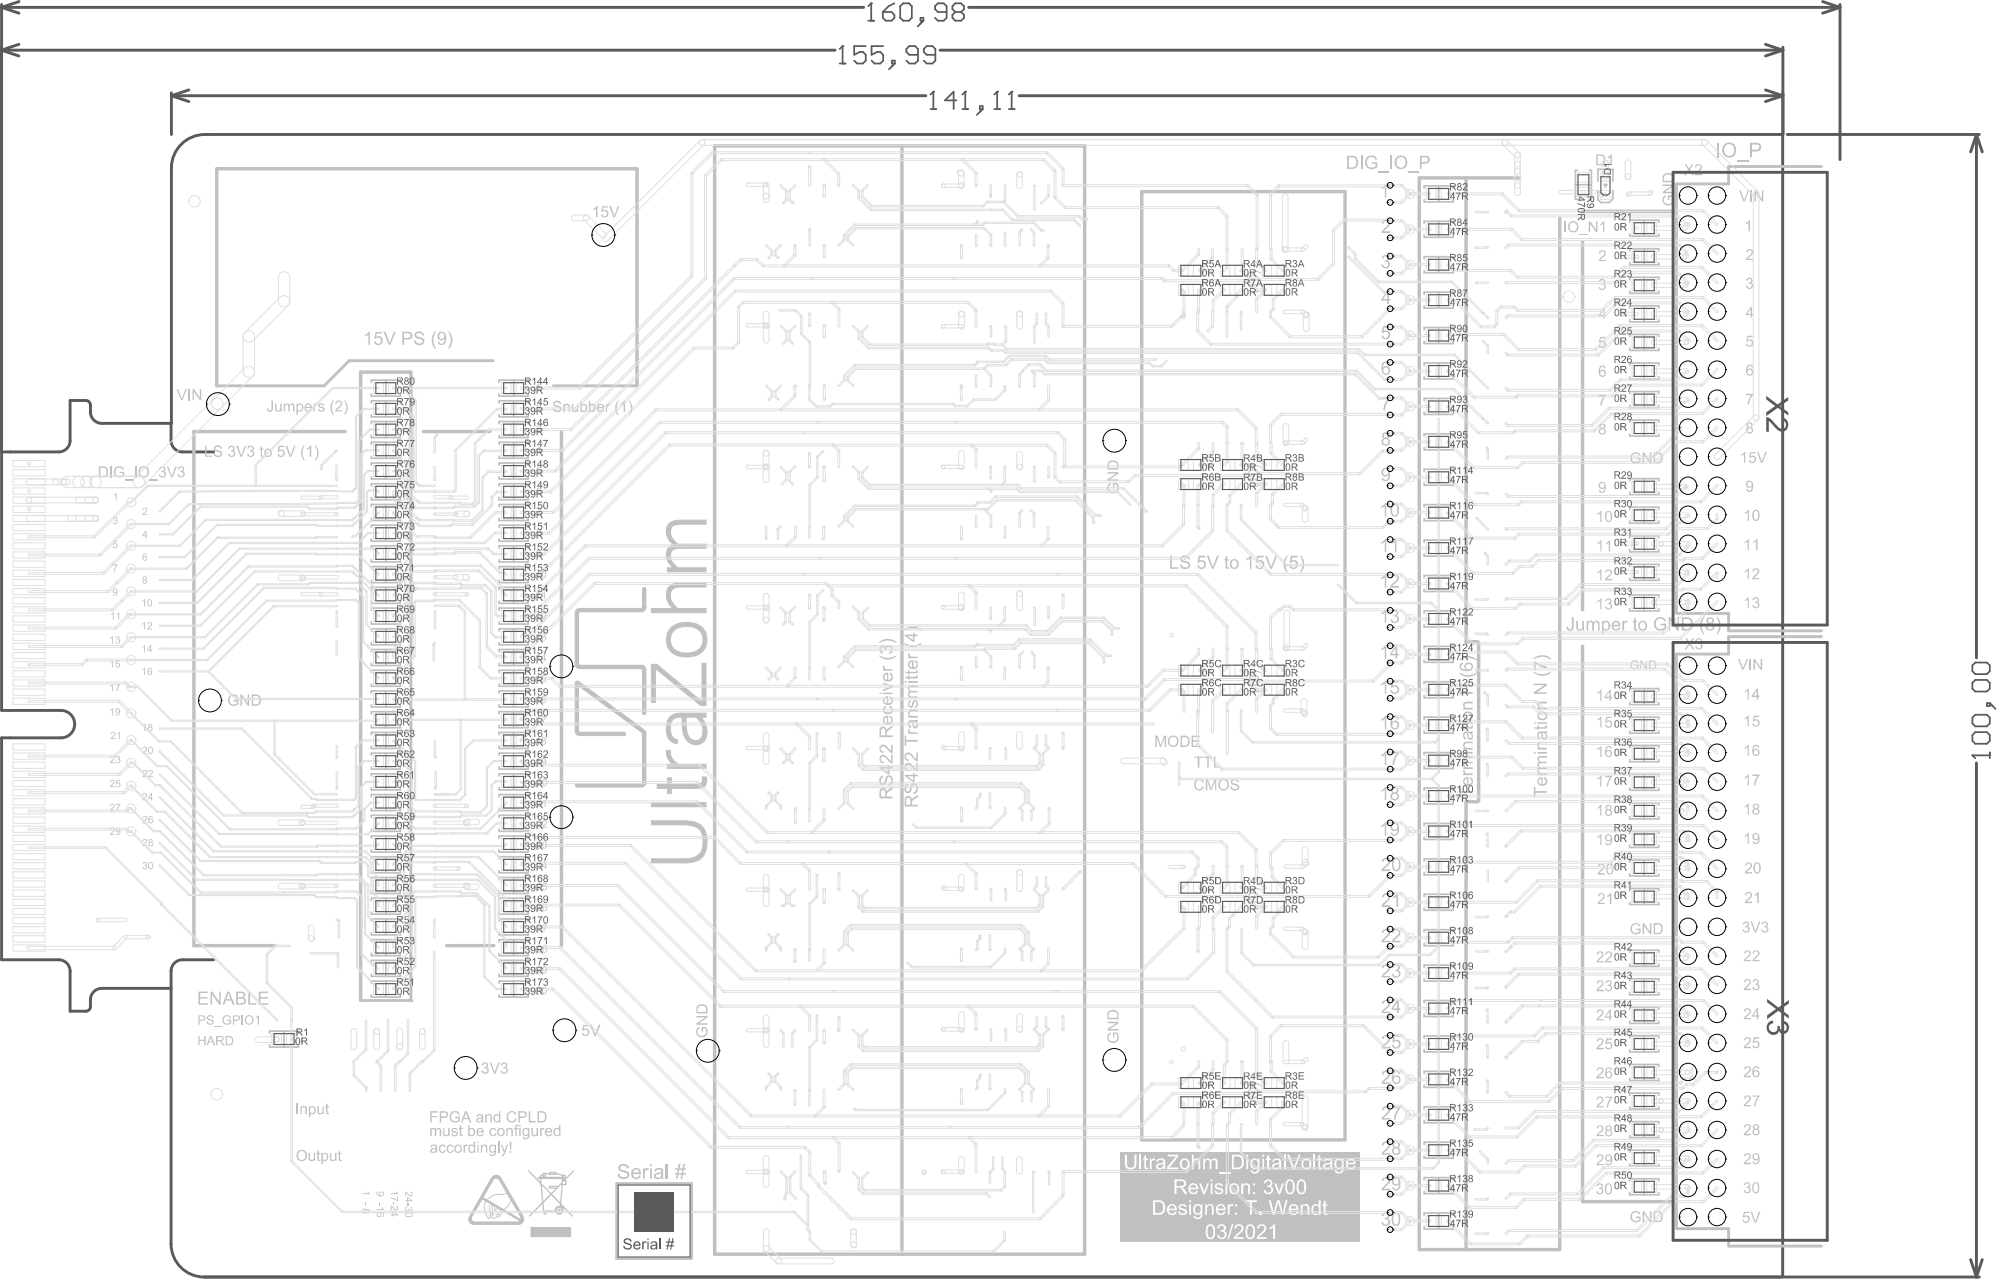
[picture p38: page 1]
