ultrazohm/uz_d_voltage/Project Outputs for UZ_D_Voltage/3v00/ASM/ASM_UltraZohm_DigitalVoltage_3V3_to_RS422_output.PDF

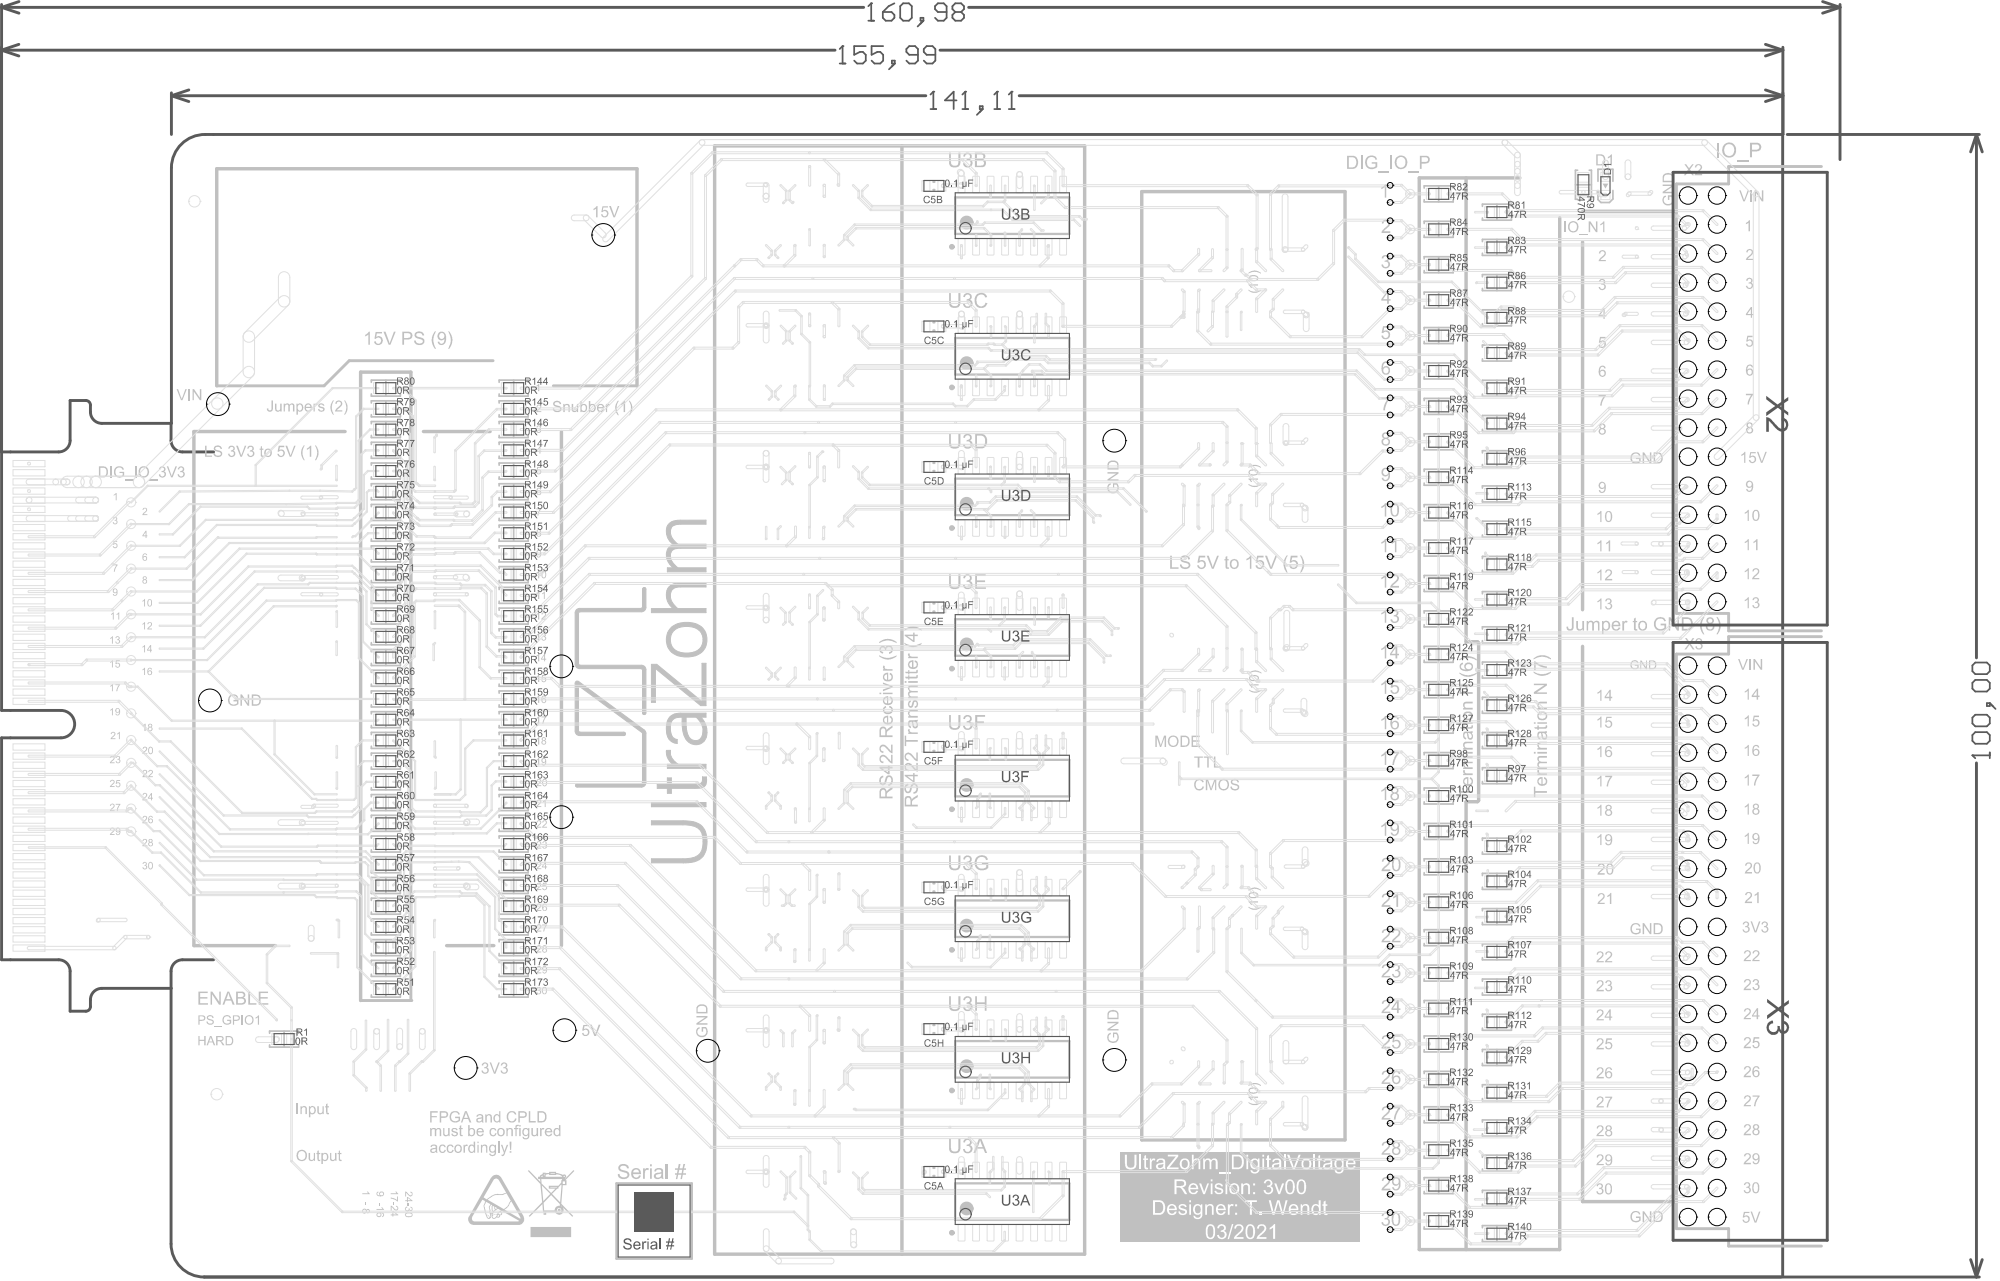
[picture p40: page 1]
