ultrazohm/uz_d_voltage/Project Outputs for UZ_D_Voltage/3v00/ASM/ASM_UltraZohm_DigitalVoltage_No Variations.PDF

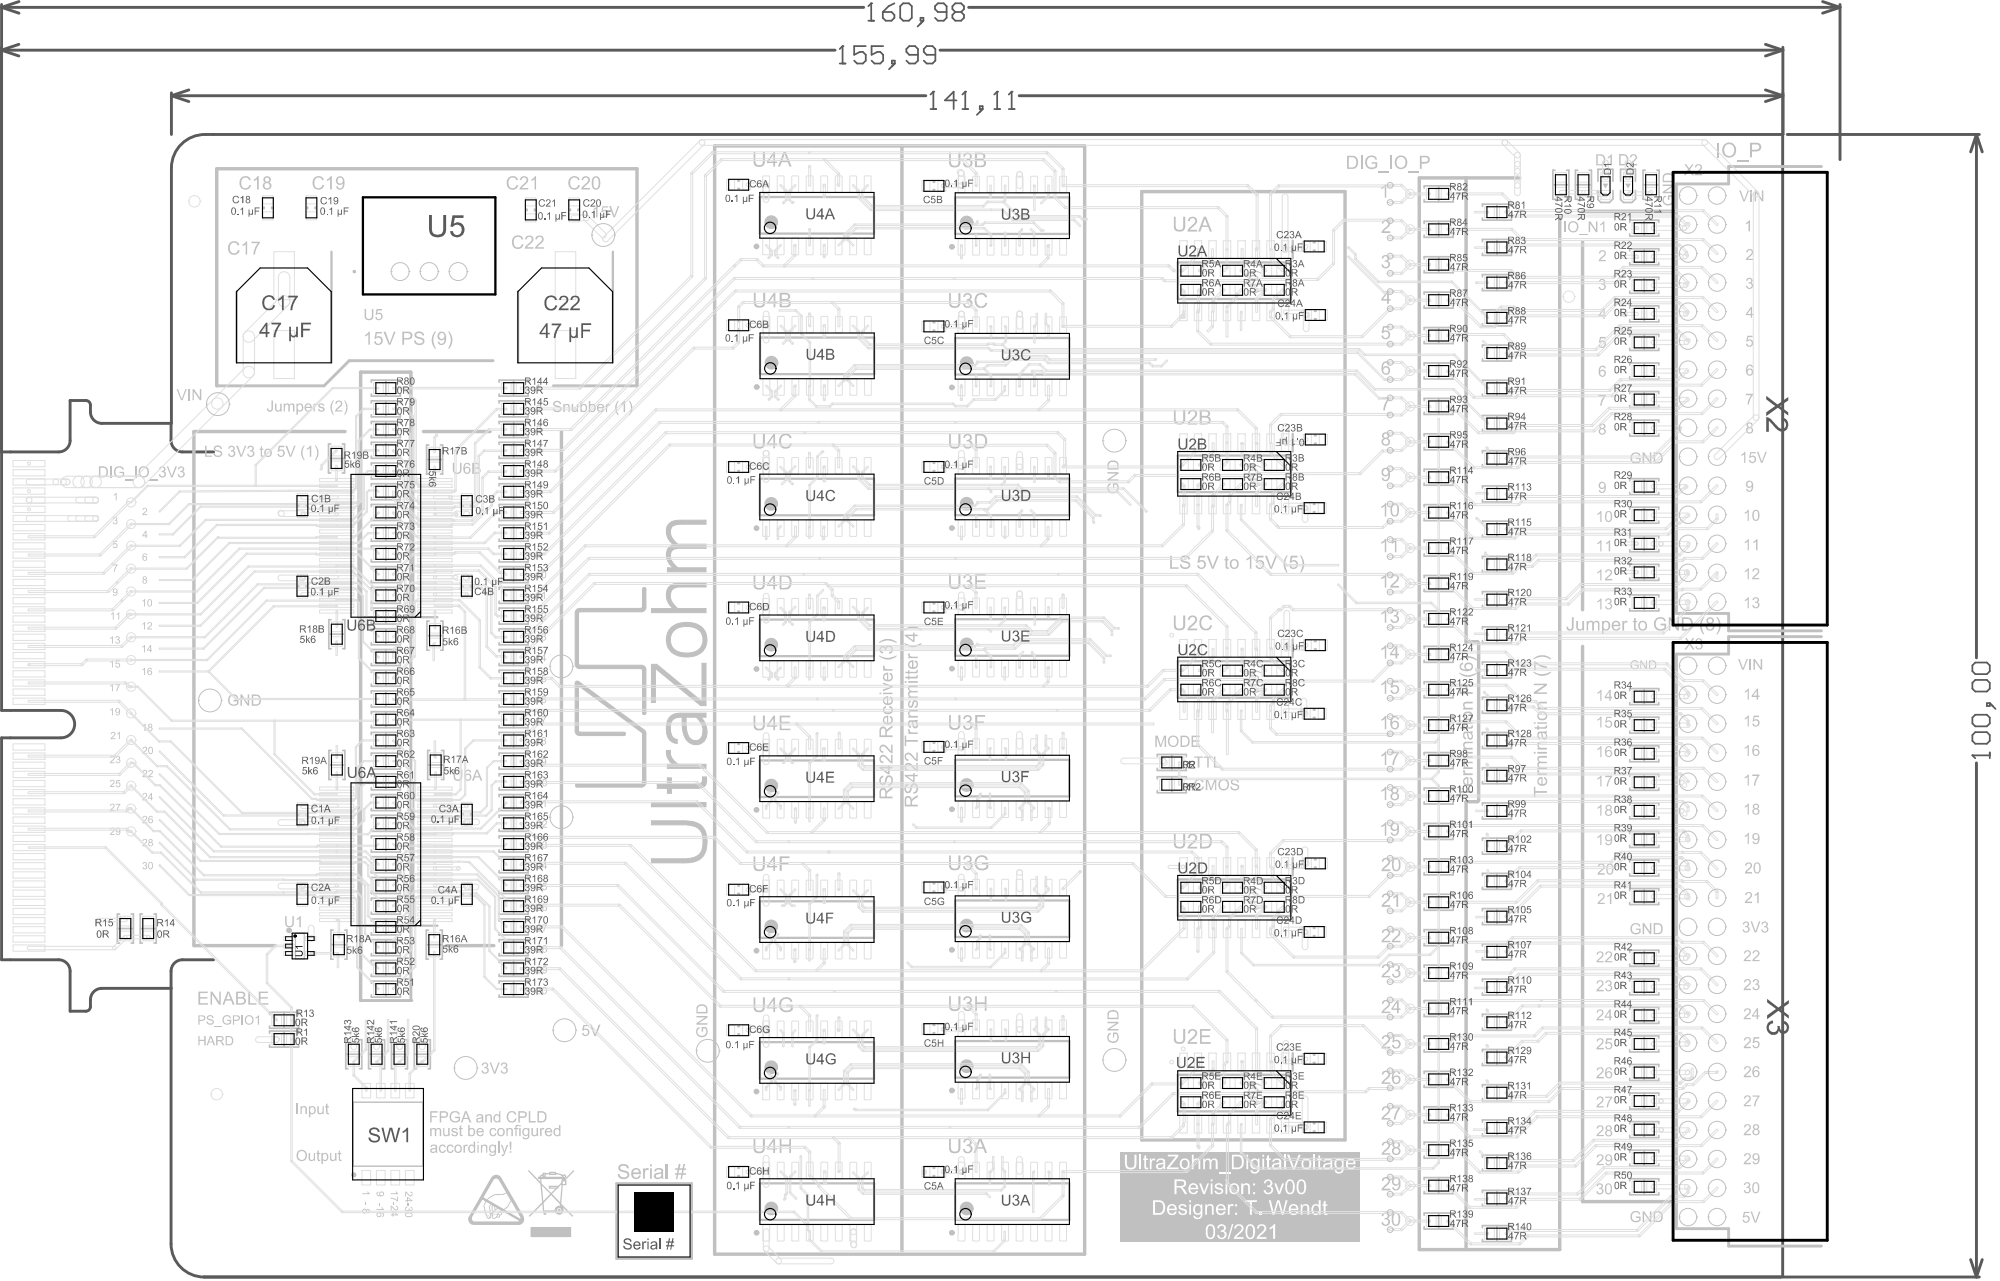
[picture p41: page 1]
