ultrazohm/uz_d_voltage/Project Outputs for UZ_D_Voltage/3v00/ASM/ASM_UltraZohm_DigitalVoltage_RS422_to_3V3_input.PDF

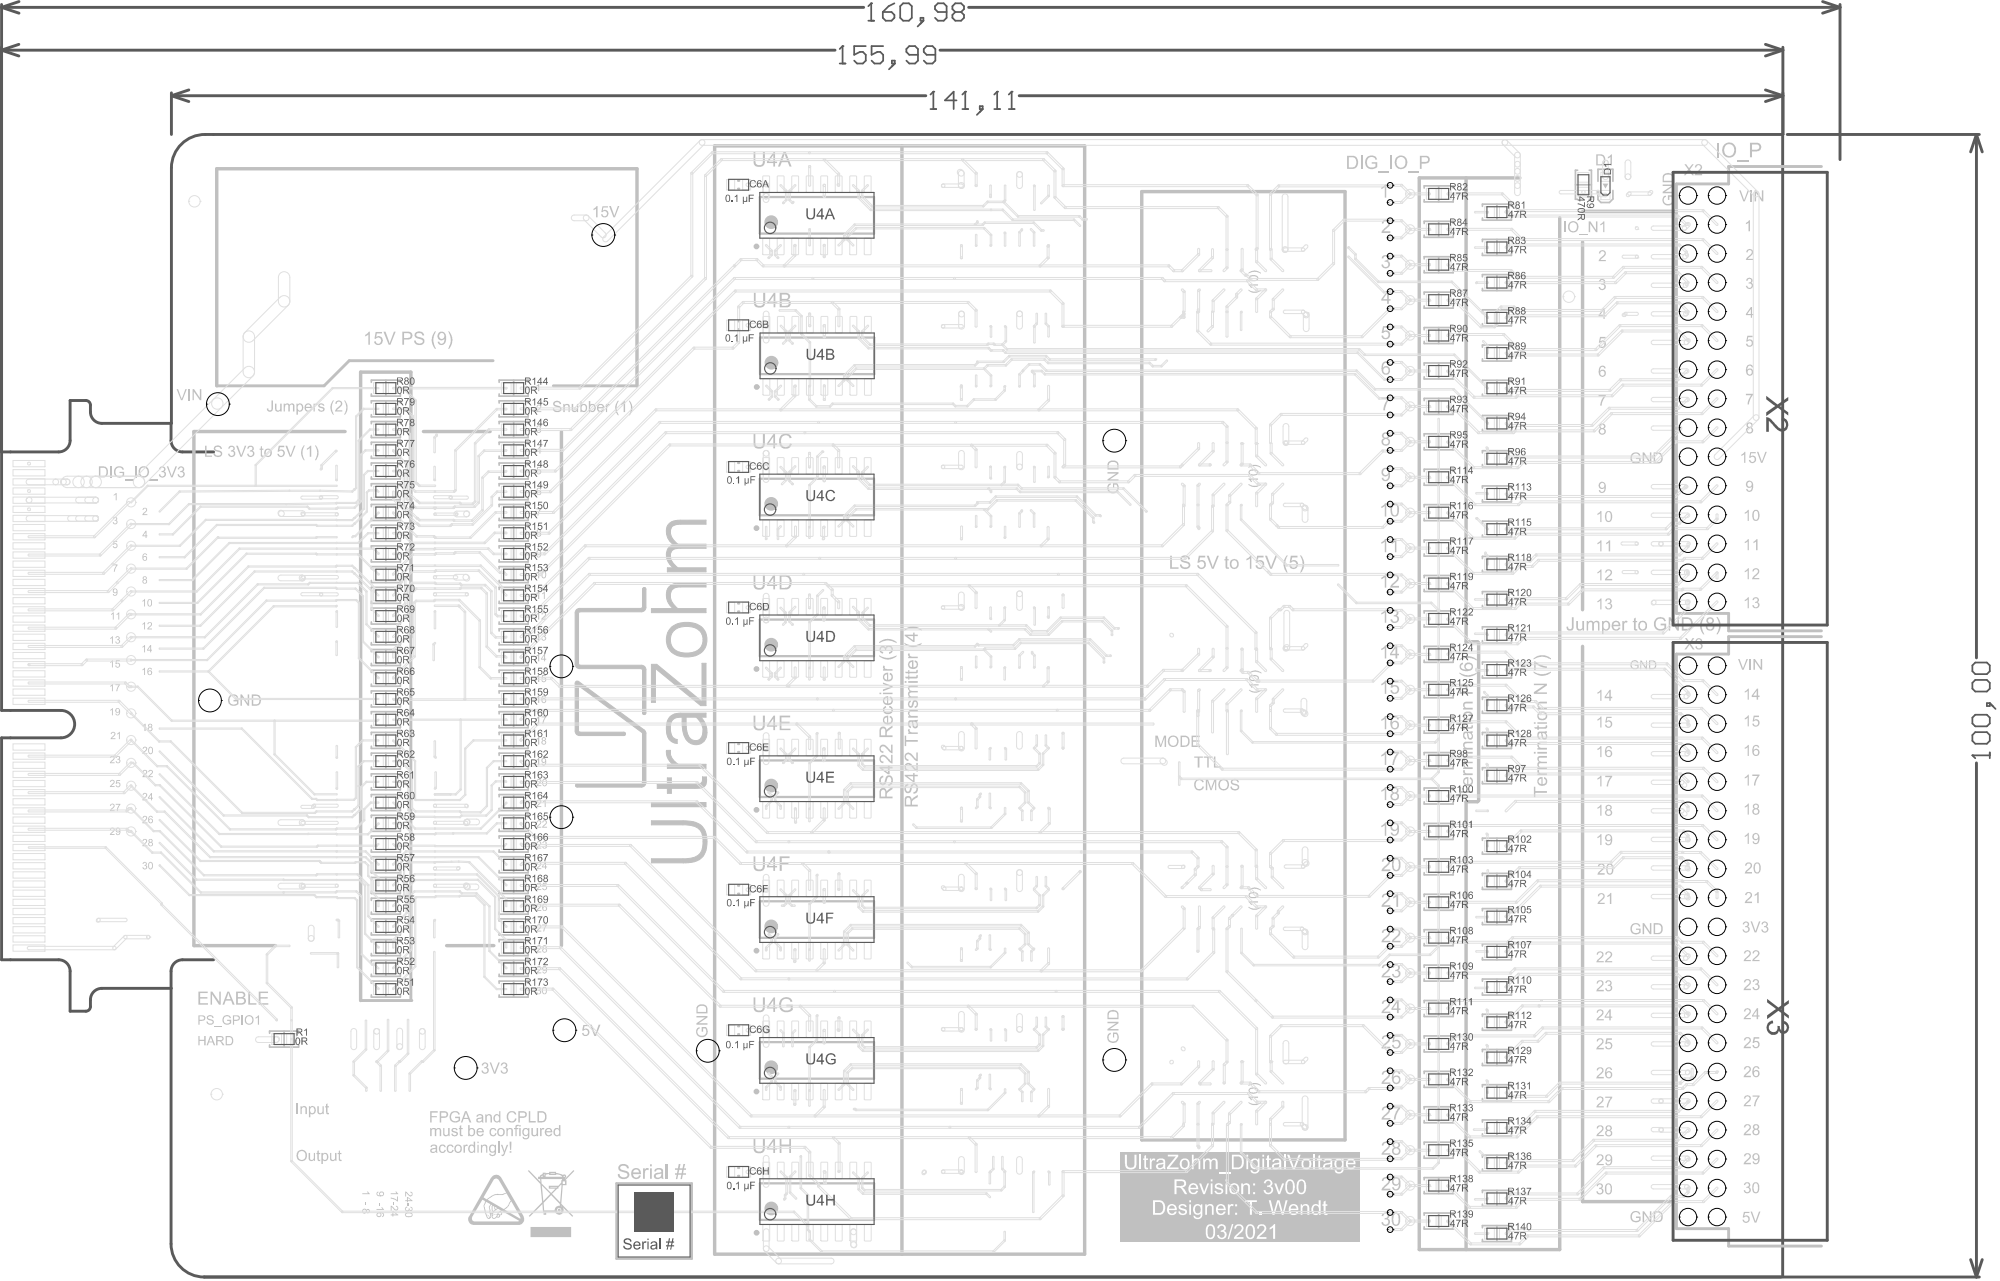
[picture p43: page 1]
