ultrazohm/uz_d_voltage/Project Outputs for UZ_D_Voltage/3v00/DOC/3D_View_Top_UltraZohm_Digital_Voltage.PDF

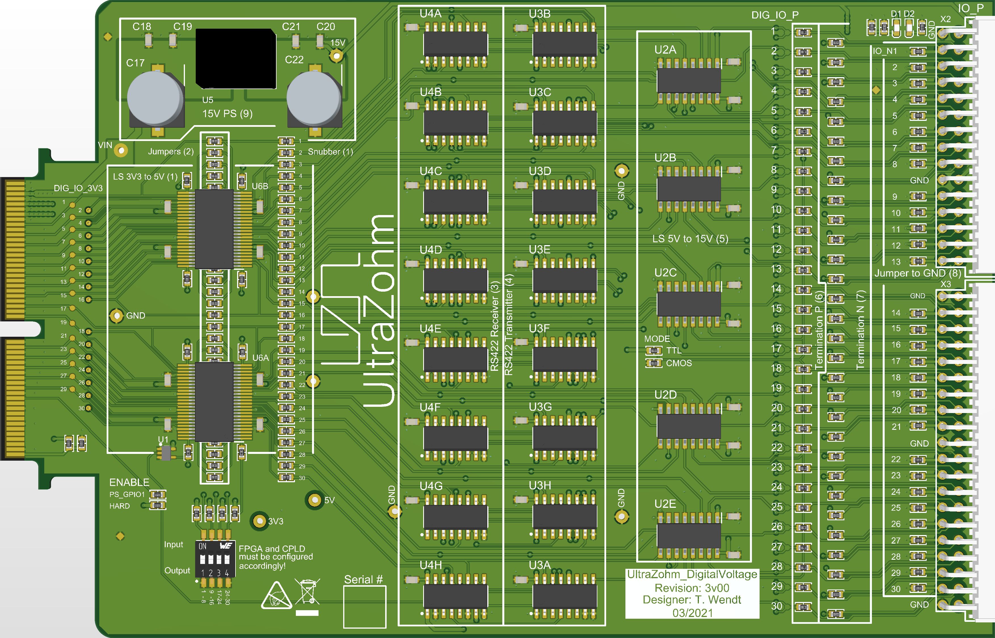
[picture p44: page 1]
