ultrazohm/uz_d_voltage/Project Outputs for UZ_D_Voltage/2v01/ASM/ASM_UltraZohm_DigitalVoltage_3V3_to_5V_IO.PDF

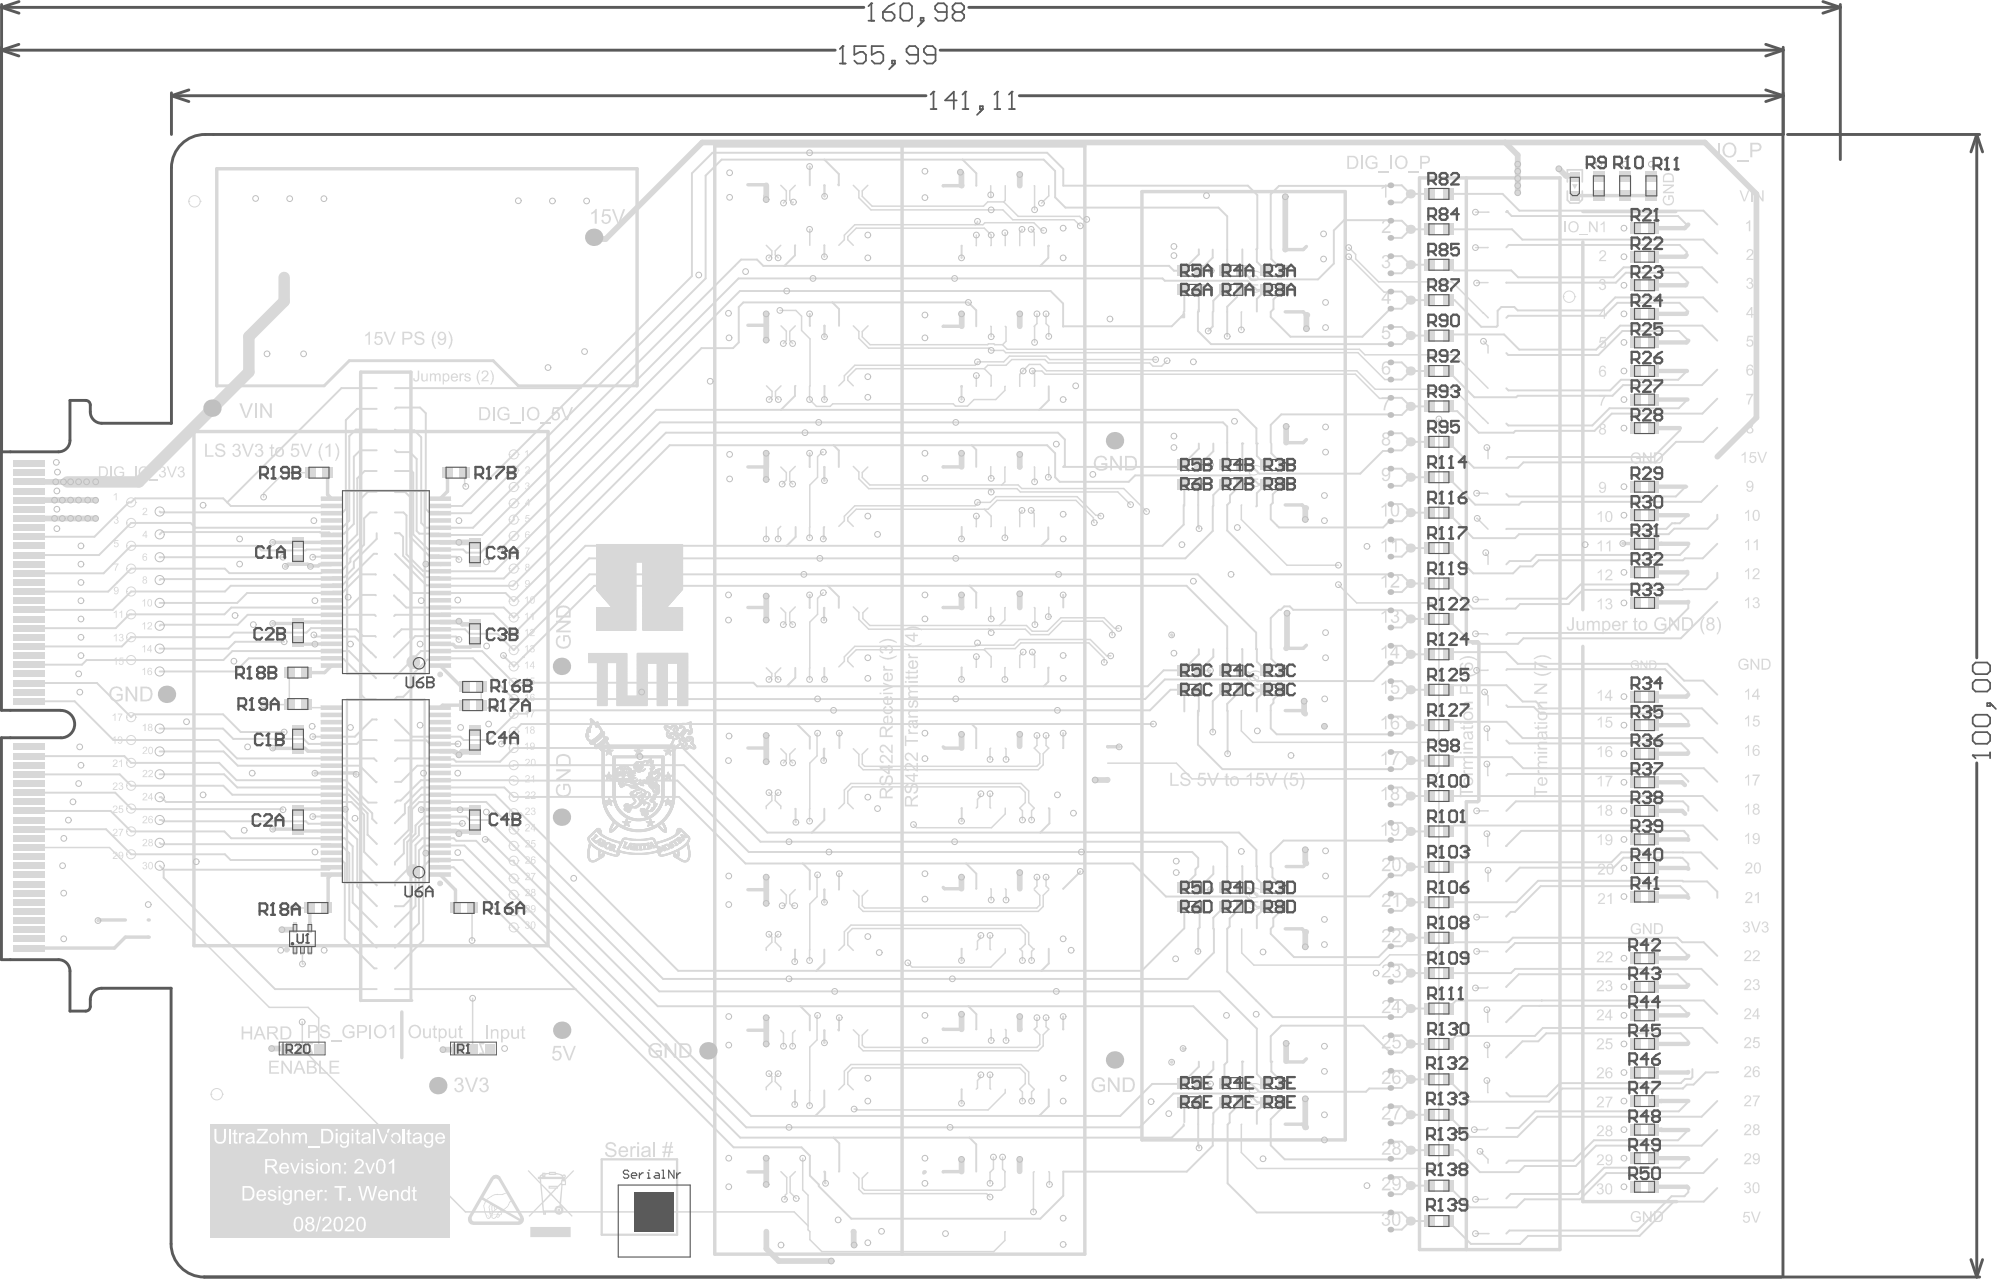
[picture p47: page 1]
