ultrazohm/uz_d_voltage/Project Outputs for UZ_D_Voltage/2v01/ASM/ASM_UltraZohm_DigitalVoltage_3V3_to_RS422_output.PDF

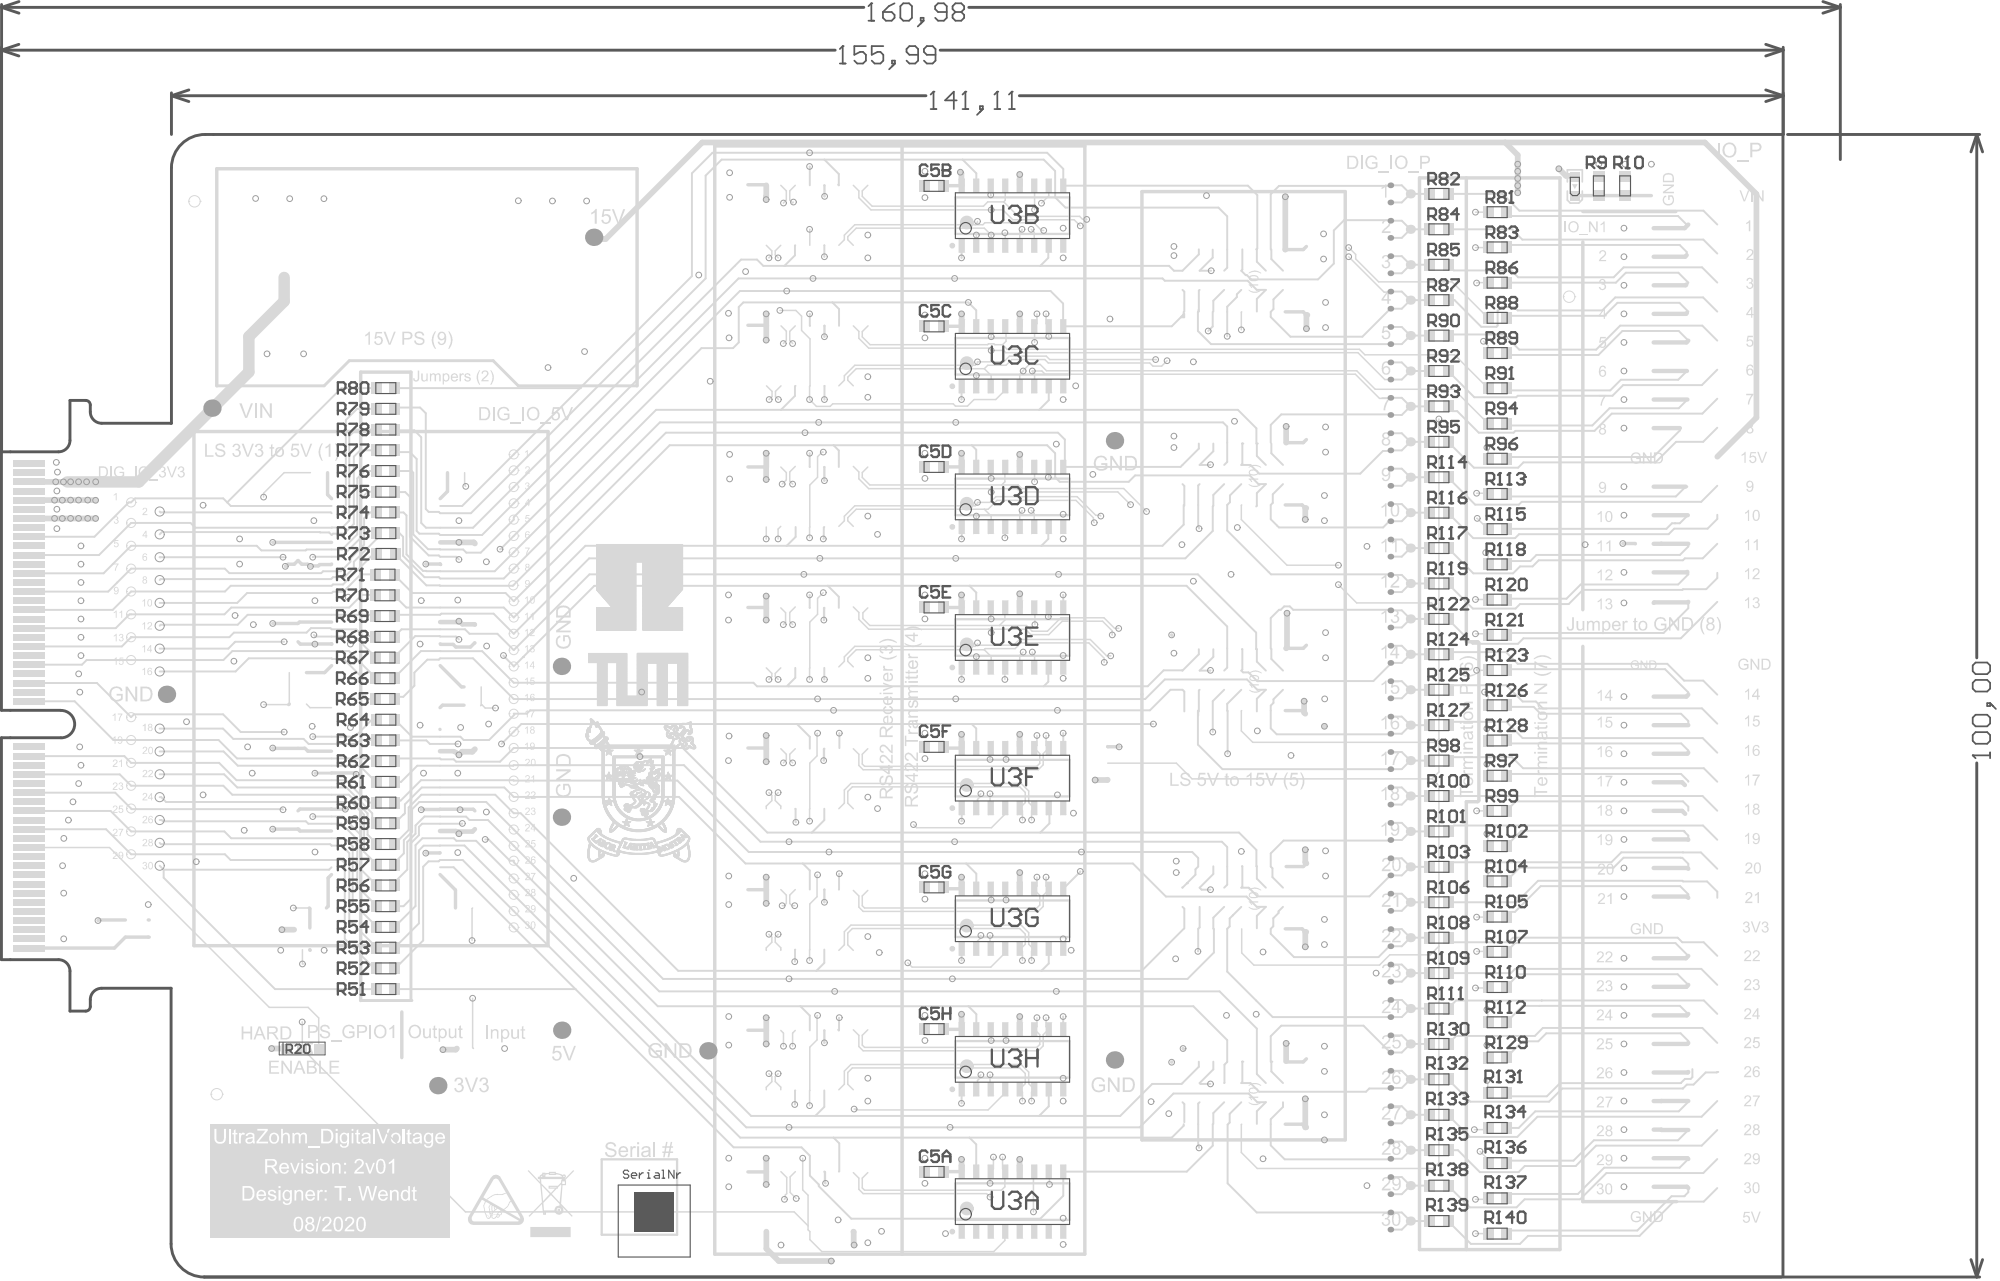
[picture p48: page 1]
