ultrazohm/uz_d_voltage/Project Outputs for UZ_D_Voltage/2v01/ASM/ASM_UltraZohm_DigitalVoltage_No Variations.PDF

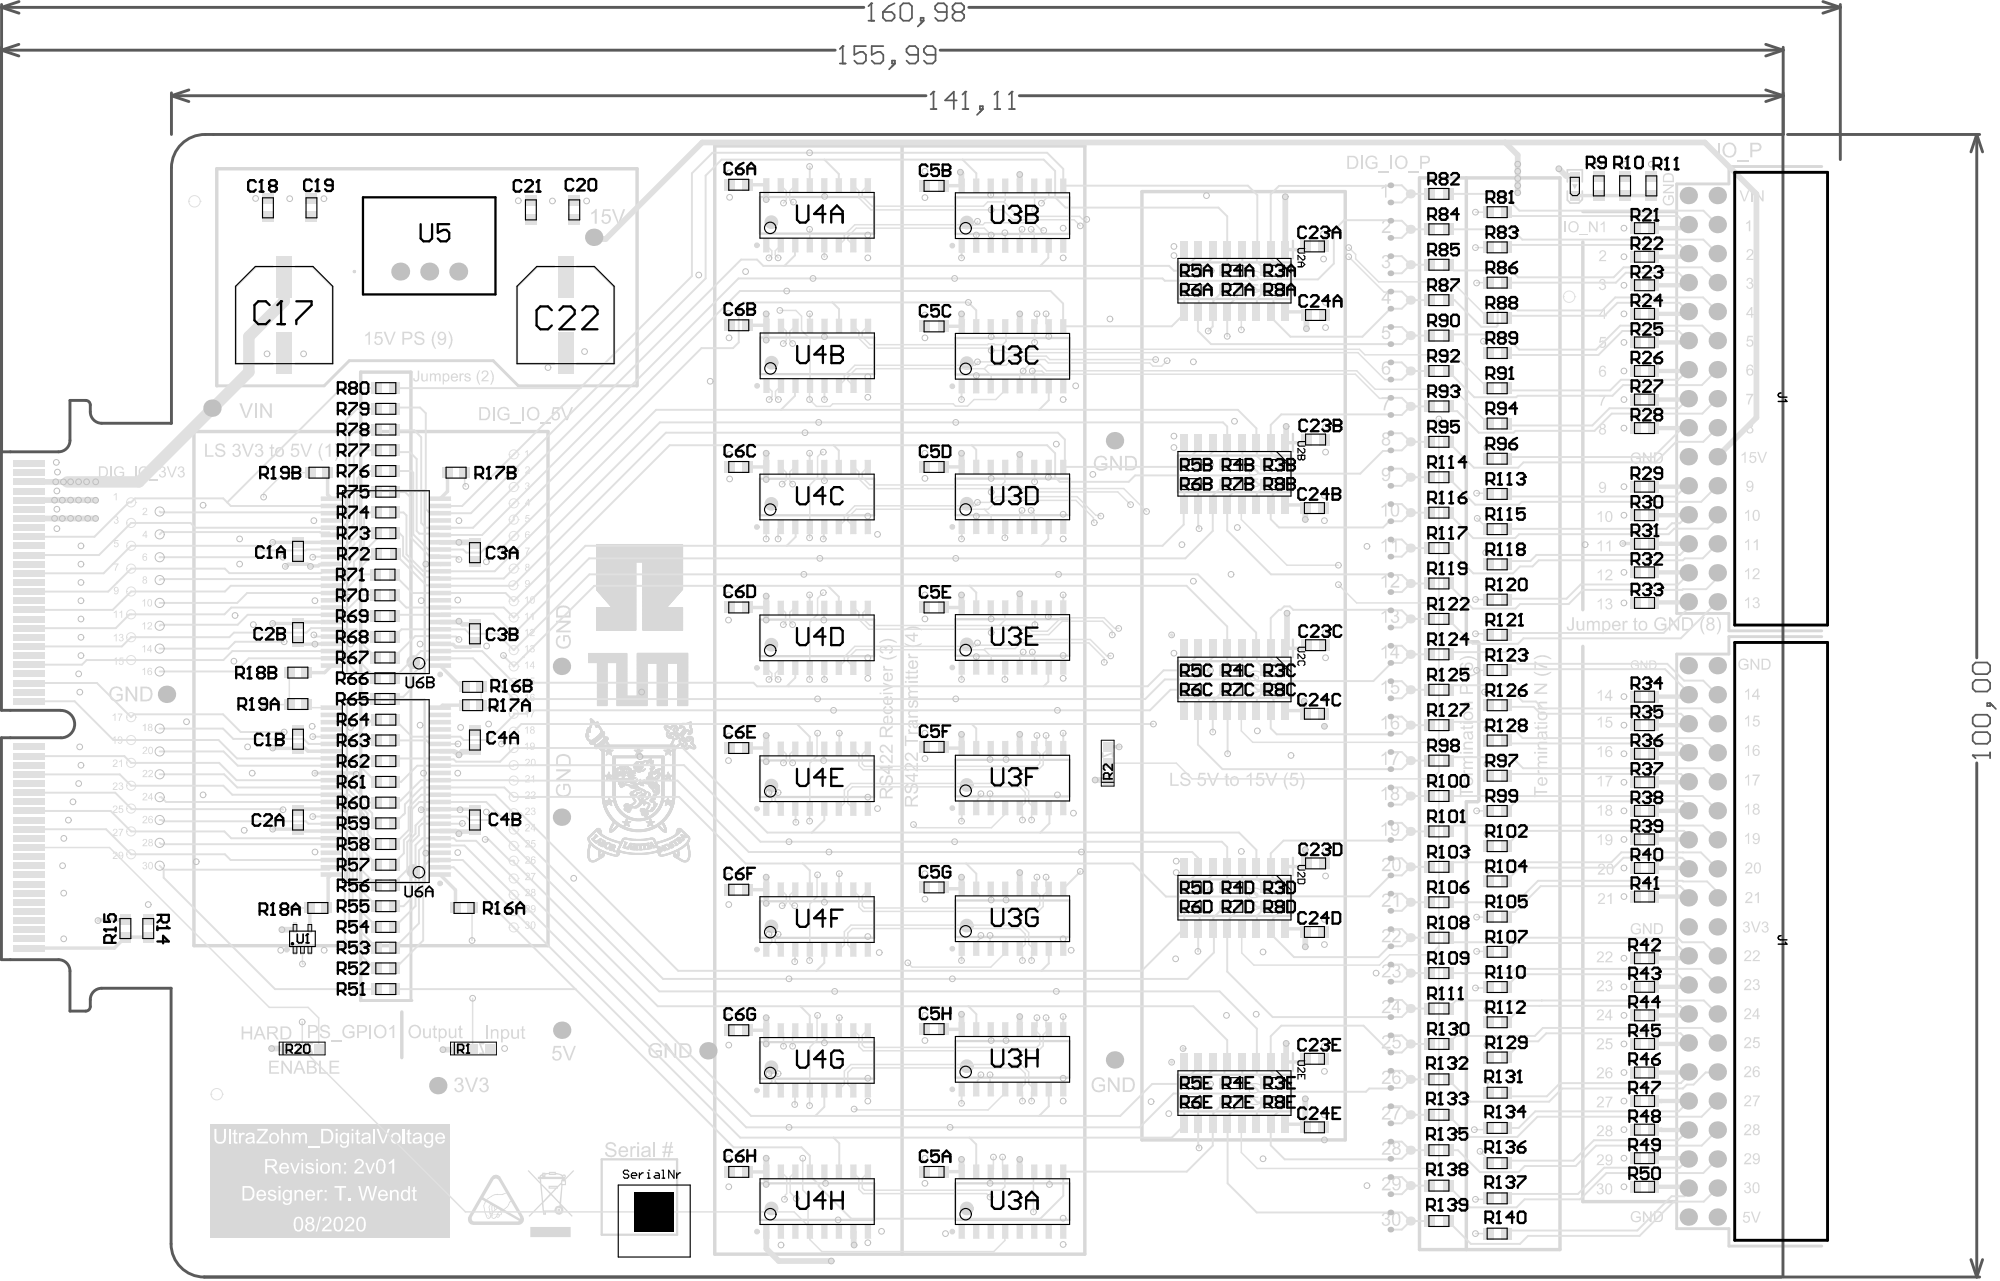
[picture p49: page 1]
