ultrazohm/uz_d_voltage/Project Outputs for UZ_D_Voltage/2v01/ASM/ASM_UltraZohm_DigitalVoltage_RS422_to_3V3_input.PDF

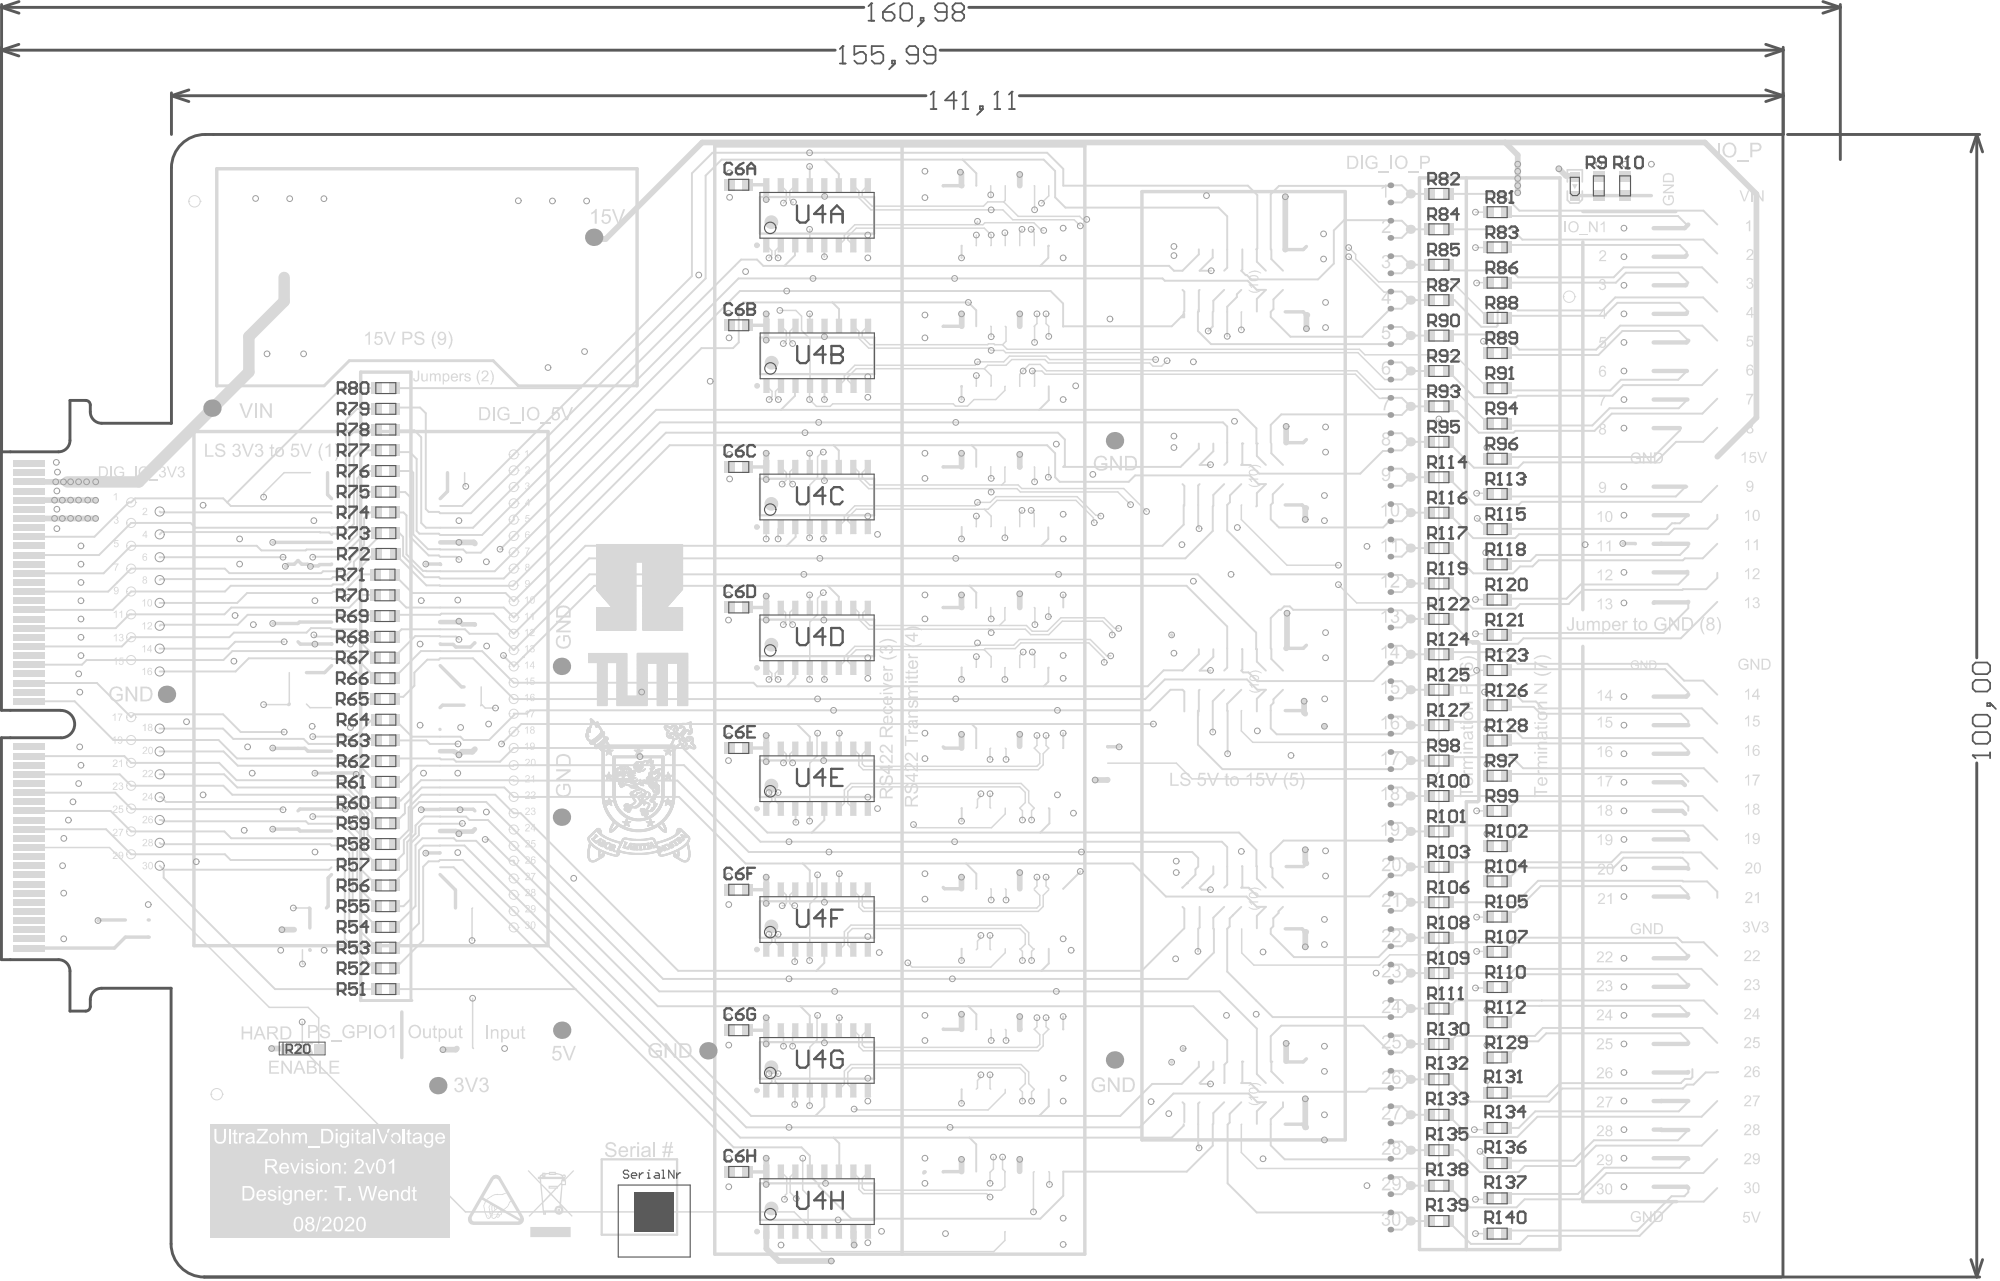
[picture p50: page 1]
