ultrazohm/uz_d_voltage/(list of files, drawings)

Other design files:
3V3_to_5V.SchDoc
5V_to_15V.SchDoc
15V_PowerSupply.SchDoc
DifferentialToSingle.SchDoc
DigitalCarrierPlug.SchDoc
Jumper5VLS.SchDoc
NetTieSingleAndDiff.SchDoc
ONSEMI_MC14504BDR2G.SchDoc
SignalBundling.SchDoc
SignalConditioning.SchDoc
SingleToDifferential.SchDoc
Snubber5VLS.SchDoc
TermSingleAndDiff.SchDoc
TI_DS26C31T.SchDoc
TI_DS26C32AT.SchDoc
TI_SN74LVCH16T245.SchDoc
TopSheet.SchDoc
ultrazohm_digital_voltage_3U_1vxx.PcbDoc
UZ_D_Voltage.PrjPCB
