ultrazohm/uz_d_voltage/(commit log)

2019-11-11 First Initialization by Thilo
    [BOM_Eurocard_2v01.xls, BOM_Eurocard_2v01.xlsx, CarrierConnector.SchDoc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]
2019-12-04 Created greenfield
    [TopSheet.SchDoc, ultrazohm_digital_voltage_3U_1vxx.PcbDoc, ultrazohm_digital_voltage_3U_1vxx.PrjPCB]
2019-12-04 Renamed Top Sheet
    [DigitalVoltage_TopSheet.SchDoc]
2019-12-04 added top sheets
    [Differential.SchDoc, DigitalVoltage_CarrierConnector.SchDoc, DigitalVoltage_OutputPlug.SchDoc, DigitalVoltage_PowerSupply.SchDoc, DigitalVoltage_SignalConditioning.SchDoc, DigitalVoltage_TopSheet.SchDoc, LevelShifter3_3-5.SchDoc, LevelShifter5-15.SchDoc]
2019-12-04 Worked on top level connections
    [DigitalVoltage_PowerSupply.SchDoc, DigitalVoltage_TopSheet.SchDoc, ultrazohm_digital_voltage_3U_1vxx.PrjPCB]
2019-12-11 Restructured Design
    [BOM_Eurocard_2v01.xls, BOM_Eurocard_2v01.xlsx, CarrierConnector.SchDoc, DigitalVoltage_CarrierConnector.SchDoc, DigitalVoltage_OutputPlug.SchDoc, DigitalVoltage_PowerSupply.SchDoc, DigitalVoltage_TopSheet.SchDoc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]
2019-12-13 Added RECOM DCDC converter
    [RECOM_R-78C15-1.0_1A_42V_to_15V.SchDoc, TopSheet.SchDoc]
2019-12-13 Added signal conditioning sheet and TI Level shifter device sheet
    [SignalConditioning.SchDoc, TopSheet.SchDoc, ultrazohm_digital_voltage_3U_1vxx.PcbDoc, ultrazohm_digital_voltage_3U_1vxx.PrjPCB]
2019-12-13 Tried to include repeat function. does not work yet
    [SignalConditioning.SchDoc, TopSheet.SchDoc, ultrazohm_digital_voltage_3U_1vxx.PcbDoc]
2019-12-15 Added 3V3 level shifters
    [3V3_to_5V.SchDoc, 5V_to_15V.SchDoc, SignalConditioning.SchDoc, TopSheet.SchDoc, single_to_differential.SchDoc, ultrazohm_digital_voltage_3U_1vxx.PcbDoc, ultrazohm_digital_voltage_3U_1vxx.PrjPCB]
2019-12-15 Connected 3V3 to 5V Level Shifter with 5V to 15V level shifter
    [3V3_to_5V.SchDoc, 5V_to_15V.SchDoc, ONSEMI_MC14504BDR2G.SchDoc, SignalConditioning.SchDoc, ultrazohm_digital_voltage_3U_1vxx.PcbDoc, ultrazohm_digital_voltage_3U_1vxx.PrjPCB]
2019-12-16 Added all main components no layout yet
    [3V3_to_5V.SchDoc, 5V_to_15V.SchDoc, ONSEMI_MC14504BDR2G.SchDoc, SignalConditioning.SchDoc, TI_DS26C31T.SchDoc, TopSheet.SchDoc, single_to_differential.SchDoc, ultrazohm_digital_voltage_3U_1vxx.PcbDoc]
2019-12-16 Placed 5V and 15V level shifter
    [3V3_to_5V.SchDoc, SignalConditioning.SchDoc, ultrazohm_digital_voltage_3U_1vxx.PcbDoc]
2019-12-16 Placed RS422 Transmitter
    [TI_DS26C31T.SchDoc, single_to_differential.SchDoc, ultrazohm_digital_voltage_3U_1vxx.PcbDoc, ultrazohm_digital_voltage_3U_1vxx.PrjPCB]
2019-12-16 repositioned level shifter 5V to center of circuit
    [ultrazohm_digital_voltage_3U_1vxx.PcbDoc]
2020-01-03 Added RS422 receiver and removed individual blocking capacitors
    [SignalConditioning.SchDoc, TI_DS26C31T.SchDoc, TI_DS26C32AT.SchDoc, TopSheet.SchDoc, blocking.SchDoc, differential_to_single.SchDoc, ultrazohm_digital_voltage_3U_1vxx.PcbDoc, ultrazohm_digital_voltage_3U_1vxx.PrjPCB]
2020-01-03 Added serial termination to RS422 interface
    [ONSEMI_MC14504BDR2G.SchDoc, OutputJack.SchDoc, SignalConditioning.SchDoc, TI_DS26C31T.SchDoc, single_to_differential.SchDoc, ultrazohm_digital_voltage_3U_1vxx.PrjPCB]
2020-01-04 Added Termination sheets and termination resistors to 5V signals
    [3V3_to_5V.SchDoc, 5V_to_15V.SchDoc, ONSEMI_MC14504BDR2G.SchDoc, OutputJack.SchDoc, SignalBundling.SchDoc, SignalConditioning.SchDoc, TI_DS26C31T.SchDoc, TI_DS26C32AT.SchDoc]
2020-01-04 Added Termination to 3V3 signals
    [Termination3V3.SchDoc, ultrazohm_digital_voltage_3U_1vxx.PrjPCB]
2020-01-04 Tied differential pair positiv and 15V signals together
    [TerminationDifferential.SchDoc, ultrazohm_digital_voltage_3U_1vxx.PrjPCB]
2020-01-04 Finished termination
    [NetTie15VAndDiff.SchDoc, SignalBundling.SchDoc, Termination15V+Differential.SchDoc, ultrazohm_digital_voltage_3U_1vxx.PrjPCB]
2020-01-04 Connect all signals to output jack
    [OutputJack.SchDoc, SignalConditioning.SchDoc, Termination3V3.SchDoc, TopSheet.SchDoc, differential_to_single.SchDoc, ultrazohm_digital_voltage_3U_1vxx.PrjPCB]
2020-01-04 corrected errors from project compilation
    [5V_to_15V.SchDoc, NetTie15VAndDiff.SchDoc, OutputJack.SchDoc, TI_DS26C31T.SchDoc, TI_DS26C32AT.SchDoc, Termination15V+Differential.SchDoc, differential_to_single.SchDoc, single_to_differential.SchDoc]
2020-01-04 Reannotated components and put output jack in position
    [3V3_to_5V.SchDoc, 5V_to_15V.SchDoc, NetTie15VAndDiff.SchDoc, ONSEMI_MC14504BDR2G.SchDoc, OutputJack.SchDoc, SignalConditioning.SchDoc, TI_DS26C31T.SchDoc, TI_DS26C32AT.SchDoc]
2020-01-04 Swapped pins of resistor arrays
    [OutputJack.SchDoc, TI_DS26C31T.SchDoc, TI_DS26C32AT.SchDoc, Termination5V.SchDoc, ultrazohm_digital_voltage_3U_1vxx.PcbDoc, ultrazohm_digital_voltage_3U_1vxx.PrjPCB]
2020-01-04 Placed termination resistor arrays
    [ultrazohm_digital_voltage_3U_1vxx.PcbDoc]
2020-01-04 Placed net ties
    [OutputJack.SchDoc, Termination15V+Differential.SchDoc, Termination3V3.SchDoc, ultrazohm_digital_voltage_3U_1vxx.PcbDoc]
2020-01-04 Changed Pin configuration of termination arrays and positioned them
    [Termination15V+Differential.SchDoc, ultrazohm_digital_voltage_3U_1vxx.PcbDoc]
2020-01-05 Placed Vias for 3V3 TPs and connected 3V3 Level Shifter
    [ONSEMI_MC14504BDR2G.SchDoc, OutputJack.SchDoc, TopSheet.SchDoc, ultrazohm_digital_voltage_3U_1vxx.PcbDoc, ultrazohm_digital_voltage_3U_1vxx.PrjPCB]
2020-01-05 Connected RS422 Receiver to IO Plug
    [TopSheet.SchDoc, ultrazohm_digital_voltage_3U_1vxx.PcbDoc]
2020-01-05 Appropriate Spacing for wires to RS422 receivers
    [ultrazohm_digital_voltage_3U_1vxx.PcbDoc]
2020-01-05 Nearly connected all 3V3 termination resistor arrays
    [ultrazohm_digital_voltage_3U_1vxx.PcbDoc]
2020-01-05 Started restructuring
    [3V3_to_5V.SchDoc, 5V_to_15V.SchDoc, Digital_CarrierPlug.SchDoc, Jumper5VLS.SchDoc, NetTie15VAndDiff.SchDoc, ONSEMI_MC14504BDR2G.SchDoc, OutputJack.SchDoc, RECOM_R-78C15-1.0_1A_42V_to_15V.SchDoc]
2020-01-05 Added Jumper to 3V3 to 5V LS
    [SignalConditioning.SchDoc, single_to_differential.SchDoc, ultrazohm_digital_voltage_3U_1vxx.PcbDoc]
2020-01-05 Connected 5V LS Jumper and positioned 15V LS Jumper
    [Jumper5VLS.SchDoc, ONSEMI_MC14504BDR2G.SchDoc, SignalBundling.SchDoc, SignalConditioning.SchDoc, TI_DS26C31T.SchDoc, TI_DS26C32AT.SchDoc, differential_to_single.SchDoc, ultrazohm_digital_voltage_3U_1vxx.PcbDoc]
2020-01-05 Placed vias at LS5V
    [ultrazohm_digital_voltage_3U_1vxx.PcbDoc]
2020-01-06 Swapped pins at RS422 receivers
    [OutputJack.SchDoc, SignalConditioning.SchDoc, ultrazohm_digital_voltage_3U_1vxx.PcbDoc]
2020-01-06 swapped RS422 transmitter
    [TI_DS26C32AT.SchDoc, ultrazohm_digital_voltage_3U_1vxx.PcbDoc]
2020-01-06 Merged pin swap of RS422 receiver to schematic
    [OutputJack.SchDoc, SignalConditioning.SchDoc, TI_DS26C31T.SchDoc, TI_DS26C32AT.SchDoc, differential_to_single.SchDoc, single_to_differential.SchDoc, ultrazohm_digital_voltage_3U_1vxx.PcbDoc, ultrazohm_digital_voltage_3U_1vxx.PrjPCB]
2020-01-06 Merged swapping of RS422 receivers to schematic
    [single_to_differential.SchDoc, ultrazohm_digital_voltage_3U_1vxx.PcbDoc]
2020-01-06 Fanout RS422 Receiver outputs
    [OutputJack.SchDoc, differential_to_single.SchDoc, single_to_differential.SchDoc, ultrazohm_digital_voltage_3U_1vxx.PcbDoc, ultrazohm_digital_voltage_3U_1vxx.PrjPCB]
2020-01-06 Connected RS422 Receiver outputs and transmitter inputs
    [ultrazohm_digital_voltage_3U_1vxx.PcbDoc]
2020-01-06 Connected RS422 transmitter and receiver single ended pins
    [ultrazohm_digital_voltage_3U_1vxx.PcbDoc]
2020-01-06 Swapped 15VLS Pins and positioned and wired Jumper
    [5V_to_15V.SchDoc, ultrazohm_digital_voltage_3U_1vxx.PcbDoc]
2020-01-06 Connected 15V LS
    [ultrazohm_digital_voltage_3U_1vxx.PcbDoc]
2020-01-06 Routed unterminated merged signals (15V and DIFF_P)
    [NetTie15VAndDiff.SchDoc, differential_to_single.SchDoc, single_to_differential.SchDoc, ultrazohm_digital_voltage_3U_1vxx.PcbDoc]
2020-01-06 Routed Differential pairs between RS422 transmitter and receiver
    [ultrazohm_digital_voltage_3U_1vxx.PcbDoc, ultrazohm_digital_voltage_3U_1vxx.PrjPCB]
2020-01-06 Connected RS422 transmitter and receiver with termination
    [ultrazohm_digital_voltage_3U_1vxx.PcbDoc]
2020-01-06 half way of connecting output jack
    [OutputJack.SchDoc, ultrazohm_digital_voltage_3U_1vxx.PcbDoc]
2020-01-06 All signals connected
    [ultrazohm_digital_voltage_3U_1vxx.PcbDoc]
2020-01-06 placed some polygons
    [ultrazohm_digital_voltage_3U_1vxx.PcbDoc]
2020-01-06 Replaced all missing vias
    [ultrazohm_digital_voltage_3U_1vxx.PcbDoc, ultrazohm_digital_voltage_3U_1vxx.PrjPCB]
2020-01-07 Placed LEDs
    [LEDs.SchDoc, NetTie15VAndDiff.SchDoc, OutputJack.SchDoc, Termination15V+Differential.SchDoc, TopSheet.SchDoc, ultrazohm_digital_voltage_3U_1vxx.PcbDoc]
2020-01-07 placed 5v0 and 3v3 polygons
    [ultrazohm_digital_voltage_3U_1vxx.PcbDoc]
2020-01-07 Placed power polygons on bottom layer
    [ultrazohm_digital_voltage_3U_1vxx.PcbDoc]
2020-01-07 Placed blocking capacitors
    [TopSheet.SchDoc, blocking.SchDoc, ultrazohm_digital_voltage_3U_1vxx.PcbDoc]
2020-01-07 Placed all missing signal vias
    [ultrazohm_digital_voltage_3U_1vxx.PcbDoc]
2020-01-07 Freed power pins
    [ultrazohm_digital_voltage_3U_1vxx.PcbDoc, ultrazohm_digital_voltage_3U_1vxx.PrjPCB]
2020-01-07 Placed all power planes
2020-01-07 Connected all power pins
2020-01-07 Connected all power nets
    [OutputJack.SchDoc]
2020-01-08 Finished routing and via stitching and tenting
    [NetTie15VAndDiff.SchDoc]
2020-01-08 Placed designators
    [Termination15V+Differential.SchDoc, ultrazohm_digital_voltage_3U_1vxx.PrjPCB]
2020-01-08 Placed ground header pins
    [GroundPins.SchDoc, TopSheet.SchDoc, ultrazohm_digital_voltage_3U_1vxx.PrjPCB]
2020-01-08 Added Logos and project infos
    [GroundPins.SchDoc, TopSheet.SchDoc, ultrazohm_digital_voltage_3U_1vxx.PrjPCB]
2020-01-08 Added missing components to design variants
    [ultrazohm_digital_voltage_3U_1vxx.PrjPCB]
2020-01-08 Added LEDs to Variants and color explanation on the rear side
2020-01-13 Changed mistake in carrier plug and updated schematic sheet templates
    [3V3_to_5V.SchDoc, 5V_to_15V.SchDoc, Digital_CarrierPlug.SchDoc, GroundPins.SchDoc, Jumper5VLS.SchDoc, LEDs.SchDoc, NetTie15VAndDiff.SchDoc, ONSEMI_MC14504BDR2G.SchDoc]
2020-01-13 Moved circuits for LEDs blocking and GND and power supply pins together
    [SignalBundling.SchDoc, SignalConditioning.SchDoc, TopSheet.SchDoc, blocking.SchDoc]
2020-01-13 Renamed Sheets
    [3V3_to_5V.SchDoc, 5V_to_15V.SchDoc, DifferentialToSingle.SchDoc, DigitalCarrierPlug.SchDoc, Jumper5VLS.SchDoc, NetTieSingleAndDiff.SchDoc, ONSEMI_MC14504BDR2G.SchDoc, PowerPinsBlockingLED.SchDoc]
2020-01-13 Added Numbers output pins
    [DifferentialToSingle.SchDoc, NetTieSingleAndDiff.SchDoc, SignalBundling.SchDoc, SignalConditioning.SchDoc, SingleToDifferential.SchDoc]
2020-01-13 Added new designators to R's and C's
    [Jumper5VLS.SchDoc, SignalConditioning.SchDoc, TermSingleAndDiff.SchDoc]
2020-01-13 Forgot to save when doing last commit
    [DigitalCarrierPlug.SchDoc, ONSEMI_MC14504BDR2G.SchDoc, PowerPinsBlockingLED.SchDoc, RECOM_R-78C15-1.0_1A_42V_to_15V.SchDoc, SignalBundling.SchDoc, TI_SN74LVCH16T245.SchDoc, ultrazohm_digital_voltage_3U_1vxx.PrjPCB]
2020-01-13 Added supplier links
    [3V3_to_5V.SchDoc, 5V_to_15V.SchDoc, DigitalCarrierPlug.SchDoc, Jumper5VLS.SchDoc, NetTieSingleAndDiff.SchDoc, ONSEMI_MC14504BDR2G.SchDoc, PowerPinsBlockingLED.SchDoc, RECOM_R-78C15-1.0_1A_42V_to_15V.SchDoc]
2020-01-13 Updated footprints of Capacitors on the 15V Power Supply and changed comments of capacitors and resistors
    [3V3_to_5V.SchDoc, 5V_to_15V.SchDoc, DigitalCarrierPlug.SchDoc, Jumper5VLS.SchDoc, NetTieSingleAndDiff.SchDoc, ONSEMI_MC14504BDR2G.SchDoc, PowerPinsBlockingLED.SchDoc, RECOM_R-78C15-1.0_1A_42V_to_15V.SchDoc]
2020-01-13 Finished BOM
    [3V3_to_5V.SchDoc, 5V_to_15V.SchDoc, DigitalCarrierPlug.SchDoc, Jumper5VLS.SchDoc, ONSEMI_MC14504BDR2G.SchDoc, PowerPinsBlockingLED.SchDoc, RECOM_R-78C15-1.0_1A_42V_to_15V.SchDoc, SignalBundling.SchDoc]
2020-01-13 Reseted all designators and synchronized schematic designators with PCB designators
    [3V3_to_5V.SchDoc, 5V_to_15V.SchDoc, DigitalCarrierPlug.SchDoc, Jumper5VLS.SchDoc, NetTieSingleAndDiff.SchDoc, ONSEMI_MC14504BDR2G.SchDoc, PowerPinsBlockingLED.SchDoc, RECOM_R-78C15-1.0_1A_42V_to_15V.SchDoc]
2020-01-13 Fixed R12 in design variants and designators at PS2
    [ultrazohm_digital_voltage_3U_1vxx.PrjPCB]
2020-01-15 Repositioned output jack
    [DigitalCarrierPlug.SchDoc]
2020-01-15 Generated gerber files
    [ultrazohm_digital_voltage_3U_1vxx.GBL, ultrazohm_digital_voltage_3U_1vxx.GBO, ultrazohm_digital_voltage_3U_1vxx.GBP, ultrazohm_digital_voltage_3U_1vxx.GBS, ultrazohm_digital_voltage_3U_1vxx.GTL, ultrazohm_digital_voltage_3U_1vxx.GTO, ultrazohm_digital_voltage_3U_1vxx.GTP, ultrazohm_digital_voltage_3U_1vxx.GTS]
2020-01-17 Added date and changed vias to pads near carrier connector
    [TopSheet.SchDoc, ultrazohm_digital_voltage_3U_1vxx.PrjPCB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]
2020-01-17 Generated Gerber files and optimized power planes
    [TopSheet.SchDoc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]
2020-01-17 Added serial number
    [TopSheet.SchDoc, ultrazohm_digital_voltage_3U_1vxx.PrjPCB]
2020-01-17 Generated new gerber files
    [ultrazohm_digital_voltage_3U_1vxx.PrjPCB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]
2020-01-18 Modified mechanical layers and added mechanical 1 to output job
    [ONSEMI_MC14504BDR2G.SchDoc, SignalBundling.SchDoc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]
2020-01-20 Added fiducial markers
    [ultrazohm_digital_voltage_3U_1vxx.PrjPCB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]
2020-01-20 Generated new gerber files with fiducials
    [ultrazohm_digital_voltage_3U_1vxx.GBL, ultrazohm_digital_voltage_3U_1vxx.GBO, ultrazohm_digital_voltage_3U_1vxx.GBP, ultrazohm_digital_voltage_3U_1vxx.GBS, ultrazohm_digital_voltage_3U_1vxx.GM1, ultrazohm_digital_voltage_3U_1vxx.GTL, ultrazohm_digital_voltage_3U_1vxx.GTO, ultrazohm_digital_voltage_3U_1vxx.GTP]
2020-01-26 15V LS pads are missing
    [ultrazohm_digital_voltage_3U_1vxx.PrjPCB]
2020-01-26 Fixed missing pads at 15V LS
2020-02-18 Removed jumper to GND from differential assembly variants
    [TopSheet.SchDoc, ultrazohm_digital_voltage_3U_1vxx.PrjPCB]
2020-02-18 removed Histroy and __Previews from git tracking
    [3V3_to_15V.xls, 3V3_to_5V.xls, 3V3_to_diff.xls, Differential.SchDoc, DigitalVoltage_SignalConditioning.SchDoc, DigitalVoltage_TopSheet.SchDoc, Digital_CarrierPlug.SchDoc, GroundPins.SchDoc]
2020-02-22 Renamed DIG_O_15V to DIG_IO_SINGLE
    [5V_to_15V.SchDoc, NetTieSingleAndDiff.SchDoc, SignalBundling.SchDoc, SignalConditioning.SchDoc]
2020-04-22 Refactored design: Replaced power system with global power symbols checked errors and warnings and added exception directives
    [15V_PowerSupply.SchDoc, 3V3_to_5V.SchDoc, 5V_to_15V.SchDoc, DifferentialToSingle.SchDoc, DigitalCarrierPlug.SchDoc, NetTieSingleAndDiff.SchDoc, ONSEMI_MC14504BDR2G.SchDoc, PowerPinsBlockingLED.SchDoc]
2020-04-22 added component class definitions to schematic
    [3V3_to_5V.SchDoc, 5V_to_15V.SchDoc, DigitalCarrierPlug.SchDoc, TI_DS26C31T.SchDoc, TI_DS26C32AT.SchDoc, TI_SN74LVCH16T245.SchDoc, TopSheet.SchDoc, ultrazohm_digital_voltage_3U_1vxx.PrjPCB]
2020-07-31 Started to perform controlled impedance and fixed #2
    Fixup to previous commit: started unrouting overlapping single ended signals and fixed #15
    [15V_PowerSupply.SchDoc, 5V_to_15V.SchDoc, PowerPinsBlockingLED.SchDoc, SingleToDifferential.SchDoc, TI_DS26C31T.SchDoc, TI_DS26C32AT.SchDoc, TI_SN74LVCH16T245.SchDoc, TermSingleAndDiff.SchDoc]
2020-07-31 Swapped input pins of RS422 receiver. Fixed #12
    [DifferentialToSingle.SchDoc]
2020-07-31 Replaced group bypassing with IC specific bypassing. Fixes #14
    [ONSEMI_MC14504BDR2G.SchDoc, PowerPinsBlockingLED.SchDoc, TI_DS26C31T.SchDoc, TI_DS26C32AT.SchDoc, TI_SN74LVCH16T245.SchDoc, ultrazohm_digital_voltage_3U_1vxx.PrjPCB]
2020-07-31 Optimized single ended signals until 15V level shifter
    [3V3_to_5V.SchDoc, 5V_to_15V.SchDoc, TopSheet.SchDoc]
2020-07-31 Connected RS422 driver outputs and receiver inputs with each other
2020-07-31 Placed and routed jumpers for 5V LS
    [DigitalCarrierPlug.SchDoc, Jumper5VLS.SchDoc, PowerPinsBlockingLED.SchDoc, SignalBundling.SchDoc, TI_SN74LVCH16T245.SchDoc, TermSingleAndDiff.SchDoc, TopSheet.SchDoc, ultrazohm_digital_voltage_3U_1vxx.PrjPCB]
2020-07-31 Placed termination resistors and jumpers to ground.
    Instead of resistor array discrete resisitors are used now. Fixes #4
2020-07-31 Finished signal routing from RS422 interface to termination resistors
    [NetTieSingleAndDiff.SchDoc, TermSingleAndDiff.SchDoc, ultrazohm_digital_voltage_3U_1vxx.PrjPCB]
2020-07-31 Finished Signal routing.
    Single ended signals are now optimized to 50ohm whereas differential
    signals are now 100ohm. Fixes #6
    [NetTieSingleAndDiff.SchDoc]
2020-07-31 Connected enable and mode signals
    [NetTieSingleAndDiff.SchDoc, TopSheet.SchDoc, ultrazohm_digital_voltage_3U_1vxx.PrjPCB]
2020-07-31 Checked BOM and assigned ordering numbers and finished top overlay
    [15V_PowerSupply.SchDoc, 3V3_to_5V.SchDoc, 5V_to_15V.SchDoc, DigitalCarrierPlug.SchDoc, Jumper5VLS.SchDoc, ONSEMI_MC14504BDR2G.SchDoc, SignalBundling.SchDoc, TI_DS26C31T.SchDoc]
2020-07-31 Added probe pins for GND and different VCC levels
    [TopSheet.SchDoc, ultrazohm_digital_voltage_3U_1vxx.PrjPCB]
2020-07-31 Finished overlays and consolidated BOM (only 5k6 resistors in use). Fixes #8
    [3V3_to_5V.SchDoc, 5V_to_15V.SchDoc, TI_SN74LVCH16T245.SchDoc, TopSheet.SchDoc]
2020-07-31 Review by sebastian and thilo: Finished top overlay and fixed several details in the schematic
    [TI_DS26C31T.SchDoc, TI_DS26C32AT.SchDoc, TI_SN74LVCH16T245.SchDoc, TermSingleAndDiff.SchDoc, TopSheet.SchDoc]
2020-07-31 Finished assembly drawing
    [TI_DS26C31T.SchDoc, TI_DS26C32AT.SchDoc, ultrazohm_digital_voltage_3U_1vxx.PrjPCB]
2020-07-31 added output jobs and removed and reordered several files that are not needed anymore
    [3V3_to_15V.xls, 3V3_to_5V.xls, 3V3_to_diff.xls, NetTie15VAndDiff.SchDoc, PowerPinsBlockingLED.SchDoc, RECOM_R-78C15-1.0_1A_42V_to_15V.SchDoc, Termination15V+Differential.SchDoc, diff_to_3V3.xls]
2020-08-03 Placed fiducials
    [DigitalCarrierPlug.SchDoc, ultrazohm_digital_voltage_3U_1vxx.PrjPCB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]
2020-08-03 Removed solder paster from pads and reworked some connections
    [ultrazohm_digital_voltage_3U_1vxx.GBL, ultrazohm_digital_voltage_3U_1vxx.GBO, ultrazohm_digital_voltage_3U_1vxx.GTL, ultrazohm_digital_voltage_3U_1vxx.GTO]
2020-08-03 Reworked design variants
    [TermSingleAndDiff.SchDoc, ultrazohm_digital_voltage_3U_1vxx.PrjPCB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]
2020-08-03 Added assembly drawings to output job
    [ultrazohm_digital_voltage_3U_1vxx.PrjPCB]
2020-08-03 Optimzed ground planes (vias to avoid dead copper) finished output job and generated manufaturing and assembly data.
    [3V3_to_5V.SchDoc, BOM_UltraZohm_DigitalVoltage_3V3_to_15V_output.xls, BOM_UltraZohm_DigitalVoltage_3V3_to_3V3_IO.xls, BOM_UltraZohm_DigitalVoltage_3V3_to_5V_IO.xls, BOM_UltraZohm_DigitalVoltage_3V3_to_RS422_output.xls, BOM_UltraZohm_DigitalVoltage_RS422_to_3V3_input.xls, DigitalCarrierPlug.SchDoc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]
2020-08-03 updated schematic templates fixed an error in the 5V and 15V variant and regenrated ASM and BOM
    [15V_PowerSupply.SchDoc, 3V3_to_5V.SchDoc, 5V_to_15V.SchDoc, BOM_UltraZohm_DigitalVoltage_3V3_to_15V_output.xls, BOM_UltraZohm_DigitalVoltage_3V3_to_3V3_IO.xls, BOM_UltraZohm_DigitalVoltage_3V3_to_5V_IO.xls, BOM_UltraZohm_DigitalVoltage_3V3_to_RS422_output.xls, BOM_UltraZohm_DigitalVoltage_RS422_to_3V3_input.xls]
2020-08-05 opened pads for D1 on stencil
    [ultrazohm_digital_voltage_3U_1vxx.PrjPCB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]
2020-08-06 Removed old resistor definitions from project and regnerated BOM
    [15V_PowerSupply.SchDoc, 3V3_to_5V.SchDoc, 5V_to_15V.SchDoc, BOM_UltraZohm_DigitalVoltage_3V3_to_15V_output.xls, BOM_UltraZohm_DigitalVoltage_3V3_to_3V3_IO.xls, BOM_UltraZohm_DigitalVoltage_3V3_to_5V_IO.xls, BOM_UltraZohm_DigitalVoltage_3V3_to_RS422_output.xls, BOM_UltraZohm_DigitalVoltage_RS422_to_3V3_input.xls]
2020-08-14 Modified Pick and Place Generation and accidently regnerated BOM.
    [BOM_UltraZohm_DigitalVoltage_3V3_to_15V_output.xls, BOM_UltraZohm_DigitalVoltage_3V3_to_3V3_IO.xls, BOM_UltraZohm_DigitalVoltage_3V3_to_5V_IO.xls, BOM_UltraZohm_DigitalVoltage_3V3_to_RS422_output.xls, BOM_UltraZohm_DigitalVoltage_RS422_to_3V3_input.xls]
2020-08-18 Modified values for termination resistors to 47 Ohm differential and 91 Ohm single ended and regnerated pick and place and BOM
    [BOM_UltraZohm_DigitalVoltage_3V3_to_15V_output.xls, BOM_UltraZohm_DigitalVoltage_3V3_to_3V3_IO.xls, BOM_UltraZohm_DigitalVoltage_3V3_to_5V_IO.xls, BOM_UltraZohm_DigitalVoltage_3V3_to_RS422_output.xls, BOM_UltraZohm_DigitalVoltage_RS422_to_3V3_input.xls, PAP_UltraZohm_DigitalVoltage_3V3_to_RS422_output.xls, PAP_UltraZohm_DigitalVoltage_RS422_to_3V3_input.xls, TermSingleAndDiff.SchDoc]
2021-02-12 Started migrating project to dblib using the "altium_user" user (read only access). Replaced the ipl1 connector with a version with a 3D model. the migration is not finished yet the project MUST NOT 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
    [15V_PowerSupply.SchDoc, 3V3_to_5V.SchDoc, Jumper5VLS.SchDoc, ONSEMI_MC14504BDR2G.SchDoc, SignalBundling.SchDoc, TI_DS26C31T.SchDoc, TI_DS26C32AT.SchDoc, TI_SN74LVCH16T245.SchDoc]
2021-03-01 Adapted project to new library and started redesign for V3
    [15V_PowerSupply.SchDoc, 3V3_to_5V.SchDoc, 5V_to_15V.SchDoc, DigitalCarrierPlug.SchDoc, NetTieSingleAndDiff.SchDoc, TI_DS26C31T.SchDoc, TI_DS26C32AT.SchDoc, TI_SN74LVCH16T245.SchDoc]
2021-03-01 Added damping resistors
    [3V3_to_5V.SchDoc, Damper5VLS.SchDoc, Jumper5VLS.SchDoc, TI_SN74LVCH16T245.SchDoc, ultrazohm_digital_voltage_3U_1vxx.PrjPCB]
2021-03-02 Changed Pin of X3 to VIN. Fixes #26
    [SignalBundling.SchDoc]
2021-03-02 Reduced clearance around net tie pads so that there is a solid ground return path now. fixes #19
2021-03-02 Removed stub at C24C. Solid ground connection is now established also to the second via. Fixes #16
2021-03-02 Rerouted new level translator 5V package and put in snubber resistors behind it. Fixes #22
    [3V3_to_5V.SchDoc, 5V_to_15V.SchDoc, Damper5VLS.SchDoc, DifferentialToSingle.SchDoc, DigitalCarrierPlug.SchDoc, Jumper5VLS.SchDoc, SignalConditioning.SchDoc, SingleToDifferential.SchDoc]
2021-03-02 Updated certain resistors with a new package that has no top overlay marking.
    [3V3_to_5V.SchDoc, 5V_to_15V.SchDoc, DigitalCarrierPlug.SchDoc, Jumper5VLS.SchDoc, ONSEMI_MC14504BDR2G.SchDoc, SignalBundling.SchDoc, Snubber5VLS.SchDoc, TI_SN74LVCH16T245.SchDoc]
2021-03-02 Added dip switch for direction control and updated date and revision counter. Fixes #27
    [3V3_to_5V.SchDoc, TopSheet.SchDoc, ultrazohm_digital_voltage_3U_1vxx.PrjPCB]
2021-03-04 updated component parameters. LCSC part number is now available for the components.
    [15V_PowerSupply.SchDoc, 3V3_to_5V.SchDoc, 5V_to_15V.SchDoc, DigitalCarrierPlug.SchDoc, Jumper5VLS.SchDoc, ONSEMI_MC14504BDR2G.SchDoc, SignalBundling.SchDoc, Snubber5VLS.SchDoc]
2021-03-04 resolved compilation errors
    [3V3_to_5V.SchDoc, DifferentialToSingle.SchDoc, SignalBundling.SchDoc, TI_SN74LVCH16T245.SchDoc, TermSingleAndDiff.SchDoc]
2021-03-05 Configured assembly variants.
    [5V_to_15V.SchDoc, SignalBundling.SchDoc, TI_DS26C32AT.SchDoc, TermSingleAndDiff.SchDoc, TopSheet.SchDoc, ultrazohm_digital_voltage_3U_1vxx.PrjPCB]
2021-03-05 Edited mechanical layers.
    [3V3_to_5V.SchDoc, 5V_to_15V.SchDoc, BOM_UltraZohm_DigitalVoltage_3V3_to_15V_output.xlsx, BOM_UltraZohm_DigitalVoltage_3V3_to_3V3_IO.xlsx, BOM_UltraZohm_DigitalVoltage_3V3_to_5V_IO.xlsx, BOM_UltraZohm_DigitalVoltage_3V3_to_RS422_output.xlsx, BOM_UltraZohm_DigitalVoltage_RS422_to_3V3_input.xlsx, DifferentialToSingle.SchDoc]
2021-03-05 Adjusted position of designator and value on assembly drawing
2021-03-05 Adapted output job for assembly drawings
2021-03-05 Generated Production Files and updated output job. Fixes #13
    [BOM_UltraZohm_DigitalVoltage_3V3_to_15V_output.xlsx, BOM_UltraZohm_DigitalVoltage_3V3_to_3V3_IO.xlsx, BOM_UltraZohm_DigitalVoltage_3V3_to_5V_IO.xlsx, BOM_UltraZohm_DigitalVoltage_3V3_to_RS422_output.xlsx, BOM_UltraZohm_DigitalVoltage_RS422_input_output.xlsx, BOM_UltraZohm_DigitalVoltage_RS422_to_3V3_input.xlsx, PAP_UltraZohm_DigitalVoltage_3V3_to_15V_output.csv, PAP_UltraZohm_DigitalVoltage_3V3_t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]
2021-08-18 changed font size of marking at dip switches and corrected numbering. Also corrected harness definition of 5V LS. Fixes #31
    [3V3_to_5V.SchDoc, Jumper5VLS.SchDoc, SignalBundling.SchDoc, SignalConditioning.SchDoc, TI_SN74LVCH16T245.SchDoc, TopSheet.SchDoc, ultrazohm_digital_voltage_3U_1vxx.PrjPCB]
2021-08-18 changed indeces on signals from carrier board and adjusted project options for signal naming. fixes #29
    [15V_PowerSupply.SchDoc, 3V3_to_5V.SchDoc, 5V_to_15V.SchDoc, DifferentialToSingle.SchDoc, DigitalCarrierPlug.SchDoc, Jumper5VLS.SchDoc, NetTieSingleAndDiff.SchDoc, SignalBundling.SchDoc]
2021-08-18 generated production files
    [BOM_UltraZohm_DigitalVoltage_3V3_to_15V_output.xlsx, BOM_UltraZohm_DigitalVoltage_3V3_to_3V3_IO.xlsx, BOM_UltraZohm_DigitalVoltage_3V3_to_5V_IO.xlsx, BOM_UltraZohm_DigitalVoltage_3V3_to_RS422_output.xlsx, BOM_UltraZohm_DigitalVoltage_RS422_input_output.xlsx, BOM_UltraZohm_DigitalVoltage_RS422_to_3V3_input.xlsx, PAP_UltraZohm_DigitalVoltage_3V3_to_15V_output.csv, PAP_UltraZohm_DigitalVoltage_3V3_t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]
2021-08-18 - renamed project files to be consistent with new naming scheme: UZ_D_Voltage - renamed revision to be consistent with new revision counting scheme: Rev04 -> we increase the Revision count every time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
    [UZ_D_Voltage.PrjPCB, ultrazohm_digital_voltage_3U_1vxx.PrjPCB]
2021-08-19 rename project output folder to new project name, so that new outputs will appear in this folder
    [3V3_to_15V.xls, 3V3_to_5V.xls, 3V3_to_diff.xls, BOM_UltraZohm_DigitalVoltage_3V3_to_15V_output.xls, BOM_UltraZohm_DigitalVoltage_3V3_to_15V_output.xlsx, BOM_UltraZohm_DigitalVoltage_3V3_to_3V3_IO.xls, BOM_UltraZohm_DigitalVoltage_3V3_to_3V3_IO.xlsx, BOM_UltraZohm_DigitalVoltage_3V3_to_5V_IO.xls]
2021-08-23 corrected project name in procject options parameters' and transferred it the pcb file
    [UZ_D_Voltage.PrjPCB]
2021-08-25 generated new output files and verified if they work on JLCPCB which is the case
    [BOM_UZ_D_Voltage_3V3_to_15V_output.xlsx, BOM_UZ_D_Voltage_3V3_to_3V3_IO.xlsx, BOM_UZ_D_Voltage_3V3_to_5V_IO.xlsx, BOM_UZ_D_Voltage_3V3_to_RS422_output.xlsx, BOM_UZ_D_Voltage_RS422_input_output.xlsx, BOM_UZ_D_Voltage_RS422_to_3V3_input.xlsx, BOM_UltraZohm_DigitalVoltage_3V3_to_15V_output.xlsx, BOM_UltraZohm_DigitalVoltage_3V3_to_3V3_IO.xlsx]
2025-11-12 Assembly variant corrected by setting resistor to be populated. Accounts for variants: RS422_input_output + RS422_to_3V3_input + 3V3_to_RS422_output
    [UZ_D_Voltage.PrjPCB]
2025-11-12 add output job and re-generate SCH, BOM, PP files for the three RS422 variants
    [BOM_JLC-UZ_D_Voltage(3V3_to_RS422_output).xlsx, BOM_JLC-UZ_D_Voltage(RS422_input_output).xlsx, BOM_JLC-UZ_D_Voltage(RS422_to_3V3_input).xlsx, BOM_UZ_D_Voltage_3V3_to_RS422_output.xlsx, BOM_UZ_D_Voltage_RS422_input_output.xlsx, BOM_UZ_D_Voltage_RS422_to_3V3_input.xlsx, Pick Place for UZ_D_Voltage(3V3_to_RS422_output).csv, Pick Place for UZ_D_Voltage(RS422_input_output).csv]
